heartpolik/hardware-pocket-mixer/digital-mixer/README.md

# digital-mixer

Портативний цифровий стереомікшер з USB-аудіоінтерфейсом. Від teenage engineering TX-6 беремо
формфактор і функції (EQ, компресор, ефекти, cue, сцени, MIDI, рекордер), але не схемотехніку.

> [!NOTE]
> Стан: плата розведена ([docs/04-pcb.md](docs/04-pcb.md)), прошивка 0.2 з емулятором ([docs/06-firmware.md](docs/06-firmware.md)), схема — [docs/03-schematic.md](docs/03-schematic.md); ТЗ — [docs/01-spec.md](docs/01-spec.md), дослідження — [docs/00-research.md](docs/00-research.md). Наступний крок — макет на готових
> платах: Teensy 4.1 + PCM1865 + PCM5102A, перевірка USB-аудіо 8 каналів у Windows, macOS та iOS.

```mermaid
flowchart LR
    IN(["4 стерео входи"]) --> ADC["2 × PCM1865<br/>TDM"] --> T["Teensy 4.1<br/>мікс, EQ, компресор,<br/>2 FX-шини, метри"]
    T --> DAC["3 × PCM5102A"] --> OUT(["MAIN, AUX,<br/>навушники"])
    T <-->|"USB HS: 8 вх / 2 вих,<br/>MIDI"| PC(["DAW"])
    T --> SD[("microSD<br/>рекордер")]
    UI["Фейдери, 12 енкодерів,<br/>кнопки, дисплей 1,47″"] <--> T
```

| Документ | Зміст |
|---|---|
| [docs/00-research.md](docs/00-research.md) | TX-6, варіанти архітектури, канали й USB, живлення, функції, ризики |
| [docs/01-spec.md](docs/01-spec.md) | **ТЗ Rev 1:** функціонал, керування, роз'єми, ТТХ |
| [docs/02-components.md](docs/02-components.md) | Фейдери, енкодери, живлення 1S, монтаж Teensy, AliExpress чи JLCPCB |
| [docs/03-schematic.md](docs/03-schematic.md) | **Принципова схема** (KiCad, [PDF](hw/main/main.pdf)), виводи Teensy, макет розташування |
| [docs/04-pcb.md](docs/04-pcb.md) | **Плата:** чотиришарова 104,5 × 136,5 мм (компоновка C), Teensy на гребінках з PSRAM (DM35), розведена, DRC 0 порушень, 0 розривів |
| [docs/05-fab.md](docs/05-fab.md) | **Виготовлення:** Gerber, BOM, файли PCBA для NextPCB, [інтерактивний BOM](docs/ibom/ibom.html), порядок ручного монтажу |
| [docs/07-review.md](docs/07-review.md) | **Перевірка перед замовленням:** що знайдено й виправлено, що перевірено, що звірити; покращення до наступної версії |
| [docs/06-firmware.md](docs/06-firmware.md) | **Прошивка й емулятор:** ядро C++ ([firmware/](firmware/README.md)), емулятор на SDL2, керування, ефекти, MIDI CC, що перевірити на макеті |
| [docs/calc/](docs/calc/power.py) | Розрахунок живлення |
| [docs/decisions.md](docs/decisions.md) | Журнал рішень цифрового підпроєкту (DM1…) |
| [docs/datasheets/](docs/datasheets/README.md) | Datasheets цього підпроєкту |

З аналогового [Rev A](../analog-mixer/README.md) переносимо деталі там, де вони підходять:
USB-C GCT USB4085, захист USBLC6-2SC6, MBR0530 і AO3401A (load sharing).

## Ліцензія

SPDX-License-Identifier: GPL-3.0-or-later — повний текст у [LICENSE](LICENSE). Стосується всього в
`digital-mixer/`: схеми, плати, бібліотек, документації й прошивки (DM36).

Цифрова версія не є похідною від mixerli: файлів звідти в ній немає (джеки — PJ-327A, footprint і модель
згенеровано тут за кресленням продавця, DM38). Чужі файли зберігають свої ліцензії:
символ Teensy 4.1 від XenGi — MIT ([hw/lib/third_party](hw/lib/third_party/LICENSE-teensy_library.txt));
стандартні бібліотеки KiCad — за їхньою ліцензією з винятком для проєктів; datasheets — власність
виробників.
