heartpolik/hardware-pocket-mixer/docs/datasheets/README.md

# Datasheets

Усі datasheets і креслення, на які посилається документація. Нові файли кладемо сюди й
додаємо рядок у таблицю. Позначка «mixerli» означає, що файл узято з
[mixerli/documentation/datasheets](https://github.com/stahlnow/mixerli/tree/master/documentation/datasheets).

| Файл | Компонент | Де використано | Джерело |
|---|---|---|---|
| [adg1436.pdf](adg1436.pdf) | ADI ADG1436, dual SPDT ±15 V, rev. B | ключі Mute, моно/стерео (D21, D31) | analog.com, поклав користувач |
| [dg411-dg413-vishay.pdf](dg411-dg413-vishay.pdf) | Vishay DG411/412/413, rev. E 2007 | кандидат ключів: DG413 (06, п. 3.0) | CERN mirror |
| [dg403.pdf](dg403.pdf) | Intersil/Renesas DG401/DG403, FN3284.11 | запасний ключ | CERN mirror |
| [MCP23017.pdf](MCP23017.pdf) | Microchip MCP23017, DS20001952D | розширювач: ключі | microchip.com |
| [MCP23008.pdf](MCP23008.pdf) | Microchip MCP23008, DS20001919F | розширювач: кнопки Mute | microchip.com |
| [ads7828.pdf](ads7828.pdf) | TI ADS7828, 12 біт, 8 каналів, I²C | АЦП метрів | ti.com |
| [esp32-c3_datasheet_en.pdf](esp32-c3_datasheet_en.pdf) | Espressif ESP32-C3, v2.4 | MCU (D27) | espressif.com |
| [tps62933o.pdf](tps62933o.pdf) | TI TPS6293x, SOT-583 | buck 5 V (D22) | ti.com |
| [1930f.pdf](1930f.pdf) | ADI/LT LT1930/LT1930A, boost | +12 V (D18) | mixerli |
| [1931fa.pdf](1931fa.pdf) | ADI/LT LT1931/LT1931A, інвертор | −12 V (D18) | mixerli |
| [sumida_CR43_Series-464629.pdf](sumida_CR43_Series-464629.pdf) | Sumida CR43, дросель | +12 V | mixerli |
| [sumida_CLS62-334945.pdf](sumida_CLS62-334945.pdf) | Sumida CLS62, спарений дросель | −12 V | mixerli |
| [74404054680-321151.pdf](74404054680-321151.pdf) | Würth 74404054680, дросель | mixerli v2 | mixerli |
| [opa1678.pdf](opa1678.pdf) | TI OPA167x, аудіо op-amp | кандидат для тракту (07) | ti.com |
| [tl062.pdf](tl062.pdf) | TI TL06x (TL061/062/064), low-power JFET op-amp | детектори метрів: TL064AC (D34, 08) | ti.com |
| [NJM4580_E-218114.pdf](NJM4580_E-218114.pdf) | Nisshinbo NJM4580, dual op-amp | аудіотракт | mixerli |
| [RS__1-1370683.pdf](RS__1-1370683.pdf) | Alps RS Super Slide, каталог | фейдери (D1, D23) | mixerli |
| [RK14K12-1370745.pdf](RK14K12-1370745.pdf) | Alps RK14K, каталог | send, pan, навушники (D10, D26) | mixerli |
| [pta.pdf](pta.pdf) | Bourns PTA, фейдери | альтернатива | mixerli |
| [PTVPTT-56034.pdf](PTVPTT-56034.pdf) | Bourns PTV/PTT, ротатори | альтернатива | mixerli |
| [SSSS9-1370708.pdf](SSSS9-1370708.pdf) | Alps SSSS9, слайд-перемикач | вимикач живлення | mixerli |
| [alps-rsxx1-series.pdf](alps-rsxx1-series.pdf) | Alps RS□□1 Super Slide, каталог 2026 | **`RS451121400A`, кресл. 20** (D1, D23) | користувач |
| [sj-4351x-smt-series.pdf](sj-4351x-smt-series.pdf) | CUI SJ-4351X-SMT, джек 3,5 мм TRRS | усі джеки (D8) | користувач |
| [dg417l.pdf](dg417l.pdf) | **Maxim** DG417L/418L/419L, ±4,5…±20 V | запасний ключ | користувач |
| [ip2326.pdf](ip2326.pdf) | Injoinic/ChipSourceTek IP2326, 2S/3S boost-зарядка (китайською) | модуль заряджання (D16) | користувач |
| [CH340DS1.pdf](CH340DS1.pdf) | WCH CH340 (усі варіанти), версія 3B | міст USB-UART CH340N (D40) | SparkFun CDN |
| [esp32-c3-supermini.pdf](esp32-c3-supermini.pdf) | ESP32-C3 SuperMini: розпиновка, **принципова схема**, розміри | MCU (D27, D40) | користувач |
| [img/esp32-c3-supermini.jpg](img/esp32-c3-supermini.jpg) | розпиновка ESP32-C3 SuperMini | MCU (D27) | mini-tech.com.ua |
| [nichicon-uep.pdf](nichicon-uep.pdf) | Nichicon UEP, неполярні електроліти (bi-polarized), радіальні | вхідні 10 µF (D38, D44), вихідні 47 µF | chipdip mirror |
| [bourns-srn4018.pdf](bourns-srn4018.pdf) | Bourns SRN4018, дроселі 4 × 4 мм | 4,7 µH для TPS62933O (D46) | bourns.com |
| [sn74ahct1g125.pdf](sn74ahct1g125.pdf) | TI SN74AHCT1G125 | перетворювач рівня даних LED | ti.com |
| [cts-204.pdf](cts-204.pdf) | CTS Series 204 DIP, rev. D 2021 | моно/стерео: 204-125ST (D47) | користувач |
| [oled-0.96-128x64-4pin.pdf](oled-0.96-128x64-4pin.pdf) | OLED 0,96" 128×64 SSD1306, 4 виводи (Rajguru) | дисплей | користувач |
| [alps-ec12d.pdf](alps-ec12d.pdf) | Alps EC12E/EC12D, енкодери 12 мм | енкодер: референс EC12D з кнопкою | користувач |
| [SK6812MINI-E.pdf](SK6812MINI-E.pdf) | OPSCO SK6812MINI-E, адресний RGB LED, Rev. 04 | індикація (D36) | akizukidenshi.com |
| [MX2A_RED-Datasheet-EN_US.pdf](MX2A_RED-Datasheet-EN_US.pdf) | Cherry MX2A Red | кнопки Mute (D30) | SparkFun CDN |
| [ujc-hp-3-smt-tr.pdf](ujc-hp-3-smt-tr.pdf) | CUI UJC-HP-3-SMT-TR, USB-C power-only | mixerli; у нас замінюється (D25) | mixerli |
| [MCP73831-Family-Data-Sheet-DS20001984H.pdf](MCP73831-Family-Data-Sheet-DS20001984H.pdf) | Microchip MCP73831 | mixerli; у нас скасовано (D16) | mixerli |
| [shouhan-msk12c02.pdf](shouhan-msk12c02.pdf) | SHOU HAN MSK12C02, SPDT слайд, SMD, повзунок убік; креслення й посадкове місце (с. 1) | **вимикач живлення (D51)** | LCSC C431540 |
| [ao3401a.pdf](ao3401a.pdf) | AOS AO3401A, P-MOSFET −30 V, SOT-23, rev 3.1 | ключ живлення (D51) | aosmd.com |
| [sungmun-ssi-10.pdf](sungmun-ssi-10.pdf) | Sungmun SSI-10 (колишня BSI-10), слайд THT, 12 V 0,5 A | розглянуто для вимикача (D51) | LCSC |
| [sungmun-ssi-nsi-10-catalog.pdf](sungmun-ssi-nsi-10-catalog.pdf) | Sungmun SSI / NSI-10 / NSI-20, каталог: варіанти H, S, HS | розглянуто (D51): NSI-10HS має повзунок угору | elitaliaweb.it |
| [pcm1865.pdf](pcm1865.pdf) | TI PCM186x, SLAS831D, АЦП 4 канали, TSSOP-30 | дослідження цифрового варіанту ([16](../16-digital.md)) | ti.com |
| [pcm5102a.pdf](pcm5102a.pdf) | TI PCM510xA, ЦАП стерео 2,1 Vrms, TSSOP-20 | дослідження цифрового варіанту ([16](../16-digital.md)) | ti.com |

## Ще не знайдено

| Компонент | Що потрібно | Чому немає |
|---|---|---|
| C&K JS (слайд SPDT) | креслення | ckswitches.com не віддає PDF скрипту |
