heartpolik/hardware-pocket-mixer/digital-mixer/docs/datasheets/README.md

# Datasheets — цифровий мікшер

Datasheets, на які посилається документація цифрового підпроєкту. Спільні з аналоговим —
у [analog-mixer/docs/datasheets](../../../analog-mixer/docs/datasheets/README.md).

| Файл | Компонент | Де використано | Джерело |
|---|---|---|---|
| [pcm1865.pdf](pcm1865.pdf) | TI PCM186x, SLAS831D, АЦП 4 канали, TSSOP-30 | АЦП входів ([00](../00-research.md), п. 5) | ti.com |
| [pcm5102a.pdf](pcm5102a.pdf) | TI PCM510xA, ЦАП стерео 2,1 Vrms, TSSOP-20 | ЦАП виходів ([00](../00-research.md), п. 5) | ti.com |
| [tps63802.pdf](tps63802.pdf) | TI TPS63802, buck-boost 2 A, VSON-10 | живлення 1S ([02](../02-components.md), п. 4) | ti.com |
| [lp5907.pdf](lp5907.pdf) | TI LP5907, LDO 250 mA, малошумний | 3,3 V аналог кодеків ([02](../02-components.md), п. 4) | ti.com |
| [tp4056.pdf](tp4056.pdf) | NanJing Top Power TP4056, лінійний заряд 1S 1 A | заряд ([02](../02-components.md), п. 4) | sparkfun.com |
| [bourns-pec09.pdf](bourns-pec09.pdf) | Bourns PEC09, енкодер 9 мм, rev. 09/19 | порівняння енкодерів ([02](../02-components.md), п. 3) | bourns.com |
| [tpa6132a2.pdf](tpa6132a2.pdf) | TI TPA6132A2, підсилювач навушників DirectPath, WQFN-16 | навушники ([03](../03-schematic.md)) | ti.com |
| [kailh-choc-pg1350.pdf](kailh-choc-pg1350.pdf) | Kailh PG1350 (CPG135001D01), креслення й характеристики | розглянуто (DM13, скасовано DM16) | adafruit.com (копія Kailh) |
| [midi-electrical-spec-update.pdf](midi-electrical-spec-update.pdf) | MMA CA-033, MIDI 1.0 Electrical Specification Update (2014) | MIDI OUT 3,3 V ([03](../03-schematic.md)) | midi.org |
| [gmt147-01m-drawing.webp](gmt147-01m-drawing.webp) | GMT147-01M (GMT147SPI) 1.47in TFT, креслення продавця: розміри, гребінка 8 × 2,54, отвори | footprint `LCD_GMT147SPI` | від користувача (продавець) |
| [tsf-1266-drawing.png](tsf-1266-drawing.png) | TSF-1266 6 × 6 × 5 SMT tact, креслення й посадкове місце | footprint `SW_TSF-1266_6x6mm_SMD` | від користувача (продавець) |
| [push-latching-dpdt-5.8-7mm-drawing.png](push-latching-dpdt-5.8-7mm-drawing.png), [push-latching-dpdt-7mm-pins.png](push-latching-dpdt-7mm-pins.png) | кнопка з фіксацією DPDT 5,8 / 7 мм (вивідна), креслення й схема контактів | розглянуто (DM17, замінено DM27) | від користувача (продавець) |
| [push-latching-dpdt-5.8mm-smd-drawing.png](push-latching-dpdt-5.8mm-smd-drawing.png) | кнопка з фіксацією DPDT 5,8 × 5,8 SMD: розміри, ніжки, схема FREE / PUSH, DC 30 V 0,1 A | footprint `SW_Push_Latching_DPDT_5.8mm_SMD` (DM27) | від користувача (продавець) |
| [ec12sy-smd-encoder-drawing.png](ec12sy-smd-encoder-drawing.png) | енкодер EC12SY-H6-…-SMD з кнопкою: корпус, вал, посадкове місце | footprint `RotaryEncoder_EC12SY_SMD` (DM26) | від користувача (продавець) |
| `gct-usb4110.pdf` (у git не кладемо: креслення GCT позначене як конфіденційне) | GCT USB4110, USB-C 2.0 SMT, креслення rev. B4 | USB-C (DM30), стоковий footprint KiCad, 3D-модель | [gct.co/files/drawings/usb4110.pdf](https://gct.co/files/drawings/usb4110.pdf) — завантажити браузером у цю теку |
| [bourns-pta.pdf](bourns-pta.pdf) | Bourns PTA, повзункові потенціометри, rev. 08/25 | фейдер PTA2043 (DM8; замінено DM39) | bourns.com |
| [teensy41-dimensions.png](teensy41-dimensions.png), [teensy41-card-back.png](teensy41-card-back.png) | PJRC Teensy 4.1: розміри, картка виводів (зворот) | footprint `Teensy41_SMD` | pjrc.com |
| [coilcraft-xfl4015.pdf](coilcraft-xfl4015.pdf) | Coilcraft XFL4015, Doc 769, rev. 03/10/26 | дросель TPS63802 | coilcraft.com |
| [mcp23017.pdf](mcp23017.pdf) | Microchip MCP23017/MCP23S17, DS20001952D, розширювач 16 GPIO I²C | регістри розширювачів у прошивці ([06](../06-firmware.md), п. 6) | microchip.com |
| `st7789v.pdf` (у git не кладемо: позначений «Sitronix Confidential») | Sitronix ST7789V v1.3 (2014/03), контролер TFT 240 × 320 | драйвер дисплея GMT147SPI ([06](../06-firmware.md), п. 6) | [newhavendisplay.com](https://www.newhavendisplay.com/appnotes/datasheets/LCDs/ST7789V.pdf) — завантажити в цю теку |
| [pj-327a-hooya.pdf](pj-327a-hooya.pdf) | HOOYA (Haoyu) PJ-327A, джек 3,5 мм SMT 5 виводів, rev. A1 2020: розміри, **посадкове місце** (5 × 1,6 × 2,9), схема контактів | звірка footprint PJ-327A (DM38) | lcsc.com, C19712376 |
| [pj-327a-xkb.pdf](pj-327a-xkb.pdf) | XKB PJ-327AX-SMT, rev. A1 2024: розміри, посадкове місце, схеми варіантів A0–A5 | звірка footprint PJ-327A (DM38) | lcsc.com, C381135 |
| [pj-327a-sofng.pdf](pj-327a-sofng.pdf) | SOFNG PJ-327A: розміри, характеристики 0,25 A 12 V | звірка footprint PJ-327A (DM38) | lcsc.com, C22355751 |
| [pj-327a-seller-drawing.jpg](pj-327a-seller-drawing.jpg) | PJ-327A 5 виводів, креслення продавця AliExpress: розміри, посадкове місце (5 × 2 × 3, ±0,1), схема контактів | footprint `Jack_3.5mm_PJ-327A_SMT_Horizontal` (DM38) | від користувача (продавець, [AliExpress](https://www.aliexpress.com/item/1005006127348664.html)) |
| [alps-rs-super-slide.pdf](alps-rs-super-slide.pdf) | Alps Alpine RS□□1 Super Slide (Standard Type), каталог с. 386–397: лінійка, **креслення № 1 — RS201111J011** (35 × 8, хід 20, отвори 3 × Ø1,5: 25 і 3,75 мм, 2 × M2 зверху), характеристики | footprint `Potentiometer_Alps_RS20111_Single_Slide`, 3D-модель (DM39) | static.chipdip.ru (копія каталогу Alps) |
| [fader-rs20111-seller-photo.png](fader-rs20111-seller-photo.png), [fader-rs20111-seller-drawing.png](fader-rs20111-seller-drawing.png), [fader-rs20111-seller-pins.png](fader-rs20111-seller-pins.png), [fader-rs20111-seller-holes.png](fader-rs20111-seller-holes.png) | фейдер Alps 147C-10KB (AliExpress): фото з важелем 15 мм, креслення, схема виводів, отвори — збігаються з кресленням № 1 Alps | фейдер (DM39) | від користувача (продавець) |
