heartpolik/hardware-pocket-mixer/analog-mixer/docs/spec-rev-a.md

# Portable 4-Channel Stereo Mixer — Rev A

Повне ТЗ і контекст проєкту (handoff).

- **Актуально на:** 24 жовтня 2026
- **Мова:** українська
- **Статус:** вимоги й попередня архітектура визначені. Повна перевірена схема,
  KiCad PCB, BOM і Gerber-файли ще **НЕ** створені. Цей документ — handoff,
  а не твердження про готовий дизайн.

## 1. Мета

Розробити компактний портативний аналоговий 4-канальний стереомікшер для
синтезаторів, драм-машин, семплерів та інших line-level пристроїв. ESP32-C3
потрібен для UI, дисплея, метерів і логіки кнопок; цифрової обробки звуку в
Rev A немає.

Пріоритети: компактність, реальні компоненти з доступністю/доставкою в Україну,
можливість ручного монтажу, ремонтопридатність. Перевага TSSOP над QFN там, де є
технічно адекватний вибір; пасивні компоненти переважно 0805. Усі компоненти та
footprint мають бути підтверджені до замовлення PCB.

## 2. Функціональне ТЗ

### Аудіо

> **Рішення D4 (24.10.2026):** додано FX-петлю за зразком mixerli: 4 post-fader
> стерео send-ротатори → SEND OUT, вхід 5 = стерео return із фейдером, без send.
> Див. [decisions.md](decisions.md).

- 4 незалежні стереовходи, роз’єми 3,5 мм TRS.
- Стереовихід Line Out L/R.
- Окремий вихід навушників із відповідним підсилювачем.
- Аналоговий звуковий тракт, без DSP у Rev A.
- Не з’єднувати L/R між собою для метерів; стереоканали мають залишатися
  незалежними.

### Фейдери

> **Рішення 24.10.2026:** канали — Alps `RS451121400A` (dual 10k B, хід 45 мм,
> довжина 60 мм). Це відміняє вимогу ходу 20–30 мм нижче. Деталі й кандидат на
> Master — [01-faders.md](01-faders.md).

- 4 стереофейдери каналів: по одному dual-gang slider на канал, який одночасно
  регулює L і R.
- 2 незалежні монофейдери Master: один для L, один для R.
- Бажано паяти фейдери безпосередньо на верхню плату.
- Бажаний хід компактних фейдерів: приблизно 20–30 мм; 45 мм загальної довжини
  корпуса — запасний варіант, якщо механічно підходить.
- 10 kΩ — попередній кандидат, але остаточний номінал залежить від топології,
  джерельних і навантажувальних імпедансів.
- B10K зазвичай означає лінійну характеристику; A/log — аудіо/логарифмічну, але
  маркування треба перевіряти для конкретного виробника.
- Для каналів потрібні саме dual-gang фейдери з двома електрично окремими
  секціями. Для Master — два окремі mono бажаніші за використання лише однієї
  секції dual-gang.

### Кнопки та UI

- По одній кнопці на канал.
- Коротке натискання канальної кнопки: Mute toggle.
- Утримувати кнопку енкодера (Shift) і натиснути канальну кнопку: Solo toggle.
- Енкодер: обертання — навігація/регулювання; коротке натискання —
  підтвердження в меню.
- Solo non-destructive: не змінює збережений стан Mute.
- Якщо активний хоча б один Solo, звучать лише канали із Solo, які не в Mute.
- Mute має пріоритет над Solo.
- У прошивці передбачити debounce та визначити поведінку одночасних/довгих
  натискань.

### Дисплей і LED

- OLED 128×64.
- Показувати 4 канальні метри, Master L/R, CLIP і стан батареї.
- 6 адресних RGB LED: 4 каналам (статус/clip), 2 Master L/R (clip).
- Один data GPIO для WS2812/SK6812-сумісних LED.
- Обмежити яскравість програмно. Якщо LED живляться від 5 V, перевірити потребу
  level shifter; передбачити серійний резистор data та локальний bulk capacitor.
- Не дозволяти LED-струмам і ESP32/boost шуміти в аналоговому тракті.

### Живлення

> **Рішення D5 (24.10.2026):** аналог живиться від ±12 V, цифра — від окремого 5 V.
> Рейл 5 V + VREF для аудіо з розділу 5 скасовано. Див. [decisions.md](decisions.md).

- Однокомірковий LiPo pouch, початковий орієнтир 1500 mAh.
- USB-C для заряджання.
- Кандидат зарядного контролера з power-path: BQ24074.
- Кандидат boost до 5 V: TPS61023.
- Акумулятор має бути захищеним або захист треба реалізувати на платі.
- Перевірити USB-C CC-резистори, захист входу, струм заряджання під конкретну
  батарею, тепловиділення, вимірювання напруги, роботу під час заряджання,
  пікове споживання та EMI boost-конвертера.
- BQ24074/TPS61023 — кандидати, не затверджена схема живлення.

## 3. Дві плати

> **Рішення D19 (24.10.2026):** фейдери й ротатори стоять на нижній аналоговій платі.
> Цифрова плата (ESP32, OLED, кнопки, LED) — зверху, лише над зоною задніх джеків.
> Опис нижче частково застарів. Див. [decisions.md](decisions.md).

### Верхня плата — controls/UI/faders

- 4 dual-gang канальні фейдери.
- 2 mono Master-фейдери.
- 4 кнопки каналів, енкодер із кнопкою.
- OLED, ESP32-C3 SuperMini або інший перевірений ESP32-C3-модуль.
- 6 адресних RGB LED.
- Допоміжні компоненти й роз’єми.

Це не суто цифрова плата: фейдери несуть аналоговий аудіосигнал. Трасувати ці
сигнали окремо від шумних цифрових/силових ліній із контрольованими шляхами
повернення струму.

### Нижня плата — analog/audio/power

- 4 TRS входи 3,5 мм.
- Line Out L/R і вихід навушників.
- Буфери та суматор.
- Аналогова реалізація Mute/Solo.
- Детектори піків/огинаючої для метерів.
- Headphone amp.
- Живлення/заряджання/батарейний інтерфейс, якщо розміщення не погіршує
  шум/механіку.
- ADC, якщо він потрібен після остаточного вибору архітектури метерів.

### Міжплатне з’єднання

- Попередня ідея: PLS/PBS pin/socket headers.
- Перед PCB створити перевірену таблицю pinout: аудіо L/R, керування, живлення,
  землі/повернення, метер-сигнали.
- Виділити достатньо ground pins і не вести чутливе аудіо без потреби поруч із
  LED/тактовими/boost сигналами.
- Не розділяти AGND/DGND на ізольовані острови автоматично: важливі реальні
  шляхи струму повернення та компонування.

## 4. Попередні електронні кандидати (не фінальні)

| Вузол | Кандидат | Що перевірити |
|---|---|---|
| MCU | ESP32-C3 SuperMini | точна плата, габарити, GPIO, USB, струм |
| Quad op-amp | TLV9064 | корпус, шум, headroom, навантаження, стабільність |
| Headphone amp | TPA6130A2 | QFN 4×4 складний для ручного монтажу; оцінити альтернативи |
| ADC | MCP3208 | чи потрібен окремий ADC взагалі |
| Charger/power path | BQ24074 | схема USB-C, power-path, струм/тепло |
| Boost | TPS61023 | струм, ефективність, EMI, доступність |
| TRS jacks | SJ-43514-SMT-TR або SJ-43504-SMT  | footprint, механіка, availability |
| RGB LED | WS2812/SK6812-сумісні | конкретний корпус, живлення, data level |
| Faders | 10k dual/single gang | див. розділ 7 |

## 5. Аналоговий тракт і попередні розрахунки

У попередньому концепті обговорювалися:

- 5 V analog rail і VREF близько 2,5 V;
- TLV9064;
- інвертувальний суматор: Rf 3,3 kΩ, Rin 22 kΩ, коефіцієнт внеску каналу
  близько −0,15;
- вхідні coupling caps близько 2,2 µF;
- вихідні coupling caps 10 або 47 µF залежно від вузла;
- серійний вихідний резистор близько 100 Ω;
- VREF з дільника 10 kΩ і фільтрацією близько 47 µF.

Це лише стартові припущення. Не переносити їх у фінальну схему без перерахунку й
перевірки. Потрібні аналіз headroom на 5 V, джерельних імпедансів, завантаження
фейдерів, worst-case сумування 4 сигналів, вихідного навантаження, шуму,
DC-offset, кліпінгу та headphone drive.

Раніше як приклад рахували чотири синфазні входи по 2 Vrms при коефіцієнті 0,15
на кожен: приблизно 1,2 Vrms на сумі (1,70 V peak) навколо VREF. Цей результат
не є гарантією запасу до кліпінгу — перевірити для повної топології.

### Mute/Solo

Потрібно вибрати конкретну аналогову реалізацію: analog switch, FET/транзистор
або іншу схему. Перевірити on-resistance, leakage, distortion, рівні керування,
клацання/pop і доступність. Не підключати GPIO безпосередньо до аудіосхеми без
перевірки електричних параметрів.

### Метри

- Не з’єднувати L/R.
- Один канальний метр може показувати max(envelope(L), envelope(R)) після
  окремих детекторів або коректної ізольованої логіки.
- Master L/R бажано міряти окремо.
- Визначити attack/release, масштабування для ADC та семантику CLIP: реальний
  кліпінг, near-clip threshold чи оцінка рівня.

## 6. Механіка та тестові точки

> **Рішення 24.10.2026:** фіксованого габариту немає. KPI — мінімальний корпус,
> який дозволяє обрана елементна база (фейдери, роз’єми, батарея, OLED).
> Габарит виводиться з компонування в кроці B, а не задається наперед.

~~Попередній габарит корпусу: 100–115 × 60–75 × 20–28 мм~~ — скасовано.

Перед outline/footprints:

1. Зібрати datasheet/механічні креслення фейдерів, роз’ємів, OLED, енкодера,
   кнопок, батареї.
2. Намалювати top-view у масштабі.
3. Перевірити хід фейдерів, відступи ручок, USB-C, глибину батареї, висоту
   роз’ємів і міжплатний роз’єм.
4. Переконатися, що корпус не тисне на LiPo.

Не створювати footprint фейдера за фото без підтвердження розмірів, виводів,
монтажних лапок, pin numbering і відповідності двох секцій.

Попередні test points (остаточна кількість залежить від схеми):

- +5V, VREF, GND у кількох місцях;
- входи після фейдерів L/R × 4;
- SUM L/R;
- MASTER L/R;
- LINE OUT L/R;
- ENV1–ENV4;
- ENV_MASTER_L/R;
- BAT.

Цільовий діаметр тестових pad близько 1,5–2 мм, підписані на silk, із доступною
землею поблизу.

## 7. Пошук фейдерів — стан на 24.10.2026

### Параметри

Канали: 4 × stereo dual-gang; Master: 2 × mono. Бажаний хід 20–30 мм.

10 kΩ — лише попередній номінал. Потрібно знайти компоненти, які реально можна
замовити на AliExpress із доставкою в Україну. Не замовляти партію до перевірки
pinout і механіки.

### Раніше знайдені варіанти в Україні

1. **ZTDE 10kBx2 stereo**, заявлені загальна довжина 45 мм і хід 30 мм,
   приблизно 92 грн:
   <https://prom.ua/ua/p2833891052-fejder-dlya-klavish.html>
   Перевірити розміри, pinout, актуальну наявність. B10K лінійний — можливо для
   прототипу, але відчуття гучності відрізняється від log.
2. **APAI Electronics 10kAx2 stereo**, заявлені довжина 75 мм і хід 60 мм,
   приблизно 104 грн:
   <https://prom.ua/ua/p2829398551-fejder-dlya-mikshernyh.html>
   Ймовірно завеликий.
3. **ALPHA 73 mm B10K**, близько 363 грн, раніше в оголошенні було 3 шт.:
   <https://djservice.com.ua/ua/p2166542978-fejder-alpha-73mm.html>
   Перевірити, mono чи dual-gang; не пріоритетний через розмір/ціну.
4. **Generic 75 mm stereo B10K**:
   <https://rozetka.com.ua/ua/483070344/p483070344/>
   Завеликий для бажаного компактного формату.

### Попередні AliExpress посилання — НЕ вважати підтвердженими

- Кандидат на mono B10K близько 45 мм:
  <https://www.aliexpress.com/item/1005009291972560.html>
- Кандидат на dual-gang stereo 10k, у назві/описі фігурував хід близько 60 мм:
  <https://www.aliexpress.com/item/1005010483791687.html>
- Пошукова добірка:
  <https://www.pricearchive.org/search/aliexpress.com/alps-%D1%81%D0%BB%D0%B0%D0%B9%D0%B4-%D0%BF%D0%BE%D1%82%D0%B5%D0%BD%D1%86%D0%B8%D0%BE%D0%BC%D0%B5%D1%82%D1%80%D1%8B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>

Ці AliExpress посилання раніше не були достатньо перевірені за механічним
кресленням, pinout і реальним варіантом товару. Два згадані mono-кандидати
виявилися одним і тим самим оголошенням — попередню відповідь потрібно виправити
під час наступного пошуку.

### Наступний пошук

Пошукові фрази:

- `dual gang slide potentiometer 10k B10K 30mm travel`
- `stereo slider potentiometer 10k 20mm travel`
- `mini stereo slide potentiometer 6 pin 10k`
- `dual linear slider potentiometer 10k PCB`

Шукати пару моделей однієї серії: dual-gang для каналів і mono для Master.
Перевіряти доставку до України, ціну/кількість, taper, габарити, хід, контакти й
кріплення. Запросити у продавця креслення або фото з лінійкою та pinout. Не
фіксувати footprint без підтвердження.

## 8. KiCad і фінальний пакет

Порядок:

1. Вибір компонентів і механіка.
2. Повна принципова схема.
3. Таблиця pinout між платами.
4. Розрахунки audio headroom, power budget, Mute/Solo, метерів і шуму.
5. KiCad-проєкт із двома платами.
6. ERC: виправити або обґрунтувати кожну помилку/попередження.
7. Footprints лише за підтвердженими datasheet/розмірами.
8. PCB placement/routing з урахуванням аналогових, цифрових і силових струмів.
9. DRC і виправлення критичних помилок.
10. BOM із MPN, корпусом, кількістю, джерелом і статусом підтвердження.
11. Gerber/drill, PDF-схеми, монтажні креслення, за потреби pick-and-place.
12. Перевірити, що всі файли реально існують, відкриваються й узгоджені.

Фінальний пакет має включати KiCad project, PDF схем, PCB двох плат, BOM, pinout,
Gerber + drill, механічний план і інструкцію першого запуску.

## 9. Перевірка прототипу

- **Живлення:** USB-C, заряджання, захист батареї, idle/peak current, нагрівання,
  просідання boost, час роботи, шум конвертера.
- **Аудіо:** DC-offset, шум без сигналу, вплив ESP32/LED/boost, gain/headroom,
  кліпінг на 1 і 4 каналах, Mute/Solo clicks/bleed, headphone drive, L/R
  balance, стереотрекінг фейдерів, частотна характеристика й спотворення.
- **UI:** OLED, кнопки, encoder, debounce, Mute/Solo logic, метерне
  калібрування, attack/release, clip indication, обмеження LED-яскравості.
- **Механіка:** доступ до USB-C/роз’ємів, відсутність конфлікту ручок, міцність
  кріплення плат, відсутність тиску на LiPo.

## 10. Відкриті питання / ризики

1. Не обрані підтверджені компактні dual-gang і mono фейдери з AliExpress.
2. ~~Не підтверджений габарит корпуса.~~ Габарит не фіксується — мінімальний
   під елементну базу (див. розділ 6).
3. Не затверджена аналогова схема сумування й номінали.
4. Потрібно вибрати реалізацію Mute/Solo з низьким шумом і клацаннями.
5. TPA6130A2 може бути незручним для ручного монтажу через QFN; оцінити
   альтернативи.
6. Не визначено, чи потрібен MCP3208 або вистачить іншого способу зчитування
   метерів.
7. Не завершені power-path, USB-C, battery protection, peak-current та EMI
   перевірки.
8. Немає готових перевірених KiCad-файлів, PCB, BOM чи Gerber.
9. Наявність, ціни й доставка маркетплейсів змінюються — перевіряти перед
   закупівлею.

## 11. Конкретний план продовження

- **A. Фейдери:** знайти й підтвердити dual-gang 10k stereo 20–30 мм ходу та
  сумісний mono 10k для Master. Перевірити механіку, pinout, taper і доставку.
- **B. Механіка:** зробити масштабний top-view; після цього зафіксувати board
  outline.
- **C. Схема:** визначити повний signal flow: TRS inputs → coupling/protection →
  channel faders → Mute/Solo → summing/buffer → Master L/R → Line Out; окремо
  визначити headphone feed/control і метери.
- **D. Роз’єм між платами:** скласти pinout із групуванням аудіо, control, power
  і ground.
- **E. KiCad:** створити реальну схему, дві плати, BOM, ERC/DRC; потім
  виробничі файли.
