heartpolik/hardware-pocket-mixer/digital-mixer/docs/07-review.md

# 07. Перевірка перед замовленням плати

> [!NOTE]
> **28.10.2026**, плата після DM35 (Teensy на гребінках). Перевірка зі списку з'єднань схеми
> (`kicad-cli sch export netlist`), datasheet із [datasheets/](datasheets/README.md), розведеної плати
> (`hw/main/main_routed.kicad_pcb`) і прошивки. Що знайдено й виправлено — п. 1; що перевірено й гаразд —
> п. 2; що лишається звірити до або під час замовлення — п. 3. Після виправлень: **ERC 0, DRC 0 порушень, 0 розривів,
> 0 розбіжностей зі схемою**, ізольованих груп GND немає.

## 1. Знайдено й виправлено

| # | Що | Чим загрожувало | Виправлення |
|---|---|---|---|
| 1 | **Ємність на виході LP5907 (+3V3A) ≈ 61 µF** (10 µF біля LDO + 5 × 10 µF біля кодеків + 8 × 100 nF) | datasheet LP5907 (SNVS798Q, 5.6 «Capacitance for stability»): COUT 0,7…10 µF; поза межею стабільність не гарантована — можливе збудження й шум в аналоговому живленні АЦП / ЦАП | 2,2 µF біля LDO (CL31B225KBHNNNE) + 1 µF біля кожного кодека (CL31B105KBHNNNE) + 100 nF = ≈ 8 µF; корпус 1206 той самий — розводка не змінилась |
| 2 | **D− / D+ Teensy під його micro-USB** — у DM35 я написав «2-штирьова гребінка в отвори Teensy» | за кресленням PJRC площадки USB device — 1,78 мм від торця USB, тобто під корпусом роз'єму з іншого боку модуля: штир крізь модуль не пройде | на платі нічого не змінилось (наскрізні отвори 66 / 67 лишаються); монтаж — тонкі дроти від площадок модуля крізь наші отвори, пропаяні зверху ([05](05-fab.md), п. 5) |
| 3 | **Переходи в площадках SMD** після ручних латок (C49, R43, R44, TPA6132A2, C72) | при машинній пайці припій стікає в отвір — непропай; найгірше на QFN TPA6132A2 | п. 1.1 |
| 4 | Прошивка: при живленні від USB VSYS ≈ 4,7 В — показувало 100 % батареї | хибний заряд | понад 4,35 В — «USB» замість заряду |

### 1.1 Переходи в площадках

Переходи, свердло яких заходить у площадку SMD-деталі (свердло — 0,3 мм), до і після:

| Де | До | Після |
|---|---|---|
| U11 TPA6132A2, виводи 2–3 (GND, QFN 0,5 мм) | перехід GND на межі виводів | **прибрано**; земля підсилювача — доріжкою від виводу 10 до сусіднього переходу GND |
| R43.1 (AUX_OL), R44.1 (AUX_OR), C49.1 (+3V3A) | перехід на краю площадки | **відсунуто**, кожен зсув перевірено DRC |
| U3 TP4056, теплова площадка | перехід GND | лишено: перехід у тепловій площадці потрібен для відводу тепла |
| C72 (2,2 µF 0805, HPVDD підсилювача), обидві площадки | перехід GND і HP_HPVDD на краю площадки | **лишено**: у найщільнішому вузлі (ЦАП CUE / TPA6132A2) жодне положення не пройшло DRC, а перехід GND — єдиний зв'язок землі групи ЦАП з площиною. Ризик — недостатня пайка C72: після монтажу перевірити його під лупою; площадки великі, отвір заходить лише краєм |

## 2. Перевірено — гаразд

| Що | Як перевірено | Результат |
|---|---|---|
| Нумерація виводів символів | список з'єднань проти таблиць виводів datasheet: PCM1865 (SLAS831D, с. 10–11), TPS63802 (табл. 7-1), TPA6132A2 (Pin Functions), LP5907 SOT-23 (табл. 4-2), TP4056 (опис виводів), PCM5102A, MCP23017, USBLC6-2SC6, AO3401A, USB4110 | усі збігаються |
| Номінали | TPS63802: 0,5 В × (1 + 665k / 91k) = **4,15 В**; TP4056: RPROG 2,4 кОм → 500 мА, TEMP на GND (контроль температури вимкнено — захист у самому акумуляторі); TPA6132A2: G0 = G1 = 0 → −6 dB, вхід 26,4 кОм, 1 µF → зріз ≈ 6 Hz, HPVDD 2,2 µF, HPVSS і накачка 1 µF | відповідають datasheet |
| Розподіл живлення USB / батарея | Q1 AO3401A: затвор на VBUS, стягнутий 100 кОм (R19); внутрішній діод BAT+ → VSYS; MBR0530 VBUS → VSYS | правильно: без USB батарея живить через транзистор, з USB — назад у батарею не йде |
| Межі напруг | VBUS ≤ 10 µF (один C4) — вимога USB; EN TPS63802 від VSYS ≤ 6 В; VSYS / 2 на A14 ≤ 2,35 В; MCLK2 24,576 MHz при IOVDD 3,3 В (межа 50 MHz) | у межах |
| Логічні рівні | 3,3 В Teensy → XSMT PCM5102A, EN TPA6132A2 (≥ 1,3 В), MCP23017, SCKI PCM1865 (вхід XI 1,8 В не використано — на GND) | сумісні |
| Шини I²C | Wire: PCM1865 0x4A / 0x4B (MS/AD); Wire2: MCP23017 0x20 / 0x21 / 0x22 (A0 / A1); підтяжки 4,7 кОм на обох | без конфліктів адрес |
| Плата ↔ прошивка | 30 сигналів Teensy (символ XenGi → виводи Teensy) проти `firmware/src/teensy/pins.h`; біти трьох MCP23017 проти `controls.cpp`; адреси PCM1865, слоти TDM | збігаються |
| Footprint Teensy на гребінках | ряди за кресленням PJRC (вид зверху, USB ліворуч → ряд GND, 0…12, 3V3, 24…32 знизу); модуль на нижньому боці лицем назовні — KiCad дзеркалить footprint, тож знизу видно саме вид зверху модуля | правильно |
| Штирі вивідних деталей | хвости штирів фейдерів, дисплея (знизу) і Teensy (зверху) проти контурів деталей іншого боку, запас 0,5 мм | жодного перетину |
| DRC / відповідність схемі | `kicad-cli pcb drc --schematic-parity` | 0 порушень, 0 розривів, розбіжностей немає; попередження — шовкографія, напрямні отвори джеків |

## 3. Звірити до або під час замовлення

1. **Дисплей GMT147SPI:** порядок 8 виводів footprint (1 GND, 2 VCC, 3 SCL, 4 SDA, 5 RES, 6 DC, 7 CS, 8 BLK) — за
   кресленням продавця; звірити з підписами на вашому модулі (він уже на макетці).
2. **Акумулятор:** у роз'ємі JST PH вивід 1 = BAT+, 2 = GND. Полярність JST PH у акумуляторів не стандартизована —
   перевірити мультиметром на обраному акумуляторі; навпаки — перекласти контакти в його роз'ємі.
3. **NextPCB:** ширина / зазор пари USB під 90 Ω на їхньому стеку (зараз 0,2 / 0,2 мм); 665k (RC0805FR-07665KL) і
   деталі «не для нових розробок» — погодити під час перевірки BOM; повороти деталей у файлі координат — звірити
   на погодженні (ключ першого виводу мікросхем, полярність діодів, світлодіодів і електролітів).
4. **Носики джеків PJ-327A виступають за край плати на 2 мм** (DM38; так задумано — в отвори корпусу). Джеки
   ставимо самі, але NextPCB для монтажу, скоріше за все, додасть технологічні поля; це в їхньому розрахунку.
5. **Зразки деталей ручного монтажу:** напрямні отвори EC12SY, ніжки кнопки живлення 5,8 мм (посадкові місця —
   за кресленнями продавців, `ОРІЄНТИР`), площадка VUSB на Teensy (фото PJRC, `ОРІЄНТИР`).
6. **Джек PJ-327A (DM38):** footprint — за кресленням продавця; на зразку звірити положення лапок штангенциркулем
   і контакти мультиметром (4 — кінчик, 3 — кільце, 1 і 2 — гільза). Після заміни джеків: ERC 0, DRC 0 порушень,
   0 розривів, 0 розбіжностей зі схемою (28.10.2026).
7. **Фейдер Alps RS201111J011 (DM39):** footprint — за кресленням № 1 каталогу Alps (і продавця); на зразку звірити
   отвори (25 і 3,75 мм) і що вивід 2 — повзунок. **Лапок кріплення немає:** фейдер тримається на трьох виводах
   0,4 × 1 мм, а Alps кріпить його двома гвинтами M2 у верхній грані до панелі — у корпусі передбачити панель з
   отворами M2 (31 мм між ними) або хоча б упор, інакше виводи ламатимуться від натискань. Після заміни: ERC 0,
   DRC 0 порушень, 0 розривів, 0 розбіжностей зі схемою (29.10.2026).

## 4. Покращення до наступної версії

Не в цю плату — розведену не чіпаємо.

1. **Hi-Z вхід для пасивної гітари.** Зараз вхідний опір — лінійний, як у TX-6: 100 kΩ на GND ∥
   (10 kΩ послідовно + 10 kΩ входу PCM1865, [datasheet](datasheets/pcm1865.pdf), с. 13) ≈ **17 kΩ**
   ([03](03-schematic.md)). Звукознімачу пасивної гітари потрібно 0,5–1 MΩ: при 17 kΩ і індуктивності ~2–3 H
   (`ОРІЄНТИР`, залежить від моделі) верхи завалюються вже від ~1 kHz, звук глухий і тихіший. Активна гітара,
   педаль, процесор, DI-бокс працюють і зараз (запас PGA до +32 dB мінус 6 dB дільника), пасивна — через педаль
   або DI-бокс. Що зробити: на IN1 (або IN1–2) буфер на ОП з входом ~1 MΩ, вмикати перемикачем або окремим
   гніздом; деталі SOIC / 0805, ОП підібрати з урахуванням споживання (KPI автономності). Моно-штекер TS
   замикає кільце на GND — сигнал лише в лівому каналі входу, канал ставити в «моно» (є в прошивці, D42).
