heartpolik/hardware-pocket-mixer/digital-mixer/docs/decisions.md

# Журнал рішень — цифровий мікшер

Номери **DM1…**, щоб не плутати з рішеннями D1–D59 аналогового Rev A
([analog-mixer/docs/decisions.md](../../analog-mixer/docs/decisions.md)). Загальні правила
(ручний монтаж D12, модулі D13, KPI D34) діють і тут — див. [CLAUDE.md](../../CLAUDE.md).

| № | Дата | Рішення | Статус | Обґрунтування |
|---|---|---|---|---|
| DM1 | 2026-10-26 | Цифровий мікшер — **окремий підпроєкт** `digital-mixer/`, Rev A лишається аналоговим | прийнято | щоб не плутати документацію й файли двох архітектур |
| DM2 | 2026-10-26 | Від TX-6 беремо **лише формфактор і функції** | прийнято | чипи TX-6 — у корпусах без виводів збоку (D12); [00](00-research.md), п. 1 |
| DM3 | 2026-10-26 | **4 стерео входи**; ефекти — усередині процесора, окремого FX-каналу й джеків send/return немає | прийнято | 8 каналів АЦП (2 × PCM1865 на одній лінії TDM) і 8 каналів USB — у межах готової бібліотеки; [00](00-research.md), п. 8 |
| DM4 | 2026-10-26 | Процесор — модуль **Teensy 4.1** | прийнято | USB High Speed, 2 порти I²S/TDM, Cortex-M7 600 MHz, microSD; оцінка навантаження 11–17 %; [00](00-research.md), п. 4–5, 8 |
| DM5 | 2026-10-26 | АЦП **PCM1865** × 2, ЦАП **PCM5102A** × 3 (MAIN, AUX, навушники) | попередньо | TSSOP, паяються паяльником; статус PCM1865DBTR у LCSC — «not recommended for new designs», перевірити PCM1865QDBTRQ1; [00](00-research.md), п. 5, 10 |
| DM6 | 2026-10-26 | Ручки каналів — **енкодери** (шари параметрів як у TX-6), фейдери — потенціометри | попередньо | потенціометр після зміни шару дає стрибок значення; [00](00-research.md), п. 9 |
| DM7 | 2026-10-26 | Вибір деталей: **спершу доступність** (Україна, AliExpress), потім компактність; для кожної — порівняння «AliExpress + паяльник» і «передзбирання JLCPCB / LCSC» | прийнято | замовлення може бути повністю з AliExpress або з PCBA JLCPCB; [02](02-components.md), п. 1 |
| DM8 | 2026-10-26 | Фейдери — одноканальні лінійні B10K **35 мм, хід 20 мм** (клас Bourns PTA2043; модель — Alps RS201111J011, DM39); запасний — 45 мм / 30 мм | попередньо | є на AliExpress і в дистриб'юторів, найкомпактніші з доступних; [02](02-components.md), п. 2 |
| DM9 | 2026-10-26 | Енкодери — звичайні **EC11** без LED-кілець | без кілець — прийнято; модель EC11 **замінено DM26** | LED-кільця важко дістати; тоншого вала серед доступних немає; [02](02-components.md), п. 3 |
| DM10 | 2026-10-26 | У DAW — **4 стерео входи** (8 каналів) | прийнято | відповідь на п. 7.3 ТЗ |
| DM11 | 2026-10-26 | **Живлення 1S** 3000 mAh: TP4056 (0,5 A) + load sharing + buck-boost TPS63802 → 4,2 V + LP5907 3,3 V для аналогу кодеків | попередньо | 1,62 W з акумулятора → 6,2 год; [02](02-components.md), п. 4, [calc/power.py](calc/power.py) |
| DM12 | 2026-10-26 | Teensy 4.1 — на краю основної плати, **поверхневий або врізний** монтаж, слот microSD — у проріз корпусу | прийнято (принцип) | [02](02-components.md), п. 5; варіант монтажу — після креслення PJRC |
| DM13 | 2026-10-26 | ~~Кнопки — Kailh Choc PG1350; LED SK6812MINI-E під Mute~~ | **скасовано DM16, DM18** | ваше рішення; є в LCSC / JLCPCB (C400229); [креслення](datasheets/kailh-choc-pg1350.pdf) |
| DM14 | 2026-10-26 | Навушники — **TPA6132A2** (DirectPath, без вихідних конденсаторів, 25 mW), −6 dB | попередньо | WQFN — лише при передзбиранні JLCPCB (DM7); [03](03-schematic.md), п. 3 |
| DM15 | 2026-10-26 | Одна плата: **згори керування, знизу джеки, Teensy, електроніка, акумулятор**; ≈ 116 × 107 мм | попередньо | [03](03-schematic.md), п. 4 |
| DM16 | 2026-10-26 | Усі кнопки (Mute ×4, FX I, FX II, AUX, ~~CUE~~, SHIFT) — **тактові TSF-1266** 6 × 6 × 5 мм SMT | прийнято; CUE прибрано DM28 | компактніше за Choc; FX I, FX II, AUX, CUE — на вільних виводах MCP23017, SPI звільнив виводи Teensy; [03](03-schematic.md) |
| DM17 | 2026-10-26 | Живлення — **кнопка з фіксацією DPDT**; одна група перемикає EN TPS63802 | прийнято; корпус і місце — DM27, DM25 | струм лише входу EN — рейтингу 50–100 mA досить; креслення — за обраним продавцем |
| DM18 | 2026-10-26 | Дисплей **GMT147SPI** 1,47″ IPS 172 × 320 (ST7789, SPI) замість OLED; **адресних LED немає** — стан Mute і метри на дисплеї | прийнято | у 2,4 раза більша площа, колір; споживання: з акумулятора 1,48 W → 6,8 год на 3000 mAh ([calc/power.py](calc/power.py)) |
| DM19 | 2026-10-26 | Mute — **під фейдерами** біля переднього краю; ~~PHONES — на передньому торці~~; між рядами органів керування **4 мм** для пальців | прийнято; PHONES — на правому торці (DM25) | плата ≈ 108 × 106 мм; [03](03-schematic.md), п. 4 |
| DM20 | 2026-10-26 | **MIDI OUT, TRS Type A** на задньому краї; MIDI IN не ставимо (вхід — через USB MIDI) | прийнято | синхронізація драм-машин без комп'ютера; 2 резистори, Serial8 Teensy; [03](03-schematic.md), п. 3 |
| DM21 | 2026-10-26 | **Окремого фейдера MAIN немає**: гучність MAIN, AUX і навушників — головним енкодером, значення на дисплеї (як у TX-6) | прийнято | ваш вибір варіанта B; габарит ≈ 108 × 106 мм |
| DM22 | 2026-10-26 | ~~Плата **двошарова**~~ | **замінено DM31** | дешевше і простіше налагоджувати; суцільна земля — заливки на обох шарах |
| DM23 | 2026-10-26 | Дисплей — **на штирях** (гребінка модуля в отвори плати), не шлейфом; **монтажні отвори M2** як у Rev A | прийнято | footprint `LCD_GMT147SPI` — заглушка до виміру зразка |
| DM24 | 2026-10-26 | ~~**Компоновка A**~~ (**замінено DM25**): 7 джеків — у смузі вздовж заднього краю (над нею згори порожньо), Teensy — уздовж переднього краю під кнопками Mute (microSD у лівий торець), електроніка — під правою колонкою, акумулятор — під каналами на прокладці; поля 6 мм для отворів M2 у кутах; плата ≈ 114 × 128 мм | прийнято | виводи енкодерів і фейдерів проходять крізь плату — під ними не можна ставити джеки й Teensy; [03](03-schematic.md), п. 4 |
| DM25 | 2026-10-27 | (Teensy і крок бокових джеків уточнено DM35) **Компоновка C** ([мех. макет](mech/layout.svg)): колонка каналу — джек IN, 3 енкодери, фейдер, Mute на одній осі; верхній ряд на одній осі — ON (лівий задній кут), дисплей альбомно по центру вхідних колонок, MASTER (правий задній кут); права колонка — AUX, FX I, FX II на рядах енкодерів, SHIFT на ряду Mute. Знизу: USB-C під MASTER у задній торець, MAIN / AUX / MIDI / PHONES на правому торці (крок 14 мм), Teensy у передньому правому куті (microSD у передній торець, 6,5 мм від правого краю), акумулятор під енкодерами, кодеки під фейдерами поруч із Teensy, MCP23017 під Mute; M2 у чотирьох кутах; **104,5 × 136,5 мм** | прийнято | ваш вибір після прев'ю; кодеки поруч із Teensy — короткі тактові лінії |
| DM26 | 2026-10-27 | Енкодери — **EC12SY-H6-17.5F5.0-24C24P-SMD** з кнопкою (усі 13), SMD: крізь плату лише два отвори напрямних | прийнято; отвори напрямних — `ПЕРЕВІРИТИ` на зразку | знайдено вами; знизу під енкодерами вільно (акумулятор, USB-C під MASTER); площадки 18 × 20 мм — крок каналів 19 мм, рядів 20,5 мм; [креслення](datasheets/ec12sy-smd-encoder-drawing.png) |
| DM27 | 2026-10-27 | Кнопка живлення — **з фіксацією 5,8 × 5,8 мм, DPDT, SMD** (6 ніжок, крок 2,0); натиснута (2–3) — EN = VSYS, відпущена (1–2) — EN = GND | прийнято; посадкове місце — `ОРІЄНТИР` (продавець не дає) | ваш вибір; DC 30 V 0,1 A досить для EN; [креслення](datasheets/push-latching-dpdt-5.8mm-smd-drawing.png) |
| DM28 | 2026-10-27 | **Кнопки:** AUX, FX I, FX II, SHIFT; **CUE прибрано** — Cue = SHIFT + Mute (фіксується), у навушниках CUE, якщо хоч один канал у Cue, інакше MAIN; SHIFT + MASTER — гучність навушників; моно / стерео й темп — у меню; фільтр і компресор ділять енкодер (натискання), тож кнопки 12 енкодерів каналів — на **третьому MCP23017** (0x22, INT → Teensy 22); він найближчий до правої колонки, на ньому ж AUX, FX I, FX II | прийнято | ваш вибір; [01](01-spec.md), п. 4 |
| DM29 | 2026-10-27 | **Послідовні резистори 33 Ω** на BCK / LRCK обох портів і MCLK — біля виводів Teensy | прийнято | узгодження джерела на лініях тактів, менше дзвону й завад |
| DM30 | 2026-10-27 | USB-C — **GCT USB4110-GF-A**, повністю SMD (16 контактів + 4 лапки, 2 отвори напрямних, корпус 8,94 × 7,35 × 3,26) замість вивідного USB4085 | прийнято; наявність у LCSC — `ПЕРЕВІРИТИ` | виводи USB4085 виходили б нагору під корпус MASTER; [креслення GCT](https://gct.co/files/drawings/usb4110.pdf) |
| DM31 | 2026-10-27 | Плата **чотиришарова**, як Rev A: F.Cu сигнали / In1 суцільна GND / In2 сигнали й живлення / B.Cu сигнали; доріжки 0,2 мм (живлення 0,5); USB D+ / D− — пара 0,2 / 0,2 мм над In1 | прийнято | у компоновці C на двох шарах зона ЦАП / TPA6132A2 біля Teensy не розводилась разом із парою USB (2–5 розривів після кожного прогону); суцільна земля під аудіо й USB High Speed; імпеданс пари ≈ 90 Ω — `ОЦІНКА`, звірити з калькулятором стеку JLC |
| DM32 | 2026-10-28 | **Прошивка — переносне ядро C++17** (`firmware/src/core`: мікс, ефекти, інтерфейс, дисплей, сцени, MIDI, рекордер, тюнер) + тонкий шар Teensy 4.1 (`src/teensy`) + **емулятор на SDL2** (`sim/`) з тим самим кодом; перевірки ядра — `make test` | прийнято | прошивку пишемо й налагоджуємо до плати, без заліза; [06](06-firmware.md), п. 1–2 |
| DM33 | 2026-10-28 | Типова збірка — **стандартне ядро Teensy: 44,1 kHz, USB-аудіо стерео** (у DAW — MAIN або один вхід) + MIDI + Serial. 8 каналів і 48 kHz за ТЗ (п. 3.4) — окрема збірка `uac2` з ядром UAC2 [grrrr/teensy-4-usbAudio](https://github.com/grrrr/teensy-4-usbAudio) (MIT, форк alex6679) | попередньо; `uac2` перевірено на голому Teensy 4.1 з macOS: UAC2 8 × 8, 48 kHz, 8 каналів у DAW без розривів (28.10.2026); Windows, iOS — `ПЕРЕВІРИТИ` | стандартна збірка працює без змін у тулчейні; ядро UAC2 замінює файли ядра Teensy — перевірити в Windows, macOS, iOS; [06](06-firmware.md), п. 7 |
| DM34 | 2026-10-28 | **Карта MIDI CC:** канали мікшера 1–4 = MIDI-канали база…база+3, майстер = база+4; CC 7 / 8 / 9 / 74 / 85–87 / 93 — як у TX-6, решта (ширина, посили, Mute, Cue, майстер, FX) — наші; PC 0–7 = сцени; режим CONTROLLER шле CC замість зміни міксу | прийнято | [06](06-firmware.md), п. 5; номери TX-6 — [00](00-research.md), п. 9 |
| DM35 | 2026-10-28 | **Teensy 4.1 — на гребінках 2,54 у наскрізні отвори** основної плати (footprint `Teensy41_THT`), зазор 2,5 мм (планка гребінки) — під **PSRAM** на звороті модуля (1 або 2 чипи по 8 МБ, PJRC). USB device **D− / D+ — наскрізні отвори нашої плати** під площадками модуля (креслення PJRC: 1,78 мм від торця USB, ±1,27 від осі); площадки модуля — під його micro-USB, тож з'єднання — тонкі дроти, пропаяні зверху нашої плати (перевірка 28.10.2026), VUSB — дротик до площадки 49. Щоб отвори D− / D+ не потрапили під кнопку FX II, **Teensy відсунуто на 6 мм від переднього краю** (microSD — за прорізом у стінці); **бокові джеки — з кроком 12,5 мм** замість 14; лапки EC12SY укорочено до 6,0…7,95 мм від осі (язичок — до 7,75). Органи керування згори не рухались — затверджена компоновка | прийнято; положення VUSB і доступ до microSD — `ПЕРЕВІРИТИ` на модулі | ваш вибір: PSRAM для рекордера на 8 доріжок і довгих затримок ([06](06-firmware.md), п. 4, 7); лежачий модуль не лишав місця під чип; розширення плати праворуч дало б те саме лише при +15 мм ширини |
| DM36 | 2026-10-28 | **Ліцензія `digital-mixer/` — GPL-3.0-or-later** (схема, плата, бібліотеки, документація, прошивка); Rev A і `common/` лишаються на CERN-OHL-S-2.0+ | прийнято | ваш вибір; цифрова версія не містить файлів mixerli (джек SJ-43514 перейшов з Rev A, але Rev A згенерував його сам за кресленням CUI; фейдерів Alps з координатами mixerli тут немає) — тож вона не похідна; файли mixerli сюди не копіюємо (CLAUDE.md) |
| DM37 | 2026-10-28 | **Шина +3V3A: 2,2 µF біля LP5907 + 1 µF біля кожного кодека** (замість 6 × 10 µF) | прийнято | datasheet LP5907 (SNVS798Q, 5.6): вихідна ємність 0,7…10 µF; було ≈ 61 µF; [07](07-review.md), п. 1 |
| DM38 | 2026-10-28 | **Джеки 3,5 мм — PJ-327A SMT** (5 виводів, стерео з перемикачем кінчика) замість CUI SJ-43514-SMT, усі 8. Footprint `Jack_3.5mm_PJ-327A_SMT_Horizontal` — **за кресленням продавця** ([креслення](datasheets/pj-327a-seller-drawing.jpg)): площадки 2 × 3, ряди 6,8 між центрами; від переднього торця 1 — 1,7, 3 — 5,4, 5 — 11,4 з одного боку, 2 — 2,7, 4 — 9,7 з другого; контакти за його схемою: 4 кінчик, 3 кільце, 1 і 2 гільза → GND, 5 (перемикач кінчика) вільний. STEP продавця має лапки на тих самих центрах; у HOOYA / XKB / SOFNG — до 0,4 мм інакше, тож деталі інших виробників **не підходять без звірки**. Передній торець корпусу — по краю плати, носик 2 мм назовні. Замінено на розведеній платі латками, без повного перетрасування | прийнято; діаметр отворів під напрямні на кресленні продавця нерозбірливий — 1,3 мм за HOOYA (штирі 0,75); **контакти — `ПЕРЕВІРИТИ` мультиметром на зразку** | ваш вибір: ≈ 8 грн за штуку з безкоштовною доставкою проти ≈ 28 грн + доставка (≈ 62 грн з доставкою на 1 плату) за SJ-43514 (кошик [05](05-fab.md), п. 1.1); на платі всі джеки працюють як TRS ([03](03-schematic.md)) — 5-контактний стерео це закриває |
| DM39 | 2026-10-29 | **Фейдери — Alps RS201111J011** (Super Slide, 35 × 8 мм, хід 20 мм, 10 kΩ лінійний, 3 виводи 0,4 × 1 мм) замість Bourns PTA2043. Footprint `Potentiometer_Alps_RS20111_Single_Slide` — **за кресленням № 1 каталогу Alps** ([alps-rs-super-slide.pdf](datasheets/alps-rs-super-slide.pdf), с. 387; те саме креслення в продавця): отвори 3 × Ø1,5, 1 і 3 за 25 мм, 2 — за 3,75 мм від 1 (площадки 2,2); корпус по осьових лініях креслення. Центр ходу — там само, де в PTA2043, розстановку органів керування не зсунуто. Лапок кріплення немає — лише 2 × M2 у верхній грані під панель. Замінено на розведеній платі латками | прийнято; важіль 15 мм — за фото продавця (`ОРІЄНТИР`) | ваш вибір: лот з кресленням (AliExpress), у дешевих 35-мм фейдерів розкладка виводів невідома; три виводи замість семи звільнили місце під фейдерами |
