heartpolik/hardware-pocket-mixer/digital-mixer/docs/datasheets/ec12sy-smd-encoder-drawing.png

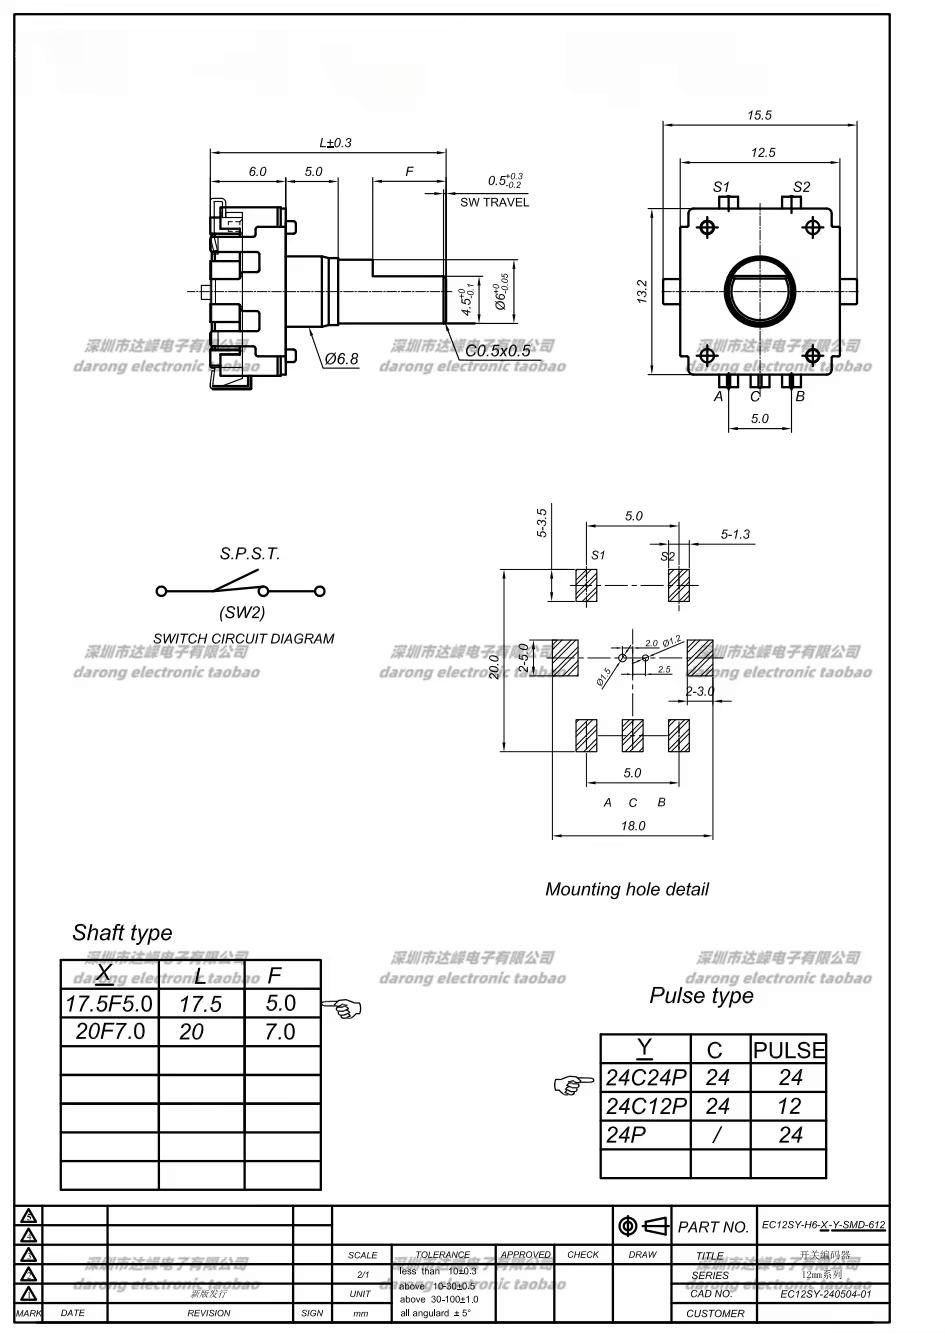
digital-mixer/docs/datasheets/ec12sy-smd-encoder-drawing.png
