heartpolik/hardware-pocket-mixer/digital-mixer/docs/datasheets/fader-rs20111-seller-holes.png

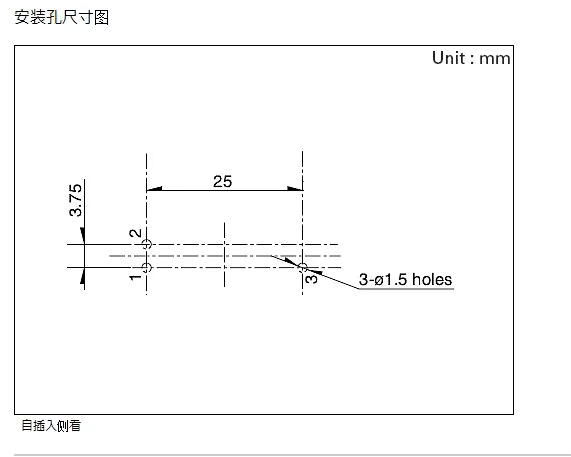
digital-mixer/docs/datasheets/fader-rs20111-seller-holes.png
