heartpolik/hardware-pocket-mixer/digital-mixer/docs/datasheets/fader-rs20111-seller-pins.png

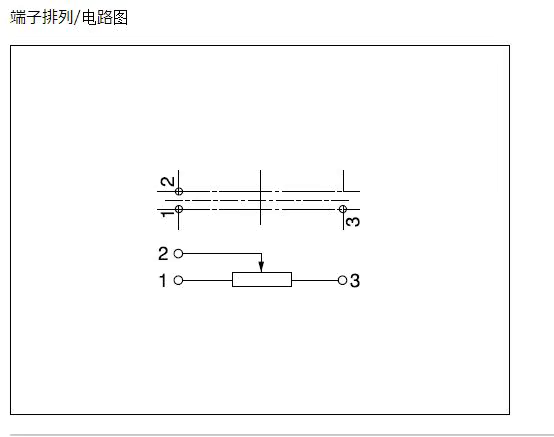
digital-mixer/docs/datasheets/fader-rs20111-seller-pins.png
