heartpolik/hardware-pocket-mixer/digital-mixer/docs/datasheets/gmt147-01m-drawing.webp

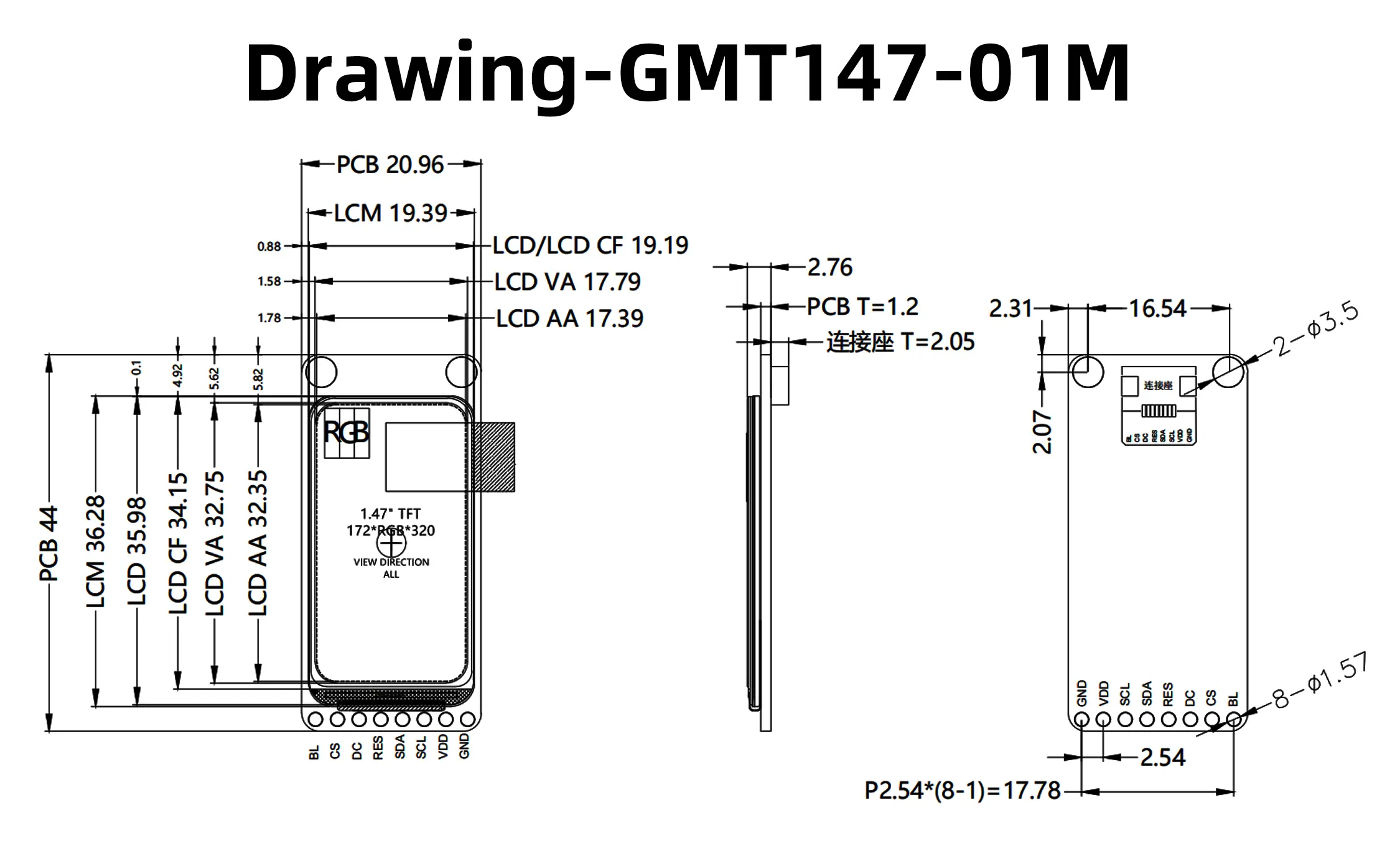
digital-mixer/docs/datasheets/gmt147-01m-drawing.webp
