heartpolik/hardware-pocket-mixer/digital-mixer/docs/datasheets/pj-327a-seller-drawing.jpg

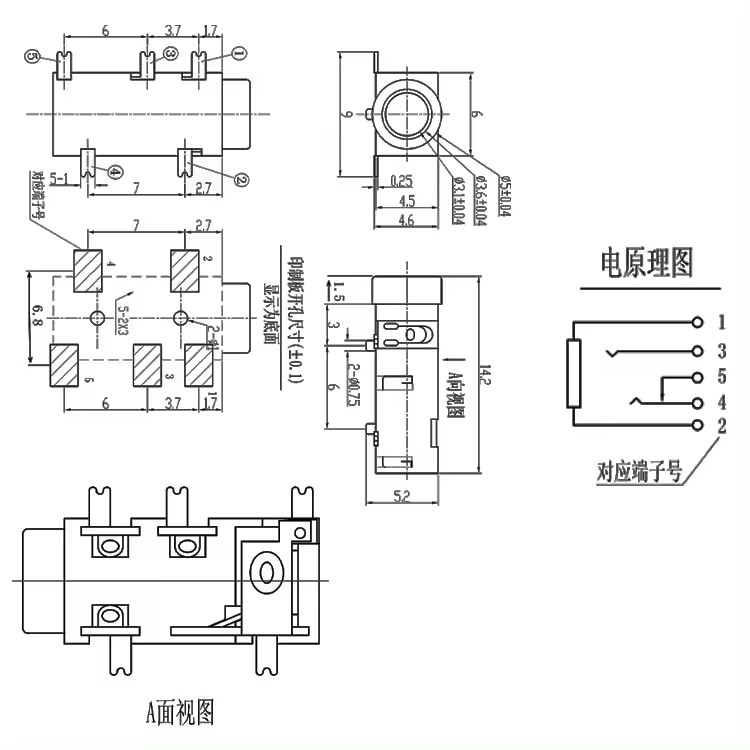
digital-mixer/docs/datasheets/pj-327a-seller-drawing.jpg
