heartpolik/hardware-pocket-mixer/digital-mixer/docs/datasheets/push-latching-dpdt-5.8-7mm-drawing.png

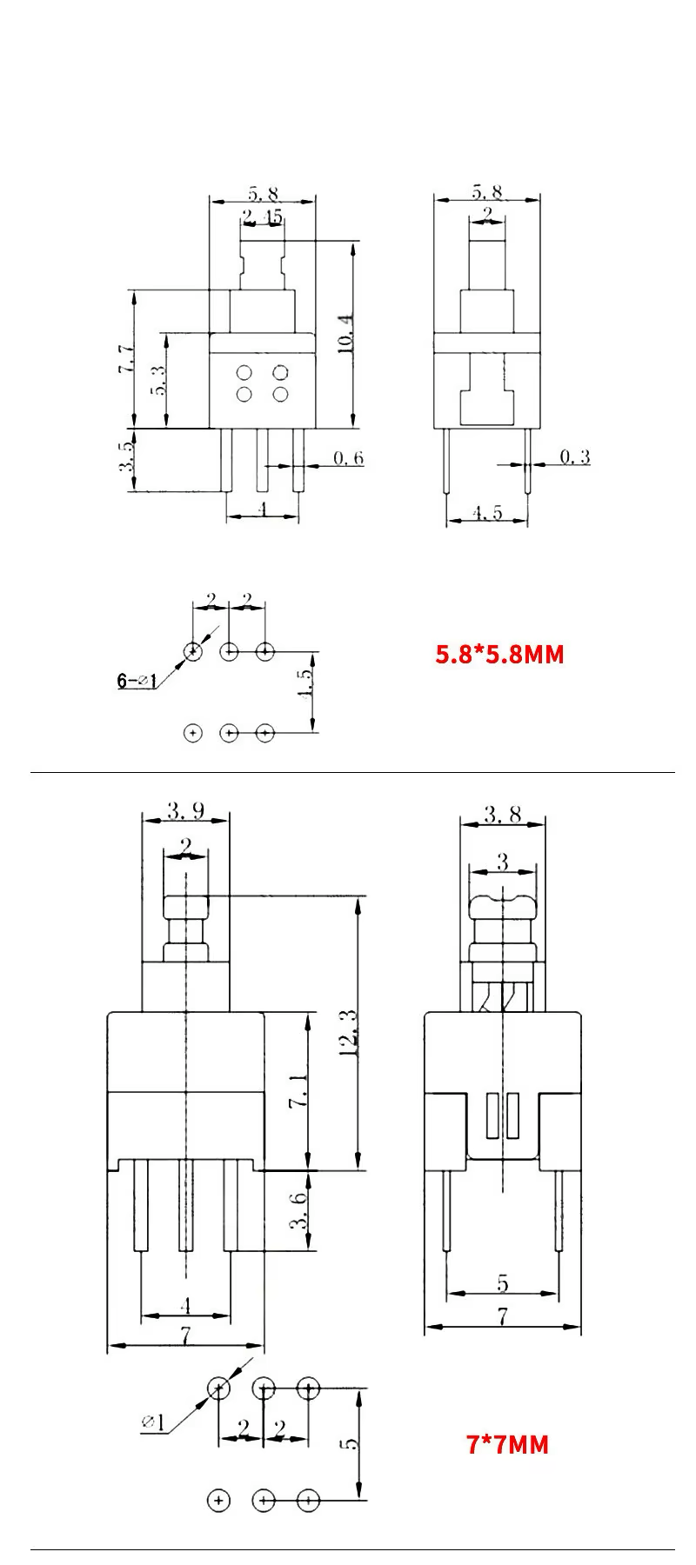
digital-mixer/docs/datasheets/push-latching-dpdt-5.8-7mm-drawing.png
