heartpolik/hardware-pocket-mixer/digital-mixer/docs/datasheets/push-latching-dpdt-5.8mm-smd-drawing.png

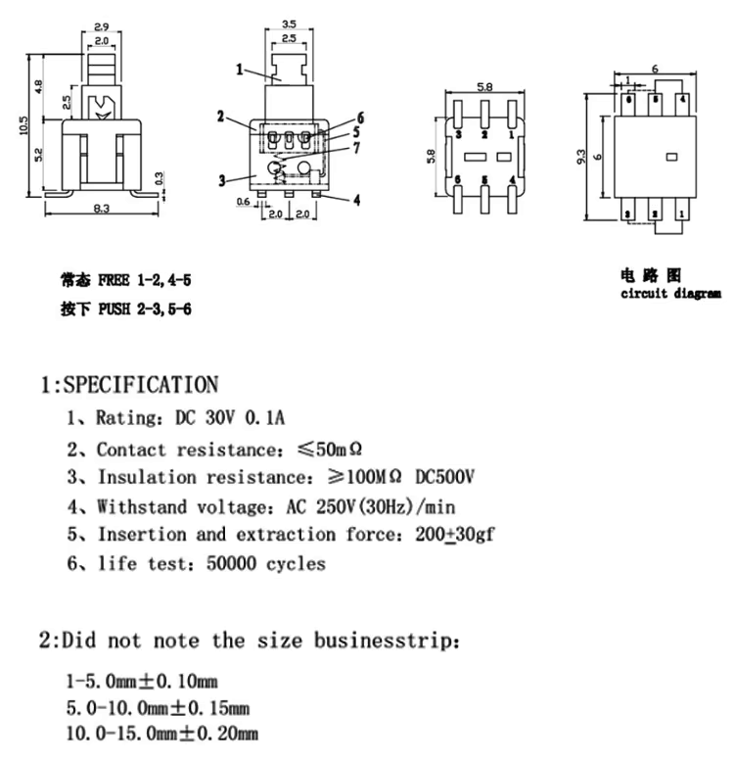
digital-mixer/docs/datasheets/push-latching-dpdt-5.8mm-smd-drawing.png
