heartpolik/hardware-pocket-mixer/digital-mixer/docs/datasheets/push-latching-dpdt-7mm-pins.png

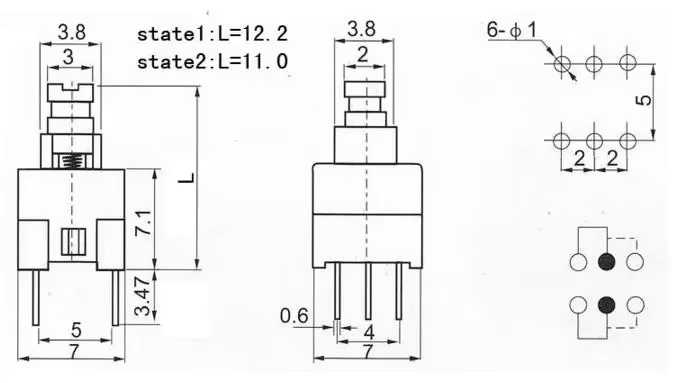
digital-mixer/docs/datasheets/push-latching-dpdt-7mm-pins.png
