heartpolik/hardware-pocket-mixer/digital-mixer/docs/datasheets/tsf-1266-drawing.png

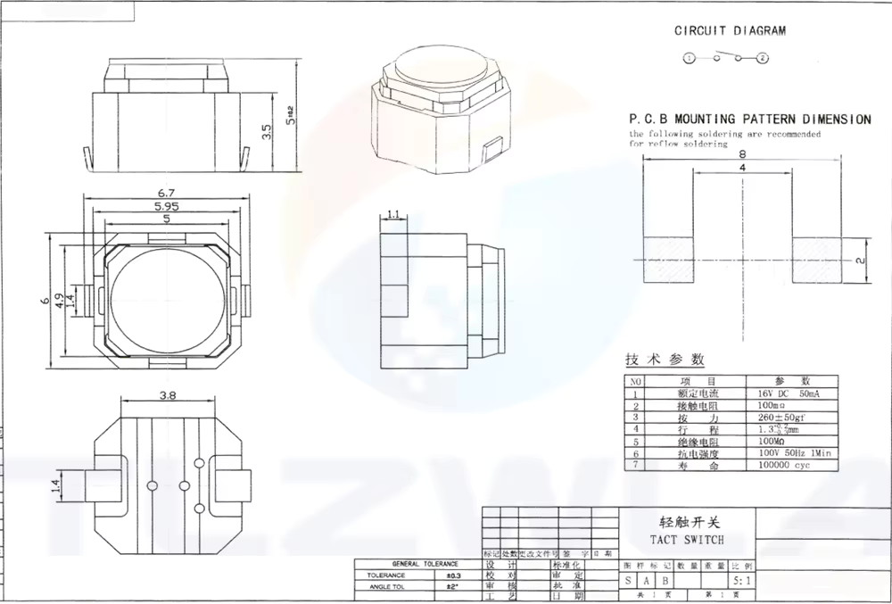
digital-mixer/docs/datasheets/tsf-1266-drawing.png
