heartpolik/hardware-pocket-mixer/analog-mixer/docs/12-parts.md

# C. Вибір решти компонентів

> [!NOTE]
> **Статус:** 24.10.2026. Позначки: ✅ — звірено з datasheet у [datasheets/](datasheets/README.md);
> `НЕ ПЕРЕВІРЕНО` — лише за даними дистриб'юторів або каталогу; `ВІДКРИТО` — модель не обрана.

## 1. Зведення

| Вузол | Компонент | Ключові дані | Статус |
|---|---|---|---|
| Дросель 5 V (TPS62933O) | **Bourns SRN4018-4R7M** | 4,7 µH ±20 %, DCR 84 mΩ макс., Isat 2,0 A, Irms 1,9 A, 4 × 4 × 1,8 мм, напівекранований | ✅ [datasheet](datasheets/bourns-srn4018.pdf) |
| Фільтр шин ±12 V | **RC: 2,2 Ω 0805 + 22 µF X7R 25 V 1206** (замість фериту) | див. п. 2 | ✅ розрахунок |
| Перетворювач рівня LED | **TI SN74AHCT1G125** (SOT-23-5, DBV) | VCC 4,5–5,5 V, **VIH 2,0 V** — 3,3 V від ESP приймає | ✅ [datasheet](datasheets/sn74ahct1g125.pdf) |
| Моно/стерео (D42, D43, **D55**) | **CTS 204-121ST** × 5 — SPDT DIP, **1 позиція на канал**, SMD (було 204-125ST на 5) | довжина 7,26 мм (204-125ST: 27,58), ширина корпусу 9,78 мм; висота над платою **9,12 ± 0,35 мм**; крок виводів 2,54, на перемикач 5,08 мм; pad 1,13 × 2,44 мм, ряди 8,60 / 11,04 мм | ✅ [datasheet CTS rev. D](datasheets/cts-204.pdf), рис. 2 і 4 |
| Енкодер | **Alps EC12D15x440x** як референс (EC12D з кнопкою, кресл. 5): 30 фіксацій, 15 імпульсів, вал 17,5 мм над платою, без втулки; ваш лот EC11 thin — ймовірно аналог | 5 отворів Ø1,05 + 2 лапки; хід кнопки 0,5 мм; кнопка 3 або 6 N | ✅ [datasheet Alps](datasheets/alps-ec12d.pdf) — звірити з отриманим лотом |
| OLED | **0,96" 128 × 64 SSD1306, I²C, 4 виводи, синій** | плата 27,3 × 27,3 мм, активна зона 21,74 × 10,86; виводи **1 VCC, 2 GND, 3 SCL, 4 SDA** (крок 2,54); 4 отвори Ø2,5 через 20,7 × 23,2 мм; VCC 2,8–5,2 V, **12 / 20 mA** при 3,3 V | ✅ [datasheet Rajguru](datasheets/oled-0.96-128x64-4pin.pdf) — звірити з куплeним модулем |
| Діоди ±12 V | **MBR0530** (SOD-123) | 30 V — потрібно для LT1931 ([11](11-power.md)) | за datasheet LT1931 |
| Діод живлення SuperMini (D59) | **MBR0530** (SOD-123), той самий | +5V → вивід 5V модуля: USB модуля не живить нашу +5V | ~0,3 V падіння при ~100 mA — LDO модуля в нормі (`ОЦІНКА`) |

## 2. Чому не дроселі на платі й не ферит

**Дросель доріжками друкованої плати.** Оцінка для квадратної спіралі
(модифікована формула Wheeler, мідь 35 µm, доріжка й зазор 0,2 мм):

| Спіраль | L | Опір |
|---|---|---|
| 15 × 15 мм, 10 витків | ≈ 1,6 µH | ≈ 1,1 Ω |
| 20 × 20 мм, 15 витків | ≈ 4,3 µH | ≈ 2,1 Ω |

Потрібно: 4,7 µH для TPS62933O, 10 µH для LT1930 і **спарені** 2 × 10 µH для LT1931.
Спіраль на 4,7 µH займає 4 см² плати, має опір у 25 разів більший за SRN4018 (втрати й нагрів)
і, не маючи осердя, випромінює поле просто біля аудіотракту. **Висновок: для перетворювачів не
годиться.** Дроселі лишаються дискретними.

**Ферит → RC-фільтр.** Феритові намистини розраховані на сотні мегагерц, а на 1,2 MHz їхній
опір малий. RC-фільтр на шині ±12 V при вході в аудіозону:

| R / C | Зріз | Придушення на 1,2 MHz | Падіння при 96 mA |
|---|---|---|---|
| **2,2 Ω / 22 µF** | 3,3 kHz | ≈ −51 dB | 0,21 V |
| 4,7 Ω / 22 µF | 1,5 kHz | ≈ −58 dB | 0,45 V |

Беремо 2,2 Ω. Кераміка X7R 22 µF під 12 V втрачає частину ємності, тож реальне придушення буде
меншим (`ОЦІНКА`: ~−40 dB). Цього досить: далі ще 100 nF біля кожного корпусу.

## 3. DIP-перемикач і дно корпусу

За кресленням CTS висота 204-12xST над платою **9,12 ± 0,35 мм** (з важільцем 0,89 мм над корпусом),
а під аналоговою платою до внутрішньої поверхні дна вільно ≈ 9 мм ([05](05-mechanics.md)).
Отже, важільці стоять врівень із внутрішньою поверхнею дна, у вікні, і на ~2 мм нижче зовнішньої
(дно 2 мм). Перемикати — нігтем або олівцем, випадково не зачепити. Хід важільця 2,03 мм.

Розпиновка SPDT (який із чотирьох pad перемикача — спільний) у тексті datasheet не підписана —
звірити зі схемою на рис. 2 при створенні footprint у KiCad.
Вікно — у зоні без батареї, біля задніх джеків (D43).

## 4. OLED на цифровій платі

Модуль ставиться на свою 4-контактну гребінку (виводи 6 мм, пластик ~2,5 мм) над цифровою платою:
пластик 2,5 + плата модуля ~1 + скло ~1,4 мм ≈ **4,9 мм** над цифровою платою. Це збігається з
закладеними в ескіз 5 мм (OLED_STACK). Отвори Ø2,5 — для стійок або гвинтів до панелі.

Споживання 12–20 mA при 3,3 V йде з LDO SuperMini — врахувати разом з ESP32 (~30 mA) і CH340N.

## 5. Енкодер — Alps EC12D як референс

За [каталогом Alps EC12E/EC12D](datasheets/alps-ec12d.pdf), с. 288–289, кресл. 5 («With push-on switch type»):

| Параметр | Значення |
|---|---|
| Моделі | EC12D1524403 / 1564402 (кнопка 3 N), EC12D1524406 / 1564404 (кнопка 6 N); відрізняються моментом фіксації (5 ± 3 або 10 ± 5 mN·m) |
| Фіксації / імпульси | **30 / 15** на оберт, «Vertical» — одна фіксація = пів періоду A/B, прошивка рахує обидва фронти |
| Вал | Ø5,975 з лиской 4,475, **LM1 = 17,5 мм** від монтажної площини; **втулки й гайки немає** |
| Корпус | 14,1 × 12,5 мм (з лапками) |
| Кнопка | хід 0,5 мм |
| Виводи | 5 отворів Ø1,05: A і B (виходи енкодера), C (спільний), D і E (кнопка) — розташування за кресленням; 2 лапки кріплення (крок 13,3 мм, пази 2,05) |
| Сигнали | EC12D: деренчання ≤ 3 ms, відскок ≤ 2 ms (перевірено на 5k) |

**На цифровій платі** (верх на 12,6 мм над аналоговою) кінець вала на ≈ 30,1 мм, тобто ~10,5 мм над
верхньою панеллю (19,6) — під друковану ручку достатньо.

**Наслідки відсутності втулки:** вал проходить крізь отвір у панелі без гайки, тож усе натискання на
кнопку (3–6 N) і поворот тримає цифрова плата. Біля енкодера потрібна стійка між платами або упор у
панель — врахувати в кроці E.

**Ваш лот («EC11 thin, 30 positions, 15 pulse, 15 mm half-axis, 5 feet»)** за параметрами схожий на
EC12D, але вал 15 мм проти 17,5 мм, і виробник невідомий. Footprint робимо за кресленням Alps, а
отриманий енкодер **порівнюємо з ним** (відстані між виводами, лапки, висота вала) до замовлення плат.

## 6. Вимикач живлення — MSK12C02 + AO3401A (D51)

| | MSK12C02 (обрано) | BSI-10H → SSI-10H | NSI-10HS | Alps SSSS916400 (mixerli) |
|---|---|---|---|---|
| Монтаж | **SMD**, повзунок убік | THT, повзунок убік (виводи 3,7 мм під кутом) | SMD, **повзунок угору** | THT, вертикальний |
| Номінал | 12 V, 50 mA | 12 V, 0,5 A | 12 V, 0,5 A | 12 V, 0,1 A |
| Габарит | 8 × 2,8 × 1,4 мм, повзунок 1,45 мм, хід 1,6 | 10 × 6,4 × 2,5 мм | 10 × 8,3 × 2,5 мм | — |
| Джерело | [креслення](datasheets/shouhan-msk12c02.pdf) | [datasheet](datasheets/sungmun-ssi-10.pdf) | [каталог](datasheets/sungmun-ssi-nsi-10-catalog.pdf) | [Alps](datasheets/SSSS9-1370708.pdf) |

Серію BSI Sungmun перейменував на SSI. Жоден з перемикачів не витримує ~0,56 A з батареї, тому
перемикач керує P-MOSFET ([11](11-power.md), п. 1.1). Тоді годиться найменший SMD.

**Посадка на торці.** Повзунок виступає з корпусу перемикача на 1,45 мм. Корпус стоїть на 0,25 мм
від краю плати (зазор мідь–край 0,2 мм для лапок), тож за край виходить 1,2 мм. Стінка корпусу в
цьому місці має бути тонкою, або в ній потрібне заглиблення під ніготь чи друкована накладка на
повзунок. Це вирішується разом з корпусом.

**Наявність.** LCSC C431540 і варіанти -SZ, -HB, а також аналог HX MSK12C02-BB; на AliExpress
продається як «MSK-12C02». В українських магазинах `НЕ ПЕРЕВІРЕНО`. AO3401A поширений.
