heartpolik/hardware-pocket-mixer/analog-mixer/hw/mech/diy-mixer-assembly.step

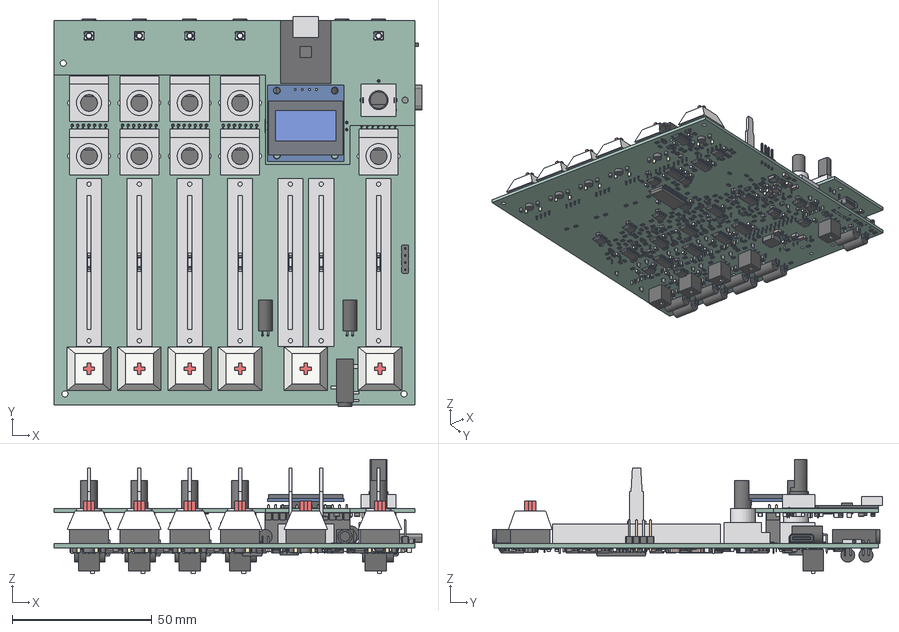
[picture p22: CAD file, 2026-10-26]
analog-mixer/hw/mech/diy-mixer-assembly.step
131.5 x 139.4 x 40.9 mm
p0 x 56
p1 x 56
p2 x 31
p3 x 17
p4 x 17
PinSocket_2x12_P2.54mm_Vertical
PinHeader_1x04_P254mm_Vertical
USB_C_Receptacle_GCT_USB4085
R_0805_2012Metric x 208
C_0805_2012Metric x 92
SOIC-16_3.9x9.9mm_P1.27mm x 6
SOIC-8_3.9x4.9mm_P1.27mm x 13
SOIC-14_3.9x8.7mm_P1.27mm x 6
D_SOD-123 x 27
C_1206_3216Metric x 12
SOT-23-5 x 3
L_Bourns-SRN4018 x 2
SOT-23
SOT-23-6
SOIC-28W_7.5x17.9mm_P1.27mm
SOT-583-8
analog_routed_PCB
TSSOP-16_4.4x5mm_P0.65mm
Pin1 x 5
Pin2 x 5
Pin3 x 5
Pin4 x 5
PinHeader_2x12_P254mm_Vertical
digital_routed_PCB
