heartpolik/hardware-pocket-mixer/digital-mixer/hw/fab/nextpcb-full/assembly-bottom.pdf

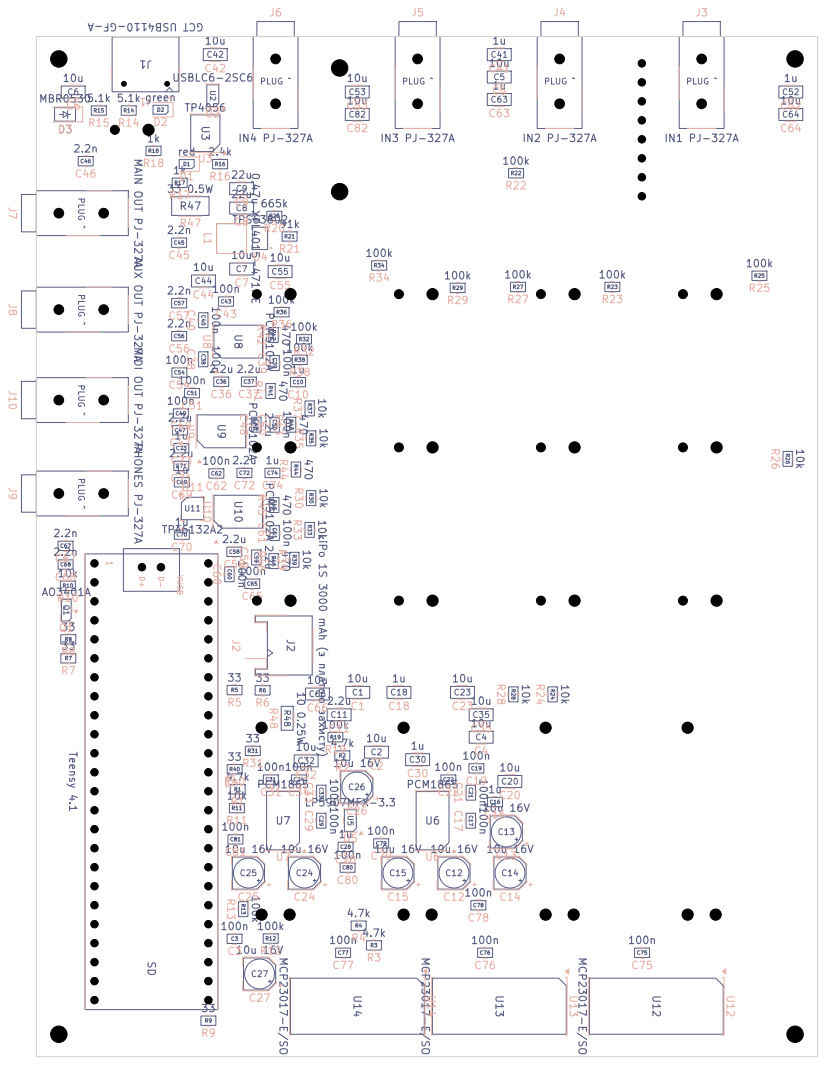
[picture p23: page 1]

C81 MIDI OUT PJ-327A PLUG ^

Size: A4 | Rev:
KiCad E.D.A. 10.0.7 | Id: 1/1
