heartpolik/hardware-pocket-mixer/digital-mixer/hw/fab/nextpcb-full/assembly-top.pdf

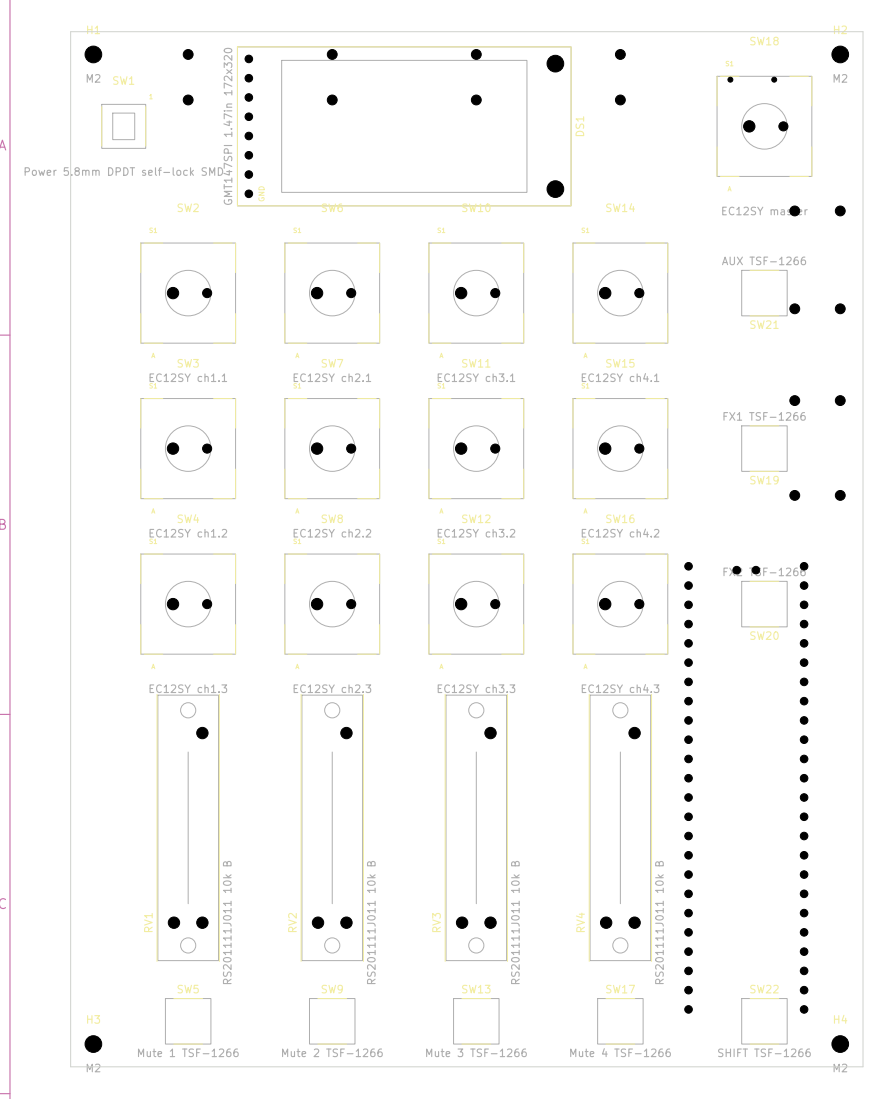
[picture p24: page 1]

Power 5.8mm DPDT self-lock SMD Mute 1 TSF-1266

EC12SY master FX2 TSF-1266 Mute 2 TSF-1266

Size: A4 | Rev:
KiCad E.D.A. 10.0.7 | Id: 1/1
