heartpolik/hardware-pocket-mixer/digital-mixer/hw/fab/nextpcb-eco/assembly-bottom.pdf

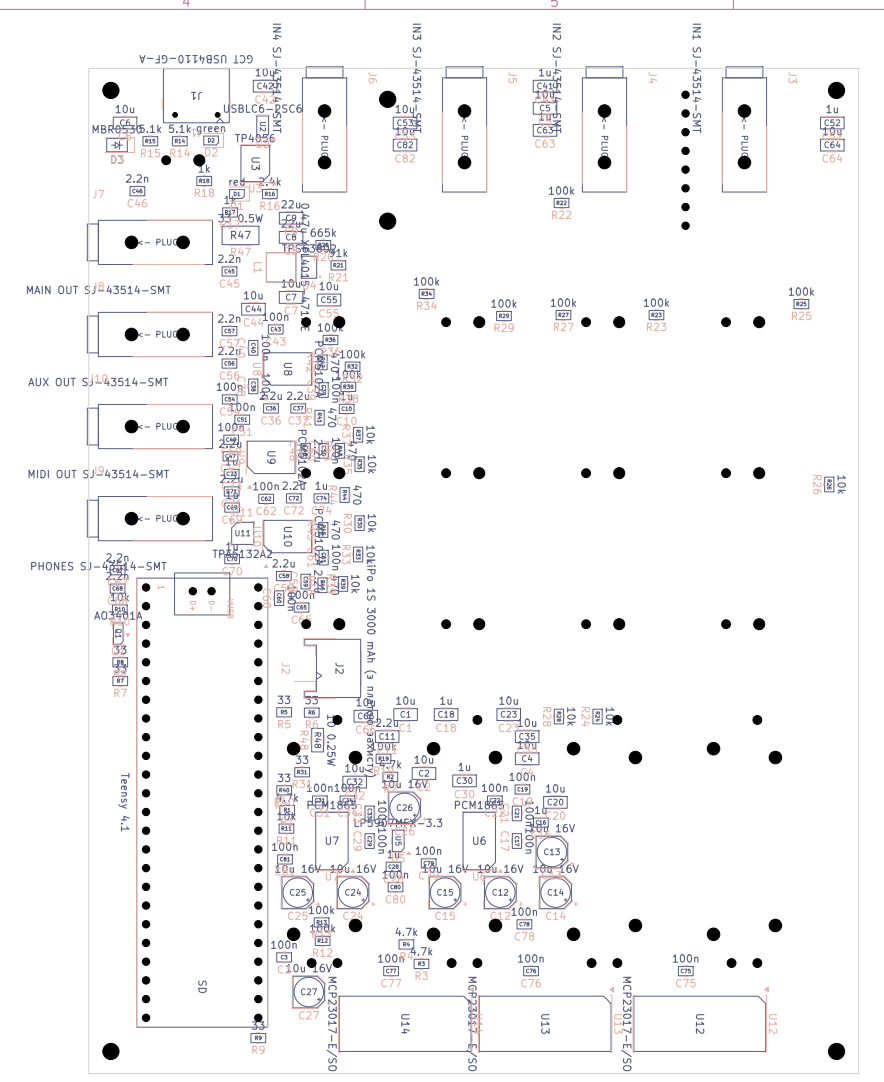
[picture p26: page 1]

Size: A4 | Rev:
KiCad E.D.A. 10.0.7 | Id: 1/1
