heartpolik/hardware-pocket-mixer/digital-mixer/hw/main/main.kicad_pcb

## KiCad design digital-mixer/hw/main/main.kicad_pcb (2026-10-29)

Schematic: main.kicad_sch, hardware-pocket-mixer digital — main board

Parts:
C1, C2, C4, C5, C6, C7, C20, C23, C32, C35, C42, C44, C53, C55, C64, C66, C82: 10u; C_1206_3216Metric
C3, C17, C19, C21, C22, C29, C31, C33, C34, C38, C39, C40, C43, C49, C50, C51, C54, C60, C61, C62, C65, C75, C76, C77, C78, C79, C80, C81: 100n; C_0805_2012Metric
C8, C9: 22u; C_1206_3216Metric
C10, C16, C28, C69, C70, C73, C74: 1u; C_0805_2012Metric
C11: 2.2u; C_1206_3216Metric
C12, C13, C14, C15, C24, C25, C26, C27: 10u 16V; CP_Elec_4x5.4
C18, C30, C41, C52, C63: 1u; C_1206_3216Metric
C36, C37, C47, C48, C58, C59, C71, C72: 2.2u; C_0805_2012Metric
C45, C46, C56, C57, C67, C68: 2.2n; C_0805_2012Metric
D1: red; LED_0805_2012Metric
D2: green; LED_0805_2012Metric
D3: MBR0530; D_SOD-123
DS1: GMT147SPI 1.47in 172x320; LCD_GMT147SPI
J1: GCT USB4110-GF-A; USB_C_Receptacle_GCT_USB4110
J2: LiPo 1S 3000 mAh (з платою захисту); JST_PH_S2B-PH-SM4-TB_1x02-1MP_P2.00mm_Horizontal
J3: IN1 PJ-327A; Jack_3.5mm_PJ-327A_SMT_Horizontal
J4: IN2 PJ-327A; Jack_3.5mm_PJ-327A_SMT_Horizontal
J5: IN3 PJ-327A; Jack_3.5mm_PJ-327A_SMT_Horizontal
J6: IN4 PJ-327A; Jack_3.5mm_PJ-327A_SMT_Horizontal
J7: MAIN OUT PJ-327A; Jack_3.5mm_PJ-327A_SMT_Horizontal
J8: AUX OUT PJ-327A; Jack_3.5mm_PJ-327A_SMT_Horizontal
J9: PHONES PJ-327A; Jack_3.5mm_PJ-327A_SMT_Horizontal
J10: MIDI OUT PJ-327A; Jack_3.5mm_PJ-327A_SMT_Horizontal
L1: 0.47u XFL4015-471ME; L_Coilcraft_XFL4015
Q1: AO3401A; SOT-23
R1, R2, R3, R4: 4.7k; R_0805_2012Metric
R5, R6, R7, R8, R9, R31, R40: 33; R_0805_2012Metric
R10, R11, R24, R26, R28, R30, R33, R35, R37, R39: 10k; R_0805_2012Metric
R12, R13, R19, R22, R23, R25, R27, R29, R32, R34, R36, R38: 100k; R_0805_2012Metric
R14, R15: 5.1k; R_0805_2012Metric
R16: 2.4k; R_0805_2012Metric
R17, R18: 1k; R_0805_2012Metric
R20: 665k; R_0805_2012Metric
R21: 91k; R_0805_2012Metric
R41, R42, R43, R44, R45, R46: 470; R_0805_2012Metric
R47: 33 0.5W; R_2010_5025Metric
R48: 10 0.25W; R_1206_3216Metric
RV1, RV2, RV3, RV4: RS201111J011 10k B; Potentiometer_Alps_RS20111_Single_Slide
SW1: Power 5.8mm DPDT self-lock SMD; SW_Push_Latching_DPDT_5.8mm_SMD
SW2: EC12SY ch1.1; RotaryEncoder_EC12SY_SMD
SW3: EC12SY ch1.2; RotaryEncoder_EC12SY_SMD
SW4: EC12SY ch1.3; RotaryEncoder_EC12SY_SMD
SW5: Mute 1 TSF-1266; SW_TSF-1266_6x6mm_SMD
SW6: EC12SY ch2.1; RotaryEncoder_EC12SY_SMD
SW7: EC12SY ch2.2; RotaryEncoder_EC12SY_SMD
SW8: EC12SY ch2.3; RotaryEncoder_EC12SY_SMD
SW9: Mute 2 TSF-1266; SW_TSF-1266_6x6mm_SMD
SW10: EC12SY ch3.1; RotaryEncoder_EC12SY_SMD
SW11: EC12SY ch3.2; RotaryEncoder_EC12SY_SMD
SW12: EC12SY ch3.3; RotaryEncoder_EC12SY_SMD
SW13: Mute 3 TSF-1266; SW_TSF-1266_6x6mm_SMD
SW14: EC12SY ch4.1; RotaryEncoder_EC12SY_SMD
SW15: EC12SY ch4.2; RotaryEncoder_EC12SY_SMD
SW16: EC12SY ch4.3; RotaryEncoder_EC12SY_SMD
SW17: Mute 4 TSF-1266; SW_TSF-1266_6x6mm_SMD
SW18: EC12SY master; RotaryEncoder_EC12SY_SMD
SW19: FX1 TSF-1266; SW_TSF-1266_6x6mm_SMD
SW20: FX2 TSF-1266; SW_TSF-1266_6x6mm_SMD
SW21: AUX TSF-1266; SW_TSF-1266_6x6mm_SMD
SW22: SHIFT TSF-1266; SW_TSF-1266_6x6mm_SMD
U1: Teensy 4.1; Teensy41_THT
U2: USBLC6-2SC6; SOT-23-6
U3: TP4056; SOIC-8-1EP_3.9x4.9mm_P1.27mm_EP2.41x3.3mm
U4: TPS63802; Texas_VSON-HR-10_2x3mm_P0.5mm
U5: LP5907MFX-3.3; SOT-23-5
U6, U7: PCM1865; TSSOP-30_4.4x7.8mm_P0.5mm
U8, U9, U10: PCM5102A; TSSOP-20_4.4x6.5mm_P0.65mm
U11: TPA6132A2; WQFN-16-1EP_3x3mm_P0.5mm_EP1.6x1.6mm
U12, U13, U14: MCP23017-E/SO; SOIC-28W_7.5x17.9mm_P1.27mm

Connections:
/+3V3: C2.1, C21.1, C22.1, C23.1, C33.1, C34.1, C35.1, C40.1, C42.1, C51.1, C53.1, C62.1, C64.1, C75.1, C76.1, C77.1, C82.1, DS1.2, R1.1, R2.1, R3.1, R4.1, R47.1, RV1.3, RV2.3, RV3.3, RV4.3, U1.15 (3V3), U1.46 (3V3), U1.51 (3V3), U6.13 (DVDD), U6.14 (IOVDD), U7.13 (DVDD), U7.14 (IOVDD), U7.25 (MS/AD), U8.20 (DVDD), U9.20 (DVDD), U10.20 (DVDD), U12.9 (V_{DD}), U12.18 (~RESET), U13.9 (V_{DD}), U13.15 (A0), U13.18 (~RESET), U14.9 (V_{DD}), U14.16 (A1), U14.18 (~RESET)
/+3V3A: C11.1, C17.1, C18.1, C29.1, C30.1, C38.1, C39.1, C41.1, C49.1, C50.1, C52.1, C60.1, C61.1, C63.1, U5.5 (OUT), U6.8 (AVDD), U7.8 (AVDD), U8.1 (CPVDD), U8.8 (AVDD), U9.1 (CPVDD), U9.8 (AVDD), U10.1 (CPVDD), U10.8 (AVDD)
/+4V2: C1.1, C8.1, C9.1, C10.1, C71.1, R20.1, U1.48 (VIN), U4.6 (VOUT), U5.1 (IN), U5.3 (EN), U11.14 (VDD)
/ADC1_DOUT: R31.1, U6.18 (DOUT)
/ADC1_IN1_L: C12.1, U6.3 (VINL1/VIN1P)
/ADC1_IN1_R: C13.1, U6.4 (VINR1/VIN2P)
/ADC1_IN2_L: C14.1, U6.1 (VINL2/VIN1M)
/ADC1_IN2_R: C15.1, U6.2 (VINR2/VIN2M)
/ADC1_LDO: C19.1, C20.1, U6.11 (LDO)
/ADC1_VREF: C16.1, U6.6 (VREF)
/ADC2_DOUT: R40.1, U7.18 (DOUT)
/ADC2_IN3_L: C24.1, U7.3 (VINL1/VIN1P)
/ADC2_IN3_R: C25.1, U7.4 (VINR1/VIN2P)
/ADC2_IN4_L: C26.1, U7.1 (VINL2/VIN1M)
/ADC2_IN4_R: C27.1, U7.2 (VINR2/VIN2M)
/ADC2_LDO: C31.1, C32.1, U7.11 (LDO)
/ADC2_VREF: C28.1, U7.6 (VREF)
/ADC_BCK: R7.2, U6.17 (BCK), U7.17 (BCK)
/ADC_BCK_T: R7.1, U1.6 (4_BCLK2)
/ADC_DOUT: R31.2, R40.2, U1.7 (5_IN2)
/ADC_LRCK: R8.2, U6.16 (LRCK), U7.16 (LRCK)
/ADC_LRCK_T: R8.1, U1.5 (3_LRCLK2)
/ADC_MCLK: R9.2, U6.15 (SCKI), U7.15 (SCKI)
/ADC_MCLK_T: R9.1, U1.25 (33_MCLK2)
/AUX_CAPM: C47.2, U9.4 (CAPM)
/AUX_CAPP: C47.1, U9.2 (CAPP)
/AUX_L: C56.1, J8.4 (T), R43.2
/AUX_LDOO: C54.1, C55.1, U9.18 (LDOO)
/AUX_OL: R43.1, U9.6 (OUTL)
/AUX_OR: R44.1, U9.7 (OUTR)
/AUX_R: C57.1, J8.3 (R), R44.2
/AUX_VNEG: C48.1, U9.5 (VNEG)
/BAT+: C5.1, J2.1, Q1.3 (D), U3.5 (BAT)
/BB_FB: R20.2, R21.1, U4.4 (FB)
/BB_L1: L1.1, U4.9 (L1)
/BB_L2: L1.2, U4.7 (L2)
/BTN_AUX: SW21.1, U14.27 (GPA6)
/BTN_FX1: SW19.1, U14.28 (GPA7)
/BTN_FX2: SW20.1, U14.7 (GPB6)
/BTN_SHIFT: SW22.1, U1.21 (29_TX7)
/CC1: J1.A5 (CC1), R14.1
/CC2: J1.B5 (CC2), R15.1
/CHG_LED_G: D2.1 (K), U3.6 (~STDBY)
/CHG_LED_GA: D2.2 (A), R18.2
/CHG_LED_R: D1.1 (K), U3.7 (~CHRG)
/CHG_LED_RA: D1.2 (A), R17.2
/CHG_PROG: R16.1, U3.2 (PROG)
/CUE_CAPM: C58.2, U10.4 (CAPM)
/CUE_CAPP: C58.1, U10.2 (CAPP)
/CUE_L: C67.1, C69.1, R45.2
/CUE_LDOO: C65.1, C66.1, U10.18 (LDOO)
/CUE_OL: R45.1, U10.6 (OUTL)
/CUE_OR: R46.1, U10.7 (OUTR)
/CUE_R: C68.1, C70.1, R46.2
/CUE_VNEG: C59.1, U10.5 (VNEG)
/DAC_AUX: U1.24 (32_OUT1B), U9.14 (DIN)
/DAC_BCK: R5.2, U8.13 (BCK), U9.13 (BCK), U10.13 (BCK)
/DAC_BCK_T: R5.1, U1.43 (21_A7_RX5_BCLK1)
/DAC_CUE: U1.11 (9_OUT1C), U10.14 (DIN)
/DAC_LRCK: R6.2, U8.15 (LRCK), U9.15 (LRCK), U10.15 (LRCK)
/DAC_LRCK_T: R6.1, U1.42 (20_A6_TX5_LRCLK1)
/DAC_MAIN: U1.9 (7_RX2_OUT1A), U8.14 (DIN)
/DAC_XSMT: R10.1, U1.28 (36_CS), U8.17 (XSMT), U9.17 (XSMT), U10.17 (XSMT)
/ENC1_1_A: SW2.A, U12.21 (GPA0)
/ENC1_1_B: SW2.B, U12.22 (GPA1)
/ENC1_1_SW: SW2.S1, U14.21 (GPA0)
/ENC1_2_A: SW3.A, U12.23 (GPA2)
/ENC1_2_B: SW3.B, U12.24 (GPA3)
/ENC1_2_SW: SW3.S1, U14.22 (GPA1)
/ENC1_3_A: SW4.A, U12.25 (GPA4)
/ENC1_3_B: SW4.B, U12.26 (GPA5)
/ENC1_3_SW: SW4.S1, U14.23 (GPA2)
/ENC2_1_A: SW6.A, U12.1 (GPB0)
/ENC2_1_B: SW6.B, U12.2 (GPB1)
/ENC2_1_SW: SW6.S1, U14.24 (GPA3)
/ENC2_2_A: SW7.A, U12.3 (GPB2)
/ENC2_2_B: SW7.B, U12.4 (GPB3)
/ENC2_2_SW: SW7.S1, U14.25 (GPA4)
/ENC2_3_A: SW8.A, U12.5 (GPB4)
/ENC2_3_B: SW8.B, U12.6 (GPB5)
/ENC2_3_SW: SW8.S1, U14.26 (GPA5)
/ENC3_1_A: SW10.A, U13.21 (GPA0)
/ENC3_1_B: SW10.B, U13.22 (GPA1)
/ENC3_1_SW: SW10.S1, U14.1 (GPB0)
/ENC3_2_A: SW11.A, U13.23 (GPA2)
/ENC3_2_B: SW11.B, U13.24 (GPA3)
/ENC3_2_SW: SW11.S1, U14.2 (GPB1)
/ENC3_3_A: SW12.A, U13.25 (GPA4)
/ENC3_3_B: SW12.B, U13.26 (GPA5)
/ENC3_3_SW: SW12.S1, U14.3 (GPB2)
/ENC4_1_A: SW14.A, U13.1 (GPB0)
/ENC4_1_B: SW14.B, U13.2 (GPB1)
/ENC4_1_SW: SW14.S1, U14.4 (GPB3)
/ENC4_2_A: SW15.A, U13.3 (GPB2)
/ENC4_2_B: SW15.B, U13.4 (GPB3)
/ENC4_2_SW: SW15.S1, U14.5 (GPB4)
/ENC4_3_A: SW16.A, U13.5 (GPB4)
/ENC4_3_B: SW16.B, U13.6 (GPB5)
/ENC4_3_SW: SW16.S1, U14.6 (GPB5)
/ENC_M_A: SW18.A, U1.2 (0_RX1_CRX2_CS1)
/ENC_M_B: SW18.B, U1.3 (1_TX1_CTX2_MISO1)
/ENC_M_SW: SW18.S1, U1.4 (2_OUT2)
/FADER1: C78.1, RV1.2, U1.36 (14_A0_TX3_SPDIF_OUT)
/FADER2: C79.1, RV2.2, U1.37 (15_A1_RX3_SPDIF_IN)
/FADER3: C80.1, RV3.2, U1.38 (16_A2_RX4_SCL1)
/FADER4: C81.1, RV4.2, U1.39 (17_A3_TX4_SDA1)
/GND: C1.2, C2.2, C3.2, C4.2, C5.2, C6.2, C7.2, C8.2, C9.2, C10.2, C11.2, C16.2, C17.2, C18.2, C19.2, C20.2, C21.2, C22.2, C23.2, C28.2, C29.2, C30.2, C31.2, C32.2, C33.2, C34.2, C35.2, C37.2, C38.2, C39.2, C40.2, C41.2, C42.2, C43.2, C44.2, C45.2, C46.2, C48.2, C49.2, C50.2, C51.2, C52.2, C53.2, C54.2, C55.2, C56.2, C57.2, C59.2, C60.2, C61.2, C62.2, C63.2, C64.2, C65.2, C66.2, C67.2, C68.2, C71.2, C72.2, C73.2, C75.2, C76.2, C77.2, C78.2, C79.2, C80.2, C81.2, C82.2, DS1.1, J1.A1 (GND), J1.A12 (GND), J1.B1 (GND), J1.B12 (GND), J1.SH (SHIELD), J2.2, J2.MP (MountPin), J3.1 (S), J3.2 (S2), J4.1 (S), J4.2 (S2), J5.1 (S), J5.2 (S2), J6.1 (S), J6.2 (S2), J7.1 (S), J7.2 (S2), J8.1 (S), J8.2 (S2), J9.1 (S), J9.2 (S2), J10.1 (S), J10.2 (S2), R10.2, R11.2, R13.2, R14.2, R15.2, R16.2, R19.2, R21.2, R22.2, R23.2, R25.2, R27.2, R29.2, R32.2, R34.2, R36.2, R38.2, RV1.1, RV2.1, RV3.1, RV4.1, SW1.1 (A), SW2.C, SW2.MP, SW2.S2, SW3.C, SW3.MP, SW3.S2, SW4.C, SW4.MP, SW4.S2, SW5.2, SW6.C, SW6.MP, SW6.S2, SW7.C, SW7.MP, SW7.S2, SW8.C, SW8.MP, SW8.S2, SW9.2, SW10.C, SW10.MP, SW10.S2, SW11.C, SW11.MP, SW11.S2, SW12.C, SW12.MP, SW12.S2, SW13.2, SW14.C, SW14.MP, SW14.S2, SW15.C, SW15.MP, SW15.S2, SW16.C, SW16.MP, SW16.S2, SW17.2, SW18.C, SW18.MP, SW18.S2, SW19.2, SW20.2, SW21.2, SW22.2, U1.1 (GND), U1.34 (GND), U1.47 (GND), U1.52 (GND), U2.2 (GND), U3.1 (TEMP), U3.3 (GND), U3.9 (EPAD), U4.2 (MODE), U4.3 (AGND), U4.8 (GND), U5.2 (GND), U6.7 (AGND), U6.10 (XI), U6.12 (DGND), U6.25 (MS/AD), U6.26 (MD0), U7.7 (AGND), U7.10 (XI), U7.12 (DGND), U7.26 (MD0), U8.3 (CPGND), U8.9 (AGND), U8.10 (DEMP), U8.11 (FLT), U8.12 (SCK), U8.16 (FMT), U8.19 (DGND), U9.3 (CPGND), U9.9 (AGND), U9.10 (DEMP), U9.11 (FLT), U9.12 (SCK), U9.16 (FMT), U9.19 (DGND), U10.3 (CPGND), U10.9 (AGND), U10.10 (DEMP), U10.11 (FLT), U10.12 (SCK), U10.16 (FMT), U10.19 (DGND), U11.2 (INL+), U11.3 (INR+), U11.6 (G0), U11.7 (G1), U11.10 (PGND), U11.15 (SGND), U11.17 (EP), U12.10 (V_{SS}), U12.15 (A0), U12.16 (A1), U12.17 (A2), U13.10 (V_{SS}), U13.16 (A1), U13.17 (A2), U14.10 (V_{SS}), U14.15 (A0), U14.17 (A2); also elsewhere on the board
/HP_CPN: C74.2, U11.9 (CPN)
/HP_CPP: C74.1, U11.11 (CPP)
/HP_EN: R11.1, U1.29 (37_CS), U11.13 (EN)
/HP_HPVDD: C72.1, U11.12 (HPVDD)
/HP_HPVSS: C73.1, U11.8 (HPVSS)
/HP_INL: C69.2, U11.1 (INL-)
/HP_INR: C70.2, U11.4 (INR-)
/I2C2_SCL: R4.2, U1.16 (24_A10_TX6_SCL2), U12.12 (SCK), U13.12 (SCK), U14.12 (SCK)
/I2C2_SDA: R3.2, U1.17 (25_A11_RX6_SDA2), U12.13 (SDA), U13.13 (SDA), U14.13 (SDA)
/I2C_SCL: R2.2, U1.41 (19_A5_SCL), U6.24 (MC/SCL), U7.24 (MC/SCL)
/I2C_SDA: R1.2, U1.40 (18_A4_SDA), U6.23 (MOSI/SDA), U7.23 (MOSI/SDA)
/IN1_LS: C12.2, R24.2
/IN1_R: J3.3 (R), R25.1, R26.1
/IN1_RS: C13.2, R26.2
/IN1_T: J3.4 (T), R23.1, R24.1
/IN2_LS: C14.2, R28.2
/IN2_R: J4.3 (R), R29.1, R30.1
/IN2_RS: C15.2, R30.2
/IN2_T: J4.4 (T), R27.1, R28.1
/IN3_LS: C24.2, R33.2
/IN3_R: J5.3 (R), R34.1, R35.1
/IN3_RS: C25.2, R35.2
/IN3_T: J5.4 (T), R32.1, R33.1
/IN4_LS: C26.2, R37.2
/IN4_R: J6.3 (R), R38.1, R39.1
/IN4_RS: C27.2, R39.2
/IN4_T: J6.4 (T), R36.1, R37.1
/LCD_BLK: DS1.8, U1.20 (28_RX7)
/LCD_CS: DS1.7, U1.12 (10_CS_MQSR)
/LCD_DC: DS1.6, U1.32 (40_A16)
/LCD_MOSI: DS1.4, U1.13 (11_MOSI_CTX1)
/LCD_RES: DS1.5, U1.33 (41_A17)
/LCD_SCK: DS1.3, U1.35 (13_SCK_LED)
/MAIN_CAPM: C36.2, U8.4 (CAPM)
/MAIN_CAPP: C36.1, U8.2 (CAPP)
/MAIN_L: C45.1, J7.4 (T), R41.2
/MAIN_LDOO: C43.1, C44.1, U8.18 (LDOO)
/MAIN_OL: R41.1, U8.6 (OUTL)
/MAIN_OR: R42.1, U8.7 (OUTR)
/MAIN_R: C46.1, J7.3 (R), R42.2
/MAIN_VNEG: C37.1, U8.5 (VNEG)
/MCP1_INT: U1.22 (30_CRX3), U12.20 (INTA)
/MCP2_INT: U1.23 (31_CTX3), U13.20 (INTA)
/MCP3_INT: U1.44 (22_A8_CTX1), U14.20 (INTA)
/MIDI_SINK: J10.4 (T), R48.2
/MIDI_SRC: J10.3 (R), R47.2
/MIDI_TX: R48.1, U1.27 (35_TX8)
/MUTE1: SW5.1, U12.27 (GPA6)
/MUTE2: SW9.1, U12.7 (GPB6)
/MUTE3: SW13.1, U13.27 (GPA6)
/MUTE4: SW17.1, U13.7 (GPB6)
/PH_L: J9.4 (T), U11.16 (OUTL)
/PH_R: J9.3 (R), U11.5 (OUTR)
/PWR_EN: R22.1, SW1.2 (B), U4.1 (EN)
/USB_C_DN: J1.A7 (D-), J1.B7 (D-), U2.3 (I/O2)
/USB_C_DP: J1.A6 (D+), J1.B6 (D+), U2.1 (I/O1)
/USB_DN: U1.66 (D-), U2.4 (I/O2)
/USB_DP: U1.67 (D+), U2.6 (I/O1)
/VBAT_SENSE: C3.1, R12.2, R13.1, U1.30 (38_CS1_IN1)
/VBUS: C4.1, D3.2 (A), J1.A4 (VBUS), J1.A9 (VBUS), J1.B4 (VBUS), J1.B9 (VBUS), Q1.1 (G), R17.1, R18.1, R19.1, U1.49 (VUSB), U2.5 (VBUS), U3.4 (V_{CC}), U3.8 (CE)
/VSYS: C6.1, C7.1, D3.1 (K), Q1.2 (S), R12.1, SW1.3 (C), U4.10 (VIN)

Notes on the sheet:
Teensy 4.1 (DM4, DM12, DM35): на гребінках 2 × 24 крізь плату, зазор 2,5 мм під PSRAM; VIN = +4V2; перемичку VIN–VUSB на модулі РОЗРІЗАТИ, VUSB = VBUS з USB-C; USB device D−/D+ — отвори знизу модуля (креслення PJRC) → площадки 66/67 під ними, VUSB — дротик (49)
USB-C (GCT USB4110-GF-A, повністю SMD — під MASTER, DM25): аудіо, MIDI, заряд. CC 5,1k — пристрій-споживач; ESD USBLC6
Заряд 1S (DM11): TP4056, R_PROG 2,4k → 0,5 A; TEMP на GND — без NTC. CHRG / STDBY — світлодіоди
Load sharing (02, п. 4): від USB — через діод, акумулятор відключає P-MOSFET (затвор = VBUS)
Buck-boost TPS63802 → +4V2 (DM11). R1/R2 = 665k/91k → 4,15 V (VFB 0,5 V, табл. 10-5); L 0,47 µH XFL4015; C 10 µF вх., 2×22 µF вих. (>3,6 V). Вимикач — кнопка з фіксацією 5,8 мм на EN (DM27)
LP5907 3,3 V — аналог кодеків (+3V3A): < 6,5 µVrms, 250 mA; навантаження 128 mA (calc/power.py). Ємність на всій шині +3V3A — 0,7…10 µF (datasheet, COUT): 2,2 µF тут + 1 µF біля кожного кодека + 100 nF ≈ 8 µF
АЦП1 PCM1865 (I²C 0x94): входи IN1, IN2. Ведений TDM, слоти 1–4. Вхід: 10k послідовно (−6 dB з 10 kΩ входу) + 10 µF
АЦП2 PCM1865 (I²C 0x96): входи IN3, IN4. Ведений TDM, слоти 5–8. Вхід: 10k послідовно (−6 dB з 10 kΩ входу) + 10 µF
ЦАП MAIN PCM5102A: I²S, BCK PLL (SCK = GND), FMT/FLT/DEMP = GND; вихід 470 Ω + 2,2 nF (рис. 33). XSMT — спільний з Teensy
ЦАП AUX PCM5102A: I²S, BCK PLL (SCK = GND), FMT/FLT/DEMP = GND; вихід 470 Ω + 2,2 nF (рис. 33). XSMT — спільний з Teensy
ЦАП CUE PCM5102A: I²S, BCK PLL (SCK = GND), FMT/FLT/DEMP = GND; вихід 470 Ω + 2,2 nF (рис. 33). XSMT — спільний з Teensy
Навушники TPA6132A2 (рис. 27, несиметричний вхід): G0 = G1 = GND → −6 dB (2,1 Vrms ЦАП → ≈1 Vrms); EN від Teensy. QFN — лише при передзбиранні JLCPCB (DM7)
MIDI OUT, TRS Type A (DM20): кінчик = DIN 5 (через RC 10 Ω від UART), кільце = DIN 4 (RA 33 Ω від +3,3 V), гільза = DIN 2 / GND. Значення для 3,3 V — MIDI 1.0 Electrical Spec Update, рис. 1
MCP23017 #1 (I²C2, 0x20): енкодери каналів 1, 2 (A/B), Mute; GPx7 вільні; внутрішні підтяжки 100k, INTA/INTB дзеркальні → один INT
MCP23017 #2 (I²C2, 0x21): енкодери каналів 3, 4 (A/B), Mute; GPx7 вільні; внутрішні підтяжки 100k, INTA/INTB дзеркальні → один INT
MCP23017 #3 (I²C2, 0x22): кнопки 12 енкодерів каналів (DM28: натискання — фільтр / компресор, скидання значення) і кнопки AUX, FX I, FX II (GPA6, GPA7, GPB6) — найближчий до правої колонки; GPB7 вільний
Канал 1: 3 енкодери EC12SY SMD з кнопкою (шари EQ / посили / канал, DM6, DM26), фейдер 35 мм Alps RS201111J011 (DM8, DM39), Mute — тактова кнопка TSF-1266 (DM16)
Канал 2: 3 енкодери EC12SY SMD з кнопкою (шари EQ / посили / канал, DM6, DM26), фейдер 35 мм Alps RS201111J011 (DM8, DM39), Mute — тактова кнопка TSF-1266 (DM16)
Канал 3: 3 енкодери EC12SY SMD з кнопкою (шари EQ / посили / канал, DM6, DM26), фейдер 35 мм Alps RS201111J011 (DM8, DM39), Mute — тактова кнопка TSF-1266 (DM16)
Канал 4: 3 енкодери EC12SY SMD з кнопкою (шари EQ / посили / канал, DM6, DM26), фейдер 35 мм Alps RS201111J011 (DM8, DM39), Mute — тактова кнопка TSF-1266 (DM16)
Майстер: енкодер EC12SY з кнопкою, кнопки AUX, FX I, FX II, SHIFT (TSF-1266; CUE = SHIFT + Mute, DM28); дисплей GMT147SPI 1,47" 172×320 ST7789P3, SPI, на гребінці (DM18, DM23); виводи — за кресленням продавця
Прапорці живлення: шини, які в символах не мають «виходу живлення» (GND, вихід 3,3 V Teensy, VBUS, внутрішні LDO PCM1865, накачка TPA6132A2, VSYS після діода / ключа)

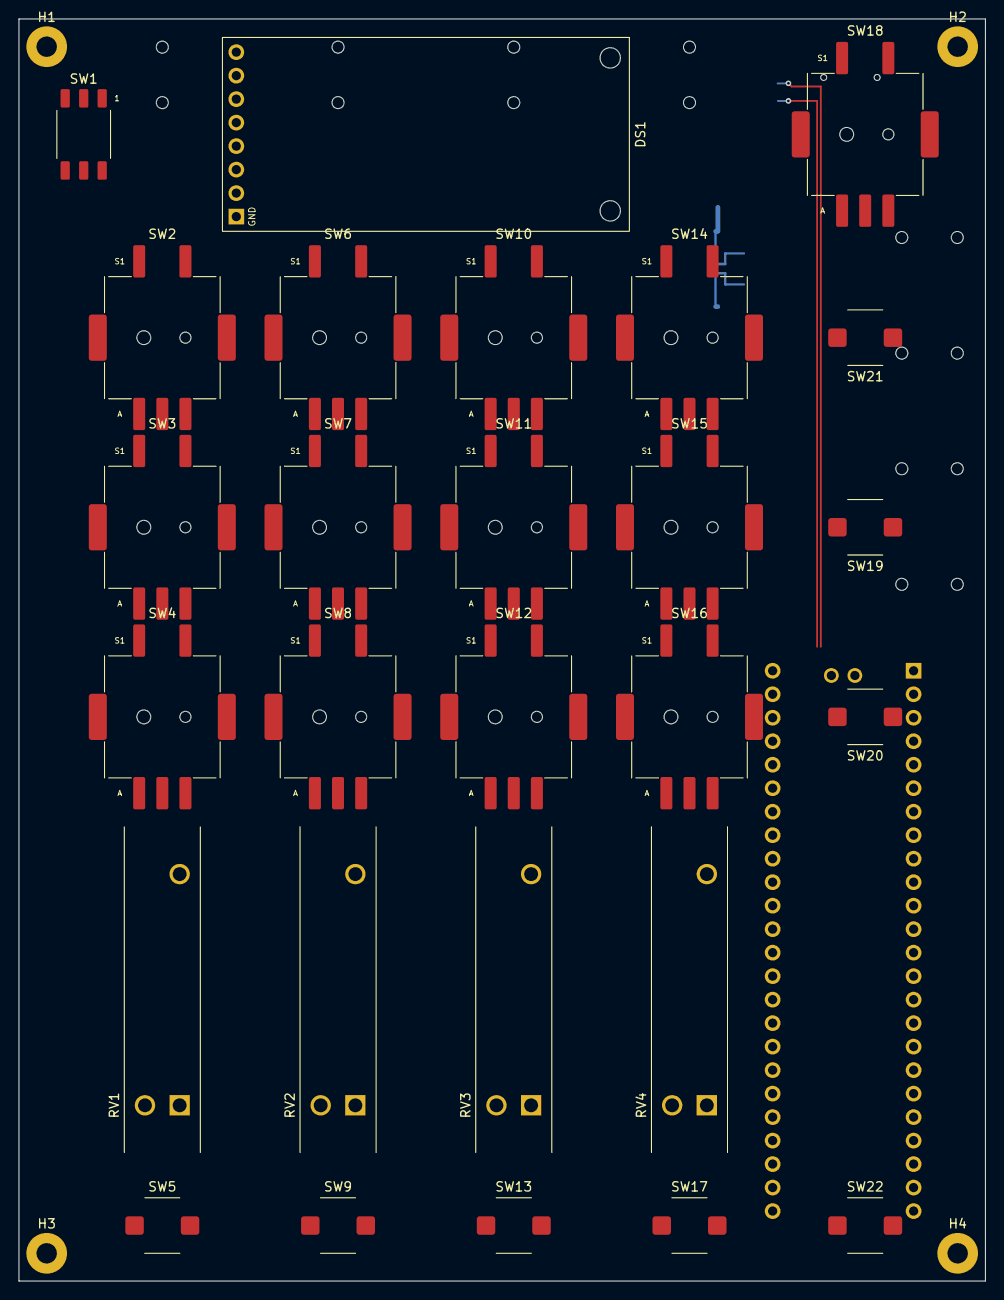
[picture p27: board main.kicad_pcb from above]

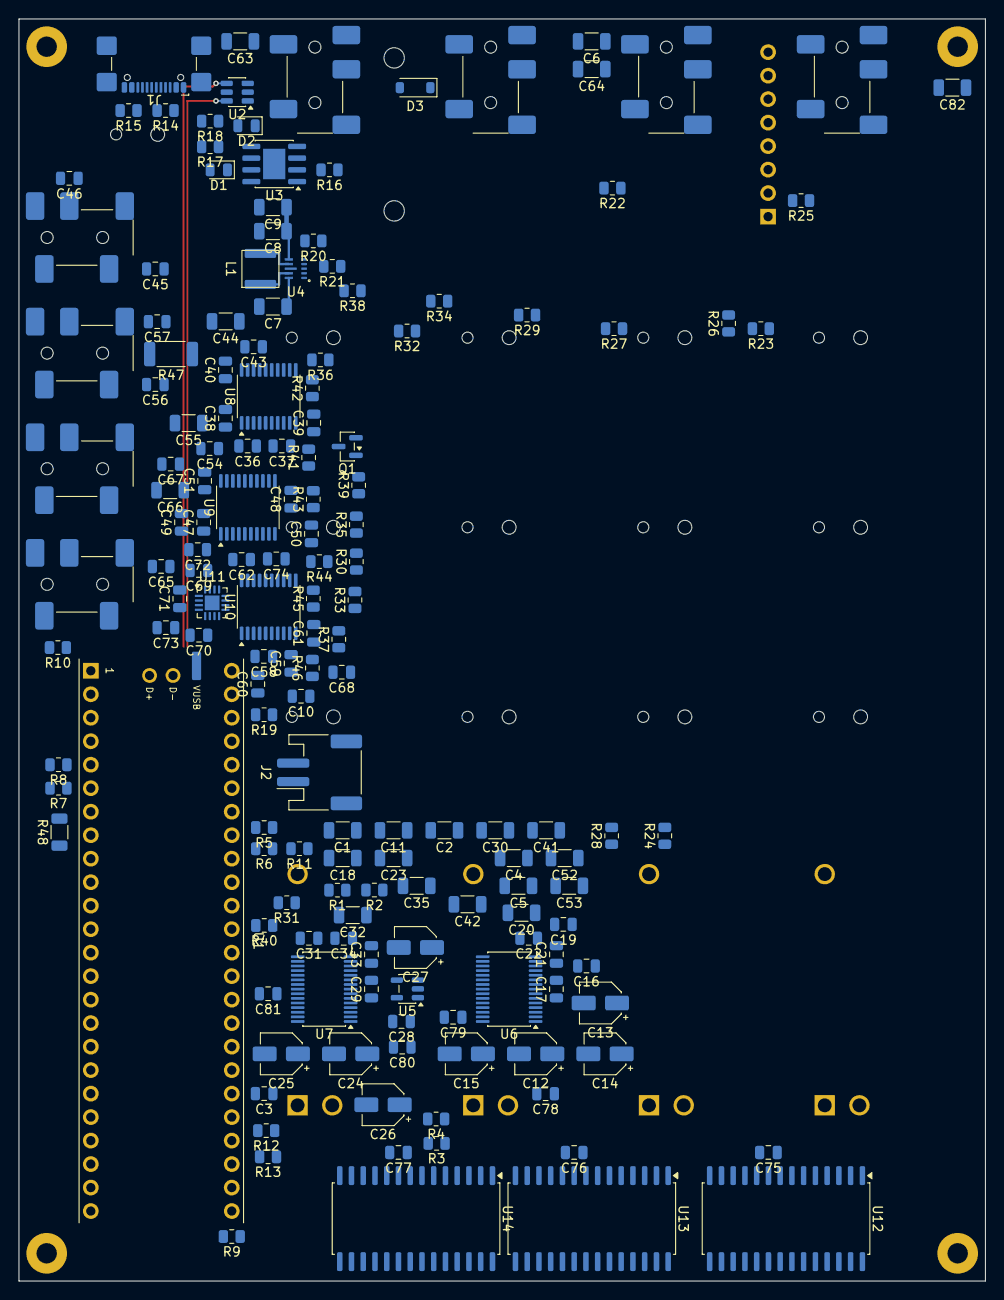
[picture p28: board main.kicad_pcb from below]

Board: 2 copper layers, 104.5 x 136.5 mm, 190 parts (159 on the bottom side), 168 nets.

Other parts of the board:
H1, H2, H3, H4: M2; MountingHole_2.2mm_M2_Pad_Standoff_2Side

Their connections:
/GND: H1.1, H2.1, H3.1, H4.1; also elsewhere on the board
