heartpolik/hardware-pocket-mixer/hw/digital/digital.kicad_pcb

## KiCad design hw/digital/digital.kicad_pcb (2026-10-26)

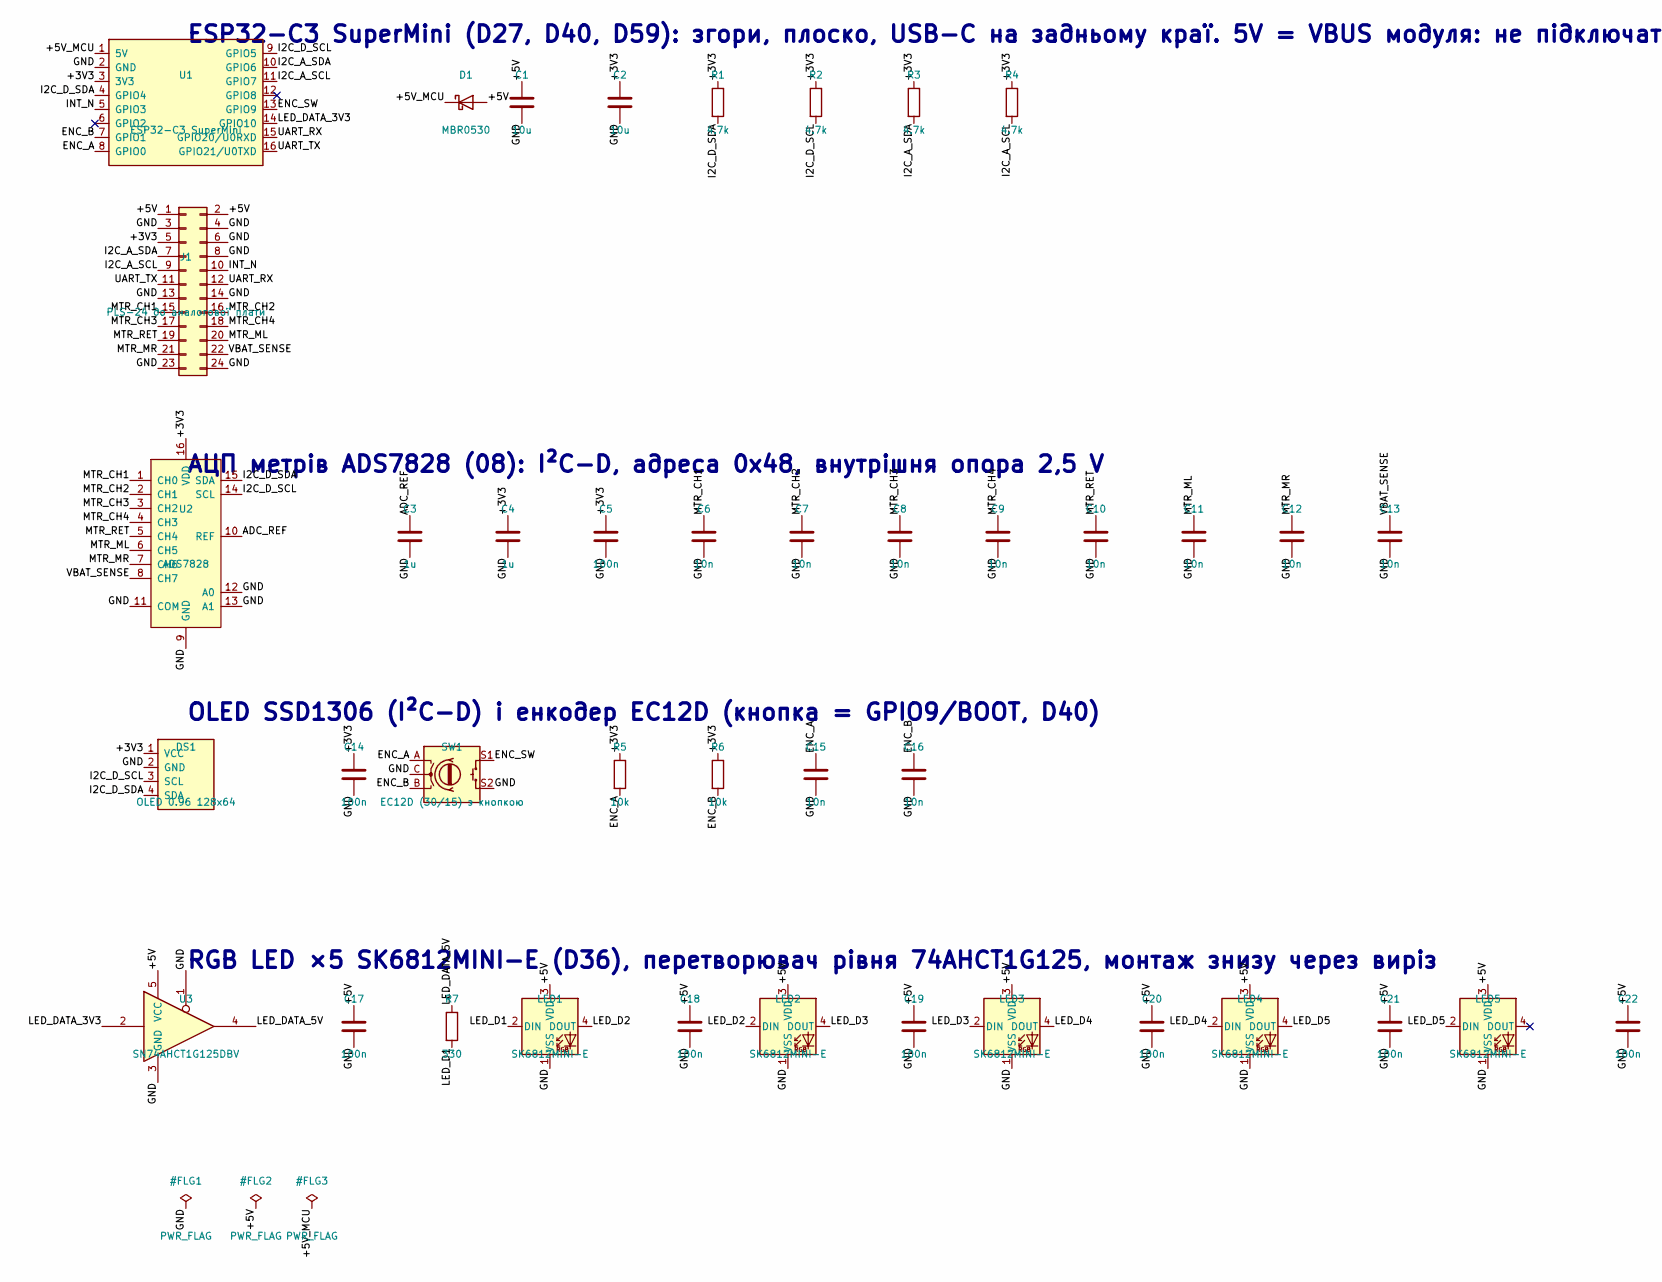
[picture p29: schematic digital.kicad_sch, diy-mixer Rev A — digital board, part in row 1, column 1]

Parts:
C1, C2: 10u; C_1206_3216Metric
C3, C4: 1u; C_0805_2012Metric
C5, C14, C17, C18, C19, C20, C21, C22: 100n; C_0805_2012Metric
C6, C7, C8, C9, C10, C11, C12, C13, C15, C16: 10n; C_0805_2012Metric
C23: 47u; C_1206_3216Metric
D1: MBR0530; D_SOD-123
DS1: OLED 0.96 128x64; OLED_0.96in_128x64_I2C_4pin
J1: PLS-24 до аналогової плати; PinHeader_2x12_P2.54mm_Vertical
LED1, LED2, LED3, LED4, LED5: SK6812MINI-E; LED_SK6812MINI-E_3.2x2.8mm_P1.5mm_ReverseMount
R1, R2, R3, R4: 4.7k; R_0805_2012Metric
R5, R6: 10k; R_0805_2012Metric
R7: 330; R_0805_2012Metric
SW1: EC12D (30/15) з кнопкою; Alps_EC12D_Switch
U1: ESP32-C3 SuperMini; ESP32-C3_SuperMini_SMD
U2: ADS7828; TSSOP-16_4.4x5mm_P0.65mm
U3: SN74AHCT1G125DBV; SOT-23-5

Connections:
/+3V3: C2.1, C4.1, C5.1, C14.1, DS1.1 (VCC), J1.5, R1.1, R2.1, R3.1, R4.1, R5.1, R6.1, U1.3 (3V3), U2.16 (VDD)
/+5V: C1.1, C17.1, C18.1, C19.1, C20.1, C21.1, C22.1, C23.1, D1.2 (A), J1.1, J1.2, LED1.3 (VDD), LED2.3 (VDD), LED3.3 (VDD), LED4.3 (VDD), LED5.3 (VDD), U3.5 (VCC)
/+5V_MCU: D1.1 (K), U1.1 (5V)
/ADC_REF: C3.1, U2.10 (REF)
/ENC_A: C15.1, R5.2, SW1.A, U1.8 (GPIO0)
/ENC_B: C16.1, R6.2, SW1.B, U1.7 (GPIO1)
/ENC_SW: SW1.S1, U1.13 (GPIO9)
/GND: C1.2, C2.2, C3.2, C4.2, C5.2, C6.2, C7.2, C8.2, C9.2, C10.2, C11.2, C12.2, C13.2, C14.2, C15.2, C16.2, C17.2, C18.2, C19.2, C20.2, C21.2, C22.2, C23.2, DS1.2 (GND), J1.3, J1.4, J1.6, J1.8, J1.13, J1.14, J1.23, J1.24, LED1.1 (VSS), LED2.1 (VSS), LED3.1 (VSS), LED4.1 (VSS), LED5.1 (VSS), SW1.C, SW1.S2, U1.2 (GND), U2.9 (GND), U2.11 (COM), U2.12 (A0), U2.13 (A1), U3.1, U3.3 (GND); also elsewhere on the board
/I2C_A_SCL: J1.9, R4.2, U1.11 (GPIO7)
/I2C_A_SDA: J1.7, R3.2, U1.10 (GPIO6)
/I2C_D_SCL: DS1.3 (SCL), R2.2, U1.9 (GPIO5), U2.14 (SCL)
/I2C_D_SDA: DS1.4 (SDA), R1.2, U1.4 (GPIO4), U2.15 (SDA)
/INT_N: J1.10, U1.5 (GPIO3)
/LED_D1: LED1.2 (DIN), R7.2
/LED_D2: LED1.4 (DOUT), LED2.2 (DIN)
/LED_D3: LED2.4 (DOUT), LED3.2 (DIN)
/LED_D4: LED3.4 (DOUT), LED4.2 (DIN)
/LED_D5: LED4.4 (DOUT), LED5.2 (DIN)
/LED_DATA_3V3: U1.14 (GPIO10), U3.2
/LED_DATA_5V: R7.1, U3.4
/MTR_CH1: C6.1, J1.15, U2.1 (CH0)
/MTR_CH2: C7.1, J1.16, U2.2 (CH1)
/MTR_CH3: C8.1, J1.17, U2.3 (CH2)
/MTR_CH4: C9.1, J1.18, U2.4 (CH3)
/MTR_ML: C11.1, J1.20, U2.6 (CH5)
/MTR_MR: C12.1, J1.21, U2.7 (CH6)
/MTR_RET: C10.1, J1.19, U2.5 (CH4)
/UART_RX: J1.12, U1.15 (GPIO20/U0RXD)
/UART_TX: J1.11, U1.16 (GPIO21/U0TXD)
/VBAT_SENSE: C13.1, J1.22, U2.8 (CH7)

Notes on the sheet:
ESP32-C3 SuperMini (D27, D40, D59): згори, плоско, USB-C на задньому краї. 5V = VBUS модуля: не підключати USB модуля при увімкненому мікшері
АЦП метрів ADS7828 (08): I²C-D, адреса 0x48, внутрішня опора 2,5 V
OLED SSD1306 (I²C-D) і енкодер EC12D (кнопка = GPIO9/BOOT, D40)
RGB LED ×5 SK6812MINI-E (D36), перетворювач рівня 74AHCT1G125, монтаж знизу через виріз

Board: 2 copper layers, 44 parts (39 on the bottom side), 30 nets, no tracks yet.

Other parts of the board:
H1, H2: M2; MountingHole_2.2mm_M2_Pad_Standoff_2Side

Their connections:
/GND: H1.1, H2.1; also elsewhere on the board
