heartpolik/hardware-pocket-mixer/analog-mixer/hw/analog/analog_routed.kicad_pcb

## KiCad design analog-mixer/hw/analog/analog_routed.kicad_pcb (2026-10-26)

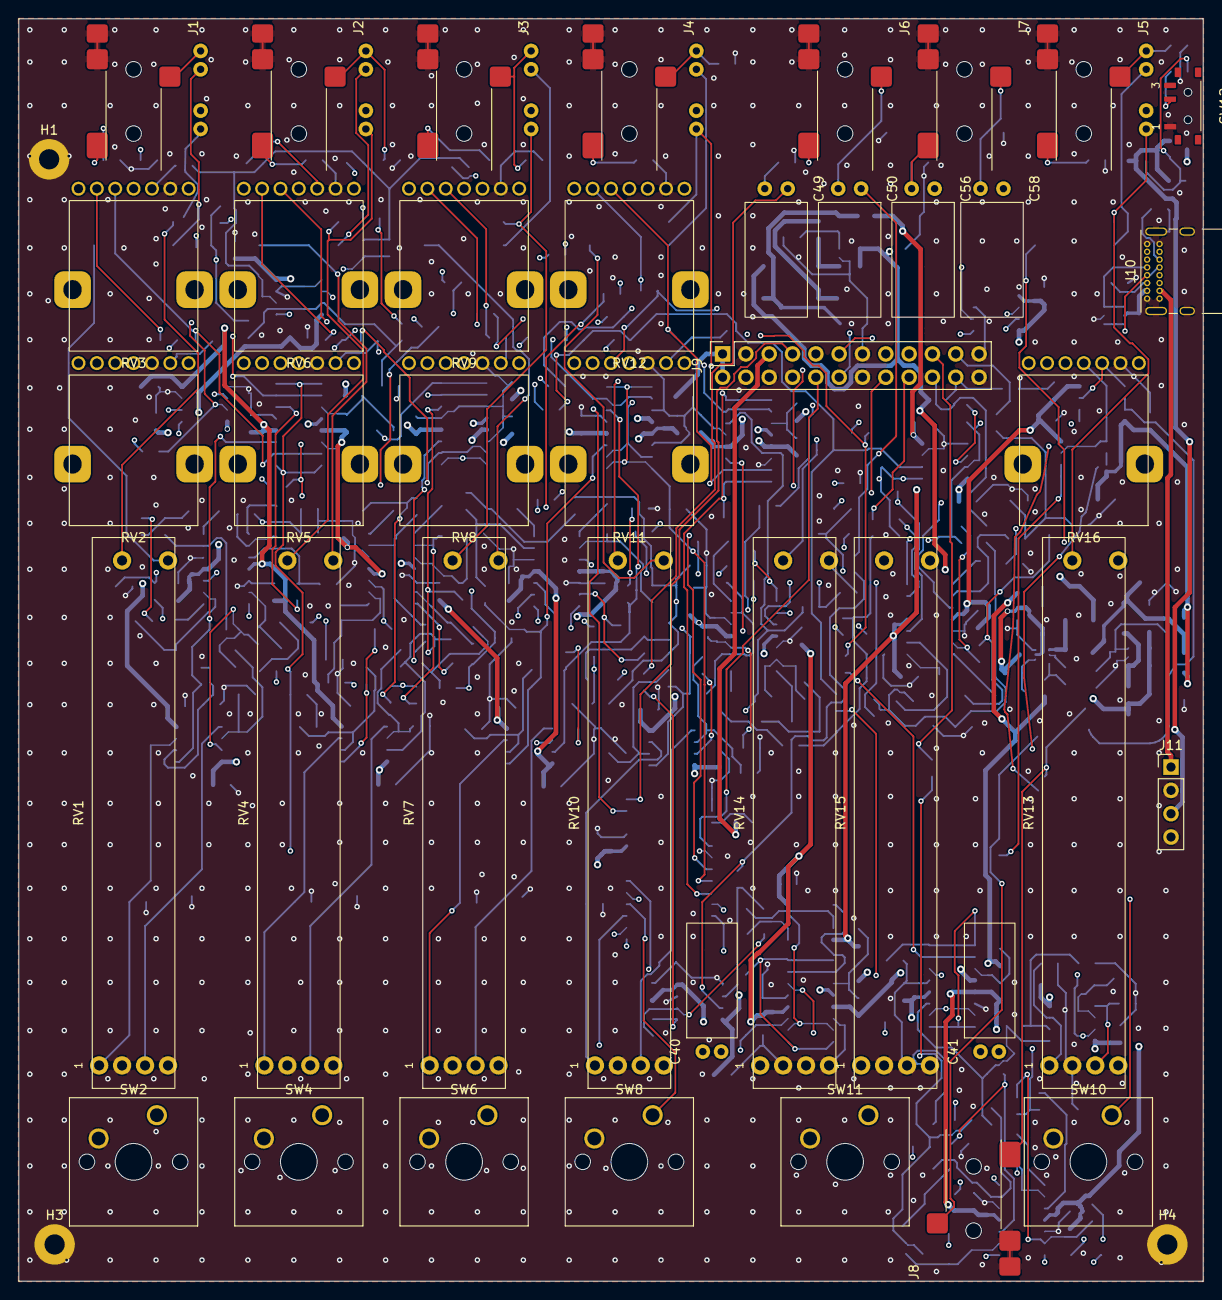
[picture p30: board analog_routed.kicad_pcb from above]

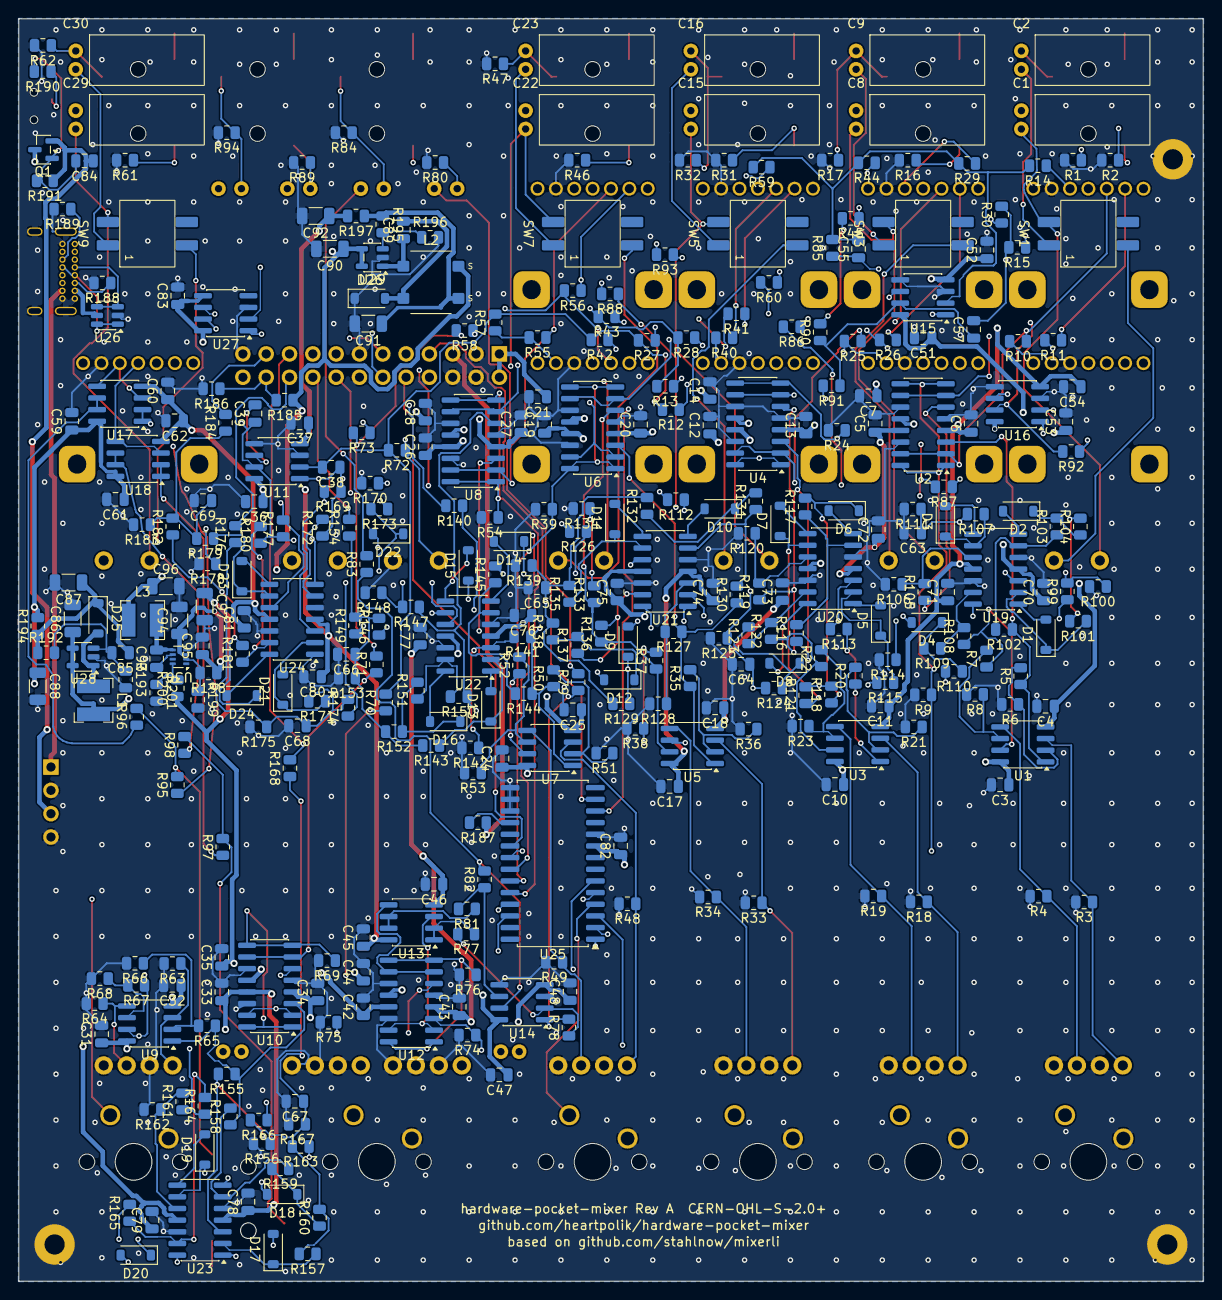
[picture p31: board analog_routed.kicad_pcb from below]

Board: 4 copper layers, 129.0 x 137.5 mm, 400 parts (357 on the bottom side), 251 nets.

Parts:
C1, C2, C8, C9, C15, C16, C22, C23, C29, C30, C40, C41: 10u BP; CP_Nichicon_UEP_D5.0_L11.0_P2.00_Horizontal
C3, C4, C5, C6, C7, C10, C11, C12, C13, C14, C17, C18, C19, C20, C21, C24, C25, C26, C27, C28, C31, C32, C33, C34, C35, C36, C37, C42, C43, C44, C45, C46, C47, C48, C51, C52, C53, C54, C59, C60, C61, C62, C70, C71, C72, C73, C74, C75, C76, C77, C78, C79, C80, C81, C82, C83, C84, C93, C95: 100n; C_0805_2012Metric
C38, C39: 39p C0G; C_0805_2012Metric
C49, C50, C56, C58: 47u BP; CP_Nichicon_UEP_D6.3_L11.0_P2.50_Horizontal
C55, C57: 150p C0G; C_0805_2012Metric
C63, C64, C65, C66, C67, C68, C69: 0.33u; C_0805_2012Metric
C85: 10p C0G; C_0805_2012Metric
C86, C90: 4.7u 25V; C_1206_3216Metric
C87, C91, C94: 10u 25V; C_1206_3216Metric
C88, C92: 22u 25V; C_1206_3216Metric
C89: 1u 25V; C_0805_2012Metric
C96, C97: 22u 10V; C_1206_3216Metric
D1, D2, D3, D4, D5, D6, D7, D8, D9, D10, D11, D12, D13, D14, D15, D16, D17, D18, D19, D20, D21, D22, D23, D24: 1N4148W; D_SOD-123
D25, D26: MBR0530; D_SOD-123
H1, H3, H4: M2; MountingHole_2.2mm_M2_Pad_Standoff_2Side
J1, J2, J3, J4, J5: SJ-43514-SMT; CUI_SJ-43514-SMT_TRRS_Horizontal
J6: SJ-43514-SMT MAIN; CUI_SJ-43514-SMT_TRRS_Horizontal
J7: SJ-43514-SMT SEND; CUI_SJ-43514-SMT_TRRS_Horizontal
J8: SJ-43514-SMT PHONES; CUI_SJ-43514-SMT_TRRS_Horizontal
J9: PBS-24 до цифрової плати; PinSocket_2x12_P2.54mm_Vertical
J10: GCT USB4085; USB_C_Receptacle_GCT_USB4085
J11: Модуль IP2326: VBUS, GND, BAT+, GND; PinHeader_1x04_P2.54mm_Vertical
L1: 10u SRN4018-100M; L_Bourns-SRN4018
L2: 2x10u CLS62-100; L_Sumida_CLS62
L3: 4.7u SRN4018-4R7M; L_Bourns-SRN4018
Q1: AO3401A; SOT-23
R1, R2, R3, R4, R16, R17, R18, R19, R31, R32, R33, R34, R46, R47, R48, R49, R61, R62, R63, R64, R74, R75: 1M; R_0805_2012Metric
R5, R6, R7, R8, R10, R11, R20, R21, R22, R23, R25, R26, R35, R36, R37, R38, R40, R41, R50, R51, R52, R53, R55, R56, R65, R66, R67, R68, R77, R78, R81, R82, R85, R86, R87, R90, R91, R92, R112, R126, R140, R154, R168, R176, R184, R187, R190, R196: 10k; R_0805_2012Metric
R9, R24, R39, R54, R69, R76, R80, R84, R89, R94, R100, R106, R114, R120, R128, R134, R142, R148, R156, R162, R170, R178, R186, R191, R198, R199: 100k; R_0805_2012Metric
R12, R13, R27, R28, R42, R43, R57, R58: 22k; R_0805_2012Metric
R14, R15, R29, R30, R44, R45, R59, R60: 20k; R_0805_2012Metric
R70, R71: 76.8k; R_0805_2012Metric
R72, R73: 38.3k; R_0805_2012Metric
R79, R83, R88, R93: 100; R_0805_2012Metric
R95, R96, R97, R98: 10; R_0805_2012Metric
R99, R105, R113, R119, R127, R133, R141, R147, R155, R161, R169, R177: 374k; R_0805_2012Metric
R101, R104, R107, R110, R115, R118, R121, R124, R129, R132, R135, R138, R143, R146, R149, R152, R157, R160, R163, R166, R171, R174, R179, R182: 330; R_0805_2012Metric
R102, R108, R116, R122, R130, R136, R144, R150, R158, R164, R172, R180: 953k; R_0805_2012Metric
R103, R109, R117, R123, R131, R137, R145, R151, R159, R165, R173, R181: 200k; R_0805_2012Metric
R111, R125, R139, R153, R167: 634k; R_0805_2012Metric
R175, R183: 412k; R_0805_2012Metric
R185: 249k; R_0805_2012Metric
R188, R189: 5.1k; R_0805_2012Metric
R192: 113k; R_0805_2012Metric
R193: 13.3k; R_0805_2012Metric
R194, R197: 2.2; R_0805_2012Metric
R195: 84.5k; R_0805_2012Metric
R200: 53.6k; R_0805_2012Metric
R201: 10.2k; R_0805_2012Metric
RV1, RV4, RV7, RV10, RV13, RV14, RV15: RS451121400A 10k B; Alps_RS451121400A_Fader_Dual_45mm
RV2, RV5, RV8, RV11: RK14K124003H 10k B detent; Alps_RK14K124_Vertical_Tone
RV3, RV6, RV9, RV12: RK14K12D 50k A; Alps_RK14K12D_Vertical_Volume
RV16: RK14K12D 50k A PHONES; Alps_RK14K12D_Vertical_Volume
SW1, SW3, SW5, SW7, SW9: CTS 204-121ST; CTS_204-121ST_DIP_SPDT_1pos_SMD
SW2, SW4, SW6, SW8, SW10, SW11: Cherry MX; SW_Cherry_MX_1.00u_PCB
SW12: MSK12C02 вимикач живлення; SW_Slide_SPDT_SHOUHAN_MSK12C02_RightAngle
U1, U3, U5, U7, U9, U11, U13, U14, U15, U16, U17, U18: OPA1678; SOIC-8_3.9x4.9mm_P1.27mm
U2, U4, U6, U8, U10, U12: DG413; SOIC-16_3.9x9.9mm_P1.27mm
U19, U20, U21, U22, U23, U24: TL064AC; SOIC-14_3.9x8.7mm_P1.27mm
U25: MCP23017-E/SO; SOIC-28W_7.5x17.9mm_P1.27mm
U26: USBLC6-2SC6; SOT-23-6
U27: CH340N; SOIC-8_3.9x4.9mm_P1.27mm
U28: LT1930ES5; SOT-23-5
U29: LT1931ES5; SOT-23-5
U30: TPS62933O; SOT-583-8

Connections:
/+3V3: C82.1, C83.1, J9.5, R187.1, U25.9, U27.5, U27.8
/+5V: C7.1, C14.1, C21.1, C28.1, C35.1, C44.1, C96.1, C97.1, J9.1, J9.2, L3.2, R200.1, U2.12, U4.12, U6.12, U8.12, U10.12, U12.12
/+12VA: C3.1, C5.1, C10.1, C12.1, C17.1, C19.1, C24.1, C26.1, C31.1, C33.1, C36.1, C42.1, C45.1, C47.1, C51.1, C53.1, C59.1, C61.1, C70.1, C72.1, C74.1, C76.1, C78.1, C80.1, C88.1, R194.2, U1.8, U2.13, U3.8, U4.13, U5.8, U6.13, U7.8, U8.13, U9.8, U10.13, U11.8, U12.13, U13.8, U14.8, U15.8, U16.8, U17.8, U18.8, U19.4, U20.4, U21.4, U22.4, U23.4, U24.4
/+12V_P: C85.1, C87.1, D25.1, R192.1, R194.1
/-12VA: C4.1, C6.1, C11.1, C13.1, C18.1, C20.1, C25.1, C27.1, C32.1, C34.1, C37.1, C43.1, C46.1, C48.1, C52.1, C54.1, C60.1, C62.1, C71.1, C73.1, C75.1, C77.1, C79.1, C81.1, C92.1, R197.2, U1.4, U2.4, U3.4, U4.4, U5.4, U6.4, U7.4, U8.4, U9.4, U10.4, U11.4, U12.4, U13.4, U14.4, U15.4, U16.4, U17.4, U18.4, U19.11, U20.11, U21.11, U22.11, U23.11, U24.11
/-12V_P: C91.1, L2.3, R195.1, R197.1
/BAT+: C84.1, J11.3, Q1.2, R191.1
/BST_5: C93.1, U30.6
/BTN_IN1: SW2.1, U25.1
/BTN_IN2: SW4.1, U25.2
/BTN_IN3: SW6.1, U25.3
/BTN_IN4: SW8.1, U25.4
/BTN_M: SW11.1, U25.6
/BTN_RET: SW10.1, U25.5
/CC1: J10.A5, R188.1
/CC2: J10.B5, R189.1
/D_IN1_LN_K: D2.1, R103.2, R104.1
/D_IN1_LN_M: R102.2, R103.1, U19.6
/D_IN1_LN_O: D2.2, U19.7
/D_IN1_LP_IN: R99.2, R100.1, U19.3
/D_IN1_LP_K: D1.1, R101.1, U19.2
/D_IN1_LP_O: D1.2, U19.1
/D_IN1_RN_K: D4.1, R109.2, R110.1
/D_IN1_RN_M: R108.2, R109.1, U19.13
/D_IN1_RN_O: D4.2, U19.14
/D_IN1_RP_IN: R105.2, R106.1, U19.10
/D_IN1_RP_K: D3.1, R107.1, U19.9
/D_IN1_RP_O: D3.2, U19.8
/D_IN2_LN_K: D6.1, R117.2, R118.1
/D_IN2_LN_M: R116.2, R117.1, U20.6
/D_IN2_LN_O: D6.2, U20.7
/D_IN2_LP_IN: R113.2, R114.1, U20.3
/D_IN2_LP_K: D5.1, R115.1, U20.2
/D_IN2_LP_O: D5.2, U20.1
/D_IN2_RN_K: D8.1, R123.2, R124.1
/D_IN2_RN_M: R122.2, R123.1, U20.13
/D_IN2_RN_O: D8.2, U20.14
/D_IN2_RP_IN: R119.2, R120.1, U20.10
/D_IN2_RP_K: D7.1, R121.1, U20.9
/D_IN2_RP_O: D7.2, U20.8
/D_IN3_LN_K: D10.1, R131.2, R132.1
/D_IN3_LN_M: R130.2, R131.1, U21.6
/D_IN3_LN_O: D10.2, U21.7
/D_IN3_LP_IN: R127.2, R128.1, U21.3
/D_IN3_LP_K: D9.1, R129.1, U21.2
/D_IN3_LP_O: D9.2, U21.1
/D_IN3_RN_K: D12.1, R137.2, R138.1
/D_IN3_RN_M: R136.2, R137.1, U21.13
/D_IN3_RN_O: D12.2, U21.14
/D_IN3_RP_IN: R133.2, R134.1, U21.10
/D_IN3_RP_K: D11.1, R135.1, U21.9
/D_IN3_RP_O: D11.2, U21.8
/D_IN4_LN_K: D14.1, R145.2, R146.1
/D_IN4_LN_M: R144.2, R145.1, U22.6
/D_IN4_LN_O: D14.2, U22.7
/D_IN4_LP_IN: R141.2, R142.1, U22.3
/D_IN4_LP_K: D13.1, R143.1, U22.2
/D_IN4_LP_O: D13.2, U22.1
/D_IN4_RN_K: D16.1, R151.2, R152.1
/D_IN4_RN_M: R150.2, R151.1, U22.13
/D_IN4_RN_O: D16.2, U22.14
/D_IN4_RP_IN: R147.2, R148.1, U22.10
/D_IN4_RP_K: D15.1, R149.1, U22.9
/D_IN4_RP_O: D15.2, U22.8
/D_MLN_K: D22.1, R173.2, R174.1
/D_MLN_M: R172.2, R173.1, U24.6
/D_MLN_O: D22.2, U24.7
/D_MLP_IN: R169.2, R170.1, U24.3
/D_MLP_K: D21.1, R171.1, U24.2
/D_MLP_O: D21.2, U24.1
/D_MRN_K: D24.1, R181.2, R182.1
/D_MRN_M: R180.2, R181.1, U24.13
/D_MRN_O: D24.2, U24.14
/D_MRP_IN: R177.2, R178.1, U24.10
/D_MRP_K: D23.1, R179.1, U24.9
/D_MRP_O: D23.2, U24.8
/D_RET_LN_K: D18.1, R159.2, R160.1
/D_RET_LN_M: R158.2, R159.1, U23.6
/D_RET_LN_O: D18.2, U23.7
/D_RET_LP_IN: R155.2, R156.1, U23.3
/D_RET_LP_K: D17.1, R157.1, U23.2
/D_RET_LP_O: D17.2, U23.1
/D_RET_RN_K: D20.1, R165.2, R166.1
/D_RET_RN_M: R164.2, R165.1, U23.13
/D_RET_RN_O: D20.2, U23.14
/D_RET_RP_IN: R161.2, R162.1, U23.10
/D_RET_RP_K: D19.1, R163.1, U23.9
/D_RET_RP_O: D19.2, U23.8
/EN_5: R198.2, R199.1, U30.2
/FB_5: R200.2, R201.1, U30.8
/FB_N: R195.2, R196.1, U29.3
/FB_P: C85.2, R192.2, R193.1, U28.3
/GND: C3.2, C4.2, C5.2, C6.2, C7.2, C10.2, C11.2, C12.2, C13.2, C14.2, C17.2, C18.2, C19.2, C20.2, C21.2, C24.2, C25.2, C26.2, C27.2, C28.2, C31.2, C32.2, C33.2, C34.2, C35.2, C36.2, C37.2, C42.2, C43.2, C44.2, C45.2, C46.2, C47.2, C48.2, C51.2, C52.2, C53.2, C54.2, C59.2, C60.2, C61.2, C62.2, C63.2, C64.2, C65.2, C66.2, C67.2, C68.2, C69.2, C70.2, C71.2, C72.2, C73.2, C74.2, C75.2, C76.2, C77.2, C78.2, C79.2, C80.2, C81.2, C82.2, C83.2, C86.2, C87.2, C88.2, C90.2, C91.2, C92.2, C94.2, C95.2, C96.2, C97.2, D26.1, H1.1, H3.1, H4.1, J1.1, J1.4, J2.1, J2.4, J3.1, J3.4, J4.1, J4.4, J5.1, J5.4, J6.1, J6.4, J7.1, J7.4, J8.1, J8.4, J9.3, J9.4, J9.6, J9.8, J9.13, J9.14, J9.23, J9.24, J10.A1, J10.A12, J10.B1, J10.B12, J10.SH, J11.2, J11.4, R1.2, R2.2, R3.2, R4.2, R6.2, R8.2, R9.2, R16.2, R17.2, R18.2, R19.2, R21.2, R23.2, R24.2, R31.2, R32.2, R33.2, R34.2, R36.2, R38.2, R39.2, R46.2, R47.2, R48.2, R49.2, R51.2, R53.2, R54.2, R61.2, R62.2, R63.2, R64.2, R66.2, R68.2, R69.2, R74.2, R75.2, R76.2, R80.2, R84.2, R89.2, R94.2, R100.2, R106.2, R111.2, R114.2, R120.2, R125.2, R128.2, R134.2, R139.2, R142.2, R148.2, R153.2, R156.2, R162.2, R167.2, R170.2, R175.2, R178.2, R183.2, R186.2, R188.2, R189.2, R193.2, R196.2, R199.2, R201.2, RV1.1, RV1.4, RV2.2, RV3.1, RV4.1, RV4.4, RV5.2, RV6.1, RV7.1, RV7.4, RV8.2, RV9.1, RV10.1, RV10.4, RV11.2, RV12.1, RV13.1, RV13.4, RV14.1, RV14.4, RV14.5, RV14.6, RV15.1, RV15.4, RV15.5, RV15.6, RV16.1, SW2.2, SW4.2, SW6.2, SW8.2, SW10.2, SW11.2, SW12.1, U2.5, U2.11, U2.14, U4.5, U4.11, U4.14, U6.5, U6.11, U6.14, U8.5, U8.11, U8.14, U10.5, U10.11, U10.14, U11.3, U11.5, U12.5, U12.11, U12.14, U14.3, U14.5, U15.3, U15.5, U16.3, U16.5, U19.5, U19.12, U20.5, U20.12, U21.5, U21.12, U22.5, U22.12, U23.5, U23.12, U24.5, U24.12, U25.10, U25.15, U25.16, U25.17, U26.2, U27.3, U28.2, U29.2, U30.4
/I2C_A_SCL: J9.9, U25.12
/I2C_A_SDA: J9.7, U25.13
/IN1_LB: R5.1, R99.1, R102.1, U1.1, U2.3
/IN1_LFB: R5.2, R6.1, U1.2
/IN1_LM: R10.1, RV3.3, U2.2, U2.15
/IN1_LP: R10.2, R12.1, RV2.1
/IN1_LS: R14.1, RV3.2
/IN1_LW: R3.1, RV1.2, U1.3
/IN1_R: C2.1, J1.3, R2.1
/IN1_RB: R7.1, R105.1, R108.1, U1.7, U2.6
/IN1_RC: C2.2, SW1.4
/IN1_RFB: R7.2, R8.1, U1.6
/IN1_RM: R11.1, RV3.6, U2.7, U2.10
/IN1_RP: R11.2, R13.1, RV2.3
/IN1_RS: R15.1, RV3.5
/IN1_RTOP: RV1.6, SW1.1
/IN1_RW: R4.1, RV1.5, U1.5
/IN1_T: C1.1, J1.2, R1.1
/IN1_TC: C1.2, RV1.3, SW1.3
/IN2_LB: R20.1, R113.1, R116.1, U3.1, U4.3
/IN2_LFB: R20.2, R21.1, U3.2
/IN2_LM: R25.1, RV6.3, U4.2, U4.15
/IN2_LP: R25.2, R27.1, RV5.1
/IN2_LS: R29.1, RV6.2
/IN2_LW: R18.1, RV4.2, U3.3
/IN2_R: C9.1, J2.3, R17.1
/IN2_RB: R22.1, R119.1, R122.1, U3.7, U4.6
/IN2_RC: C9.2, SW3.4
/IN2_RFB: R22.2, R23.1, U3.6
/IN2_RM: R26.1, RV6.6, U4.7, U4.10
/IN2_RP: R26.2, R28.1, RV5.3
/IN2_RS: R30.1, RV6.5
/IN2_RTOP: RV4.6, SW3.1
/IN2_RW: R19.1, RV4.5, U3.5
/IN2_T: C8.1, J2.2, R16.1
/IN2_TC: C8.2, RV4.3, SW3.3
/IN3_LB: R35.1, R127.1, R130.1, U5.1, U6.3
/IN3_LFB: R35.2, R36.1, U5.2
/IN3_LM: R40.1, RV9.3, U6.2, U6.15
/IN3_LP: R40.2, R42.1, RV8.1
/IN3_LS: R44.1, RV9.2
/IN3_LW: R33.1, RV7.2, U5.3
/IN3_R: C16.1, J3.3, R32.1
/IN3_RB: R37.1, R133.1, R136.1, U5.7, U6.6
/IN3_RC: C16.2, SW5.4
/IN3_RFB: R37.2, R38.1, U5.6
/IN3_RM: R41.1, RV9.6, U6.7, U6.10
/IN3_RP: R41.2, R43.1, RV8.3
/IN3_RS: R45.1, RV9.5
/IN3_RTOP: RV7.6, SW5.1
/IN3_RW: R34.1, RV7.5, U5.5
/IN3_T: C15.1, J3.2, R31.1
/IN3_TC: C15.2, RV7.3, SW5.3
/IN4_LB: R50.1, R141.1, R144.1, U7.1, U8.3
/IN4_LFB: R50.2, R51.1, U7.2
/IN4_LM: R55.1, RV12.3, U8.2, U8.15
/IN4_LP: R55.2, R57.1, RV11.1
/IN4_LS: R59.1, RV12.2
/IN4_LW: R48.1, RV10.2, U7.3
/IN4_R: C23.1, J4.3, R47.1
/IN4_RB: R52.1, R147.1, R150.1, U7.7, U8.6
/IN4_RC: C23.2, SW7.4
/IN4_RFB: R52.2, R53.1, U7.6
/IN4_RM: R56.1, RV12.6, U8.7, U8.10
/IN4_RP: R56.2, R58.1, RV11.3
/IN4_RS: R60.1, RV12.5
/IN4_RTOP: RV10.6, SW7.1
/IN4_RW: R49.1, RV10.5, U7.5
/IN4_T: C22.1, J4.2, R46.1
/IN4_TC: C22.2, RV10.3, SW7.3
/INT_N: J9.10, U25.20
/MAIN_L: C49.2, J6.2, R80.1
/MAIN_R: C50.2, J6.3, R84.1
/MCP_RST: R187.2, U25.18
/ML_B: R77.1, U13.1, U13.2
/ML_C: C40.2, R74.1, U12.3
/ML_INV: R77.2, R78.1, U14.2
/ML_M: U12.2, U12.15, U13.3
/ML_O: C49.1, R79.2
/ML_OUT: R78.2, R79.1, U14.1
/ML_W: C40.1, RV14.2
/MR_B: R81.1, U13.6, U13.7
/MR_C: C41.2, R75.1, U12.6
/MR_INV: R81.2, R82.1, U14.6
/MR_M: U12.7, U12.10, U13.5
/MR_O: C50.1, R83.2
/MR_OUT: R82.2, R83.1, U14.7
/MR_W: C41.1, RV15.2
/MTR_CH1: J9.15, R112.2
/MTR_CH1_H: C63.1, R101.2, R104.2, R107.2, R110.2, R111.1, R112.1
/MTR_CH2: J9.16, R126.2
/MTR_CH2_H: C64.1, R115.2, R118.2, R121.2, R124.2, R125.1, R126.1
/MTR_CH3: J9.17, R140.2
/MTR_CH3_H: C65.1, R129.2, R132.2, R135.2, R138.2, R139.1, R140.1
/MTR_CH4: J9.18, R154.2
/MTR_CH4_H: C66.1, R143.2, R146.2, R149.2, R152.2, R153.1, R154.1
/MTR_ML: J9.20, R176.2
/MTR_ML_H: C68.1, R171.2, R174.2, R175.1, R176.1
/MTR_MR: J9.21, R184.2
/MTR_MR_H: C69.1, R179.2, R182.2, R183.1, R184.1
/MTR_RET: J9.19, R168.2
/MTR_RET_H: C67.1, R157.2, R160.2, R163.2, R166.2, R167.1, R168.1
/MUTE_IN1: R9.1, U2.1, U2.8, U2.9, U2.16, U25.21
/MUTE_IN2: R24.1, U4.1, U4.8, U4.9, U4.16, U25.22
/MUTE_IN3: R39.1, U6.1, U6.8, U6.9, U6.16, U25.23
/MUTE_IN4: R54.1, U8.1, U8.8, U8.9, U8.16, U25.24
/MUTE_M: R76.1, U12.1, U12.8, U12.9, U12.16, U25.26
/MUTE_RET: R69.1, U10.1, U10.8, U10.9, U10.16, U25.25
/N_N: C89.2, D26.2, L2.4
/PH_L: J8.2, R95.2, R96.2
/PH_LA: R95.1, U17.1, U17.2
/PH_LB: R96.1, U17.6, U17.7
/PH_LW: RV16.2, U17.3, U17.5
/PH_R: J8.3, R97.2, R98.2
/PH_RA: R97.1, U18.1, U18.2
/PH_RB: R98.1, U18.6, U18.7
/PH_RW: RV16.5, U18.3, U18.5
/PWR_G: C84.2, Q1.1, R190.2, R191.2
/PWR_G_SW: R190.1, SW12.2
/RET_LB: R65.1, R155.1, R158.1, U9.1, U10.3
/RET_LFB: R65.2, R66.1, U9.2
/RET_LM: R70.1, U10.2, U10.15
/RET_LW: R63.1, RV13.2, U9.3
/RET_R: C30.1, J5.3, R62.1
/RET_RB: R67.1, R161.1, R164.1, U9.7, U10.6
/RET_RC: C30.2, SW9.4
/RET_RFB: R67.2, R68.1, U9.6
/RET_RM: R71.1, U10.7, U10.10
/RET_RTOP: RV13.6, SW9.1
/RET_RW: R64.1, RV13.5, U9.5
/RET_T: C29.1, J5.2, R61.1
/RET_TC: C29.2, RV13.3, SW9.3
/SEND_L: C56.2, J7.2, R89.1
/SEND_L_IN: C55.2, R14.2, R29.2, R44.2, R59.2, R85.2, U15.2
/SEND_L_INV: R86.2, R87.1, U16.2
/SEND_L_O: C56.1, R88.2
/SEND_L_OUT: R87.2, R88.1, U16.1
/SEND_L_S: C55.1, R85.1, R86.1, U15.1
/SEND_R: C58.2, J7.3, R94.1
/SEND_R_IN: C57.2, R15.2, R30.2, R45.2, R60.2, R90.2, U15.6
/SEND_R_INV: R91.2, R92.1, U16.6
/SEND_R_O: C58.1, R93.2
/SEND_R_OUT: R92.2, R93.1, U16.7
/SEND_R_S: C57.1, R90.1, R91.1, U15.7
/SUM_L: C38.1, R72.1, R169.1, R172.1, RV14.3, RV16.3, U11.1
/SUM_L_IN: C38.2, R12.2, R27.2, R42.2, R57.2, R70.2, R72.2, U11.2
/SUM_R: C39.1, R73.1, R177.1, R180.1, RV15.3, RV16.6, U11.7
/SUM_R_IN: C39.2, R13.2, R28.2, R43.2, R58.2, R71.2, R73.2, U11.6
/SW_5: C93.2, L3.1, U30.5
/SW_N: C89.1, L2.2, U29.1
/SW_P: D25.2, L1.2, U28.1
/UART_RX: J9.12, U27.6
/UART_TX: J9.11, U27.7
/USB_DN: J10.A7, J10.B7, U26.3, U26.4, U27.2
/USB_DP: J10.A6, J10.B6, U26.1, U26.6, U27.1
/VBAT_SENSE: J9.22, R185.2, R186.1
/VBUS: J10.A4, J10.A9, J10.B4, J10.B9, J11.1, U26.5
/VSW: C86.1, C90.1, C94.1, C95.1, L1.1, L2.1, Q1.3, R185.1, R198.1, U28.4, U28.5, U29.4, U29.5, U30.3
