heartpolik/hardware-pocket-mixer/(commit log)

2026-10-26 Rev A: схеми, дві розведені плати, панель, Gerber і BOM
    - ERC обох схем чистий; DRC обох плат: 0 розривів, 0 порушень міді (ітерація 8)
    - панель KiKit з V-cut у шарі контуру; hw/fab/: Gerber + свердління (zip) і BOM
    - документація docs/00–15, рішення D1–D59
2026-10-26 Дослідження цифрового мікшера на Teensy 4.1 (docs/16-digital.md)
2026-10-26 Два підпроєкти: analog-mixer/ (Rev A) і digital-mixer/ (Teensy 4.1)
    - hw/, docs/ і README Rev A перенесено в analog-mixer/ (git mv, скрипти шукають файли відносно себе)
    - digital-mixer/: README, docs/00-research.md (дослідження), decisions.md (DM1–DM6), datasheets
    - кореневі README і CLAUDE.md описують обидва підпроєкти; .gitignore під нову структуру
    - перевірено з нових шляхів: ERC обох схем 0, DRC аналогової 0 розривів, посилання в .md цілі
2026-10-26 Адреса джерел на шовкографії обох плат (D9, CERN-OHL-S розд. 4)
    - build_pcb.ATTRIB / add_attribution(), hw/pcb/add_silk.py для розведених плат
    - panel.py: файл правил DRC — за іменем файлу (шлях analog-mixer/ ламав відбір)
    - панель і hw/fab перезібрано; DRC: 0 розривів, нових зауважень немає
2026-10-26 digital-mixer: чернетка ТЗ Rev 1 — функціонал, керування, роз'єми, ТТХ
2026-10-26 digital-mixer: вибір компонентів і живлення 1S (DM7–DM12)
    - docs/02-components.md: фейдери 35 мм, EC11, живлення 1S (TP4056 + load sharing +
    TPS63802 4,2 V + LP5907), монтаж Teensy з microSD у стінку, AliExpress проти JLCPCB PCBA
    - docs/calc/power.py: 1,62 W з акумулятора, 3000 mAh -> 6,2 год
    - datasheets: TPS63802, LP5907, TP4056, Bourns PEC09
2026-10-26 digital-mixer: принципова схема (ERC 0 помилок) і ескіз розташування
    - hw/sch/main.py -> hw/main/main.kicad_sch (+ PDF): Teensy 4.1, 2 x PCM1865 (TDM),
    3 x PCM5102A, TPA6132A2, живлення 1S (TP4056, load sharing, TPS63802, LP5907),
    2 x MCP23017, 12 + 1 EC11, 4 фейдери, Kailh Choc PG1350, SK6812MINI-E під Mute
    - hw/lib: символи TPS63802, SJ-43514, Teensy 4.1 (XenGi, MIT); footprint з Rev A
    - docs/03-schematic.md, docs/mech/layout.{py,svg}; рішення DM13-DM15
2026-10-26 digital-mixer: дисплей GMT147SPI, кнопки TSF-1266, живлення кнопкою з фіксацією (DM16-DM18)
    - без адресних LED; FX I/FX II/AUX/CUE на вільних виводах MCP23017, SPI дисплея на Teensy
    - кнопка живлення 7x7 DPDT на EN TPS63802; ERC 0 помилок, нетлист без одиночних кіл
    - макет 108 x 97 мм; живлення 1,48 W -> 6,8 год на 3000 mAh
2026-10-26 digital-mixer: Mute під фейдерами, PHONES на фронті, проміжки 4 мм (DM19)
2026-10-26 digital-mixer: footprint (Teensy 4.1, TPS63802, XFL4015, заглушки), розстановка WIP, DM21-DM23
    - hw/lib/gen_footprints.py: Teensy41_SMD (PJRC), VSON-HR-10 (TI DLA0010A), XFL4015 (Coilcraft),
    M2; заглушки TSF-1266, кнопки 7x7, GMT147SPI - до креслень / вимірів
    - GMT147SPI: порядок виводів за кресленням продавця
    - hw/pcb/pcbkit.py (з Rev A), build_pcb.py: перша розстановка, отвори M2 у кутах;
    конфлікт THT-виводів керування з джеками й Teensy знизу - компоновку треба змінити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
2026-10-26 digital-mixer: компоновка A (DM24), footprint за кресленнями GMT147, TSF-1266, кнопки 7x7
    - розстановка: джеки ззаду, Teensy під Mute (microSD ліворуч), електроніка під правою колонкою,
    M2 у кутах; DRC розстановки: без перетинів корпусів і замикань
    - route_pcb.py / fix_pcb.py для 2 шарів (з Rev A)
2026-10-26 digital-mixer: двошарова плата розведена (DRC: 0 розривів, 0 порушень по міді)
    - Teensy праворуч спереду (microSD у правий торець), USB-C і PHONES на фронті: USB D+/D- ~30 мм
    - блок TPS63802 за прикладом TI, доріжки зафіксовані; конденсатори біля виводів
    - footprint TSF-1266 без подвійного courtyard; route_pcb зберігає зафіксовані доріжки
    - docs/04-pcb.md
2026-10-27 common/: спільні скрипти обох підпроєктів
    kisch (схема), pcbkit (розстановка), route_pcb / fix_pcb / patch_route (трасування),
    fpgen (запис footprint), cq3d (CadQuery-хелпери), tools/ для Freerouting.
    Параметри підпроєктів — у hw/sch/project.py, обгортці analog route_pcb.py, класах FP.
    Rev A перевірено: схеми й footprint генеруються ідентично, fix_pcb дає ті самі 1047 переходів.
2026-10-27 digital-mixer: компоновка C (DM25-DM30), SMD-енкодери, USB4110, розводка 0 помилок
    - компоновка C: колонки каналів на одних осях, ON / дисплей / MASTER в один ряд,
    Teensy у передньому правому куті, виходи на правому торці, M2 у чотирьох кутах
    - EC12SY SMD з кнопками (DM26) + третій MCP23017; кнопку CUE прибрано (DM28)
    - кнопка живлення 5,8 мм SMD (DM27), USB-C GCT USB4110 SMD (DM30), JST PH SMD
    - 33 Ω на тактах I2S / TDM (DM29); такти 60-73 мм замість ~110
    - 3D-моделі для вс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
2026-10-27 digital-mixer: 4 шари (DM31), пара USB D+/D- наперед, розводка 0 помилок
    - плата 4 шари як Rev A: F сигнали / In1 GND / In2 сигнали й живлення / B сигнали; доріжки 0,2 мм
    - USB D+/D- прокладено парою 0,2/0,2 мм над In1 (92,5 / 90,9 мм) і зафіксовано до автороутера
    - кнопки правої колонки повернуті площадкою GND до пари; конденсатори накачки й вихідні
    470 Ом ЦАП, конденсатори TPA6132A2 - біля виводів; TPA6132A2 розвернута до PHONES
    - common: patch_route --ig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
2026-10-27 digital-mixer: Gerber, BOM, PCBA JLCPCB, інтерактивний BOM (05-fab)
    - hw/pcb/fab.py: Gerber 4 шари + свердловка (main-gerber.zip), bom.csv з партномерами,
    кодами LCSC і способом монтажу; jlc/bom-jlc.csv і cpl-jlc.csv (150 деталей нижнього боку);
    docs/ibom/ibom.html (InteractiveHtmlBom, як у mixerli)
    - docs/05-fab.md: параметри плати й PCBA для JLCPCB, коди LCSC з посиланнями, ручний монтаж
    - коди LCSC лише перевірені; TPS63802, USB4110, SJ-43514 - ПЕРЕВІРИТИ
2026-10-27 digital-mixer: виготовлення на NextPCB замість JLCPCB
    - fab.py: BOM для NextPCB (виробник, партномер, Procurement Type DNP для ручного монтажу),
    centroid (csv + zip), монтажні креслення обох боків; партномери пасиву (Samsung, Yageo,
    Panasonic, Lite-On) перевірено на сторінках дистриб'юторів; 665k - ПЕРЕВІРИТИ
    - NextPCB ставить і джеки (158 деталей нижнього боку); файли JLC прибрано
    - docs/05-fab.md: параметри плати й PCBA NextPCB, партномери з посиланнями
    Co-Author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
2026-10-27 digital-mixer: 04-pcb - стек NextPCB замість JLC
2026-10-28 digital-mixer: прошивка 0.1 (ядро C++, Teensy 4.1) і емулятор SDL2 (06-firmware, DM32-DM34)
2026-10-28 digital-mixer: Teensy на гребінках з PSRAM (DM35), прошивка 0.2, GPL-3.0 (DM36)
    Плата: Teensy 4.1 на гребінках у наскрізні отвори (зазор 2,5 мм під PSRAM),
    D-/D+ теж наскрізні, Teensy за 6 мм від переднього краю, бокові джеки з кроком
    12,5 мм, лапки EC12SY укорочено; перерозведено - DRC 0 порушень, 0 розривів.
    Gerber, BOM і файли NextPCB оновлено.
    Прошивка: метри каналів після фейдера (CLIP - лише вхід АЦП), калібрування
    фейдерів, SHIFT HOLD/TOGGLE, MASTER = A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
2026-10-28 digital-mixer: прошивка - версія 0.2
2026-10-28 digital-mixer: BOM і координати для повного монтажу (nextpcb-full), лише Teensy DNP
2026-10-28 digital-mixer: nextpcb-full - дисплей теж DNP
2026-10-28 digital-mixer: uac2 перевірено на Teensy 4.1 (macOS: 8x8, 48 kHz, без розривів), тестові тони USB
2026-10-28 digital-mixer: дисплей - поворот 180 (MADCTL 0xA0), статуси від заокруглених кутів, рівні: цифра, метр, фейдер
2026-10-28 digital-mixer: головний екран - підписи рядів один раз ліворуч, вужчі смужки, рівень над метром і фейдером
2026-10-28 digital-mixer: екран - LVL, підписи праворуч, значення по центру з градієнтом синій-білий-червоний, ефекти трьома літерами
2026-10-28 digital-mixer: екран - градієнт на смужках значень, вузька колонка підписів (3 символи), без повзунка фейдера
2026-10-28 digital-mixer: екран - смужки значень суцільним кольором за положенням, виходи майстра у своїх кольорах
2026-10-28 digital-mixer: екран - колір смужок відносно 0 (білий), до мінімуму синіє, до максимуму червоніє
2026-10-28 digital-mixer: екран - без колонки підписів; ряд у шапці й клітинка підсвічуються, поки їх крутять (1,5 с)
2026-10-28 digital-mixer: екран - режим фільтр / компресор у кожній клітинці ряду 3 (SHIFT)
2026-10-28 digital-mixer: перевірка перед замовленням (07-review): +3V3A у межах LP5907 (DM37), переходи з площадок, дроти USB Teensy, USB-живлення в прошивці
2026-10-28 digital-mixer: тест пам'яті під Teensy (pio run -e memtest), PSRAM 8 МБ перевірено
2026-10-28 digital-mixer: налаштування запису і пульт на ПК для справжнього Teensy
    - REC TRACKS (MAIN 2 / IN 1-4 8 / IN+MAIN 10) і REC BITS (16 / 24) у меню; 8 і 10 доріжок лише з PSRAM
    - src/teensy/remote.h: рядки дисплея й статус через USB serial, команди енкодерів / кнопок / фейдерів з ПК;
    пакет пишеться лише цілим, щоб не губились рядки
    - pocket-mixer-sim --remote: дисплей Teensy, керування з ПК, сервісний блок (CPU, аудіопам'ять, SD,
    запис, PSRAM, I2C)
    - заголовок не перекр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
2026-10-28 digital-mixer: економний варіант монтажу NextPCB (hw/fab/nextpcb-eco)
    Завод ставить лише 7 деталей, які паяльником не запаяти: TPS63802 (VSON), TPA6132A2 (WQFN),
    PCM1865 ×2 (TSSOP 0,5 мм), USB4110 (0,5 мм), TP4056 (площадка під корпусом), XFL4015 (виводи знизу).
    Решта SMD — DNP, паяльником. Опис і порядок пайки — docs/05-fab.md, п. 1.1 і 5.
2026-10-28 digital-mixer: замовлення nextpcb-opt замість економного варіанта
    Як nextpcb/, але джеки SJ-43514 ×8 і PCM1865 ×2 — DNP: купуємо на AliExpress і паяємо самі (збір
    NextPCB рахується від BOM). XFL4015 лишається за заводом. Ціни AliExpress і порівняння — docs/05-fab.md, п. 1.1.
2026-10-28 digital-mixer: кошик AliExpress для nextpcb-opt на 1 плату
2026-10-28 digital-mixer: котировки NextPCB трьох варіантів на 1 плату
2026-10-28 digital-mixer: джеки PJ-327A замість SJ-43514 (DM38)
    - footprint, 3D-модель і символ за кресленням продавця AliExpress (площадки 5 × 2 × 3, контакти:
    4 кінчик, 3 кільце, 1 / 2 гільза, 5 перемикач — вільний); креслення HOOYA / XKB / SOFNG — для звірки
    - розведена плата: 8 джеків замінено латками, передній торець по краю, носик 2 мм назовні; J8 зсунуто
    на 0,4 мм (напрямна біля кнопки AUX); заборонні зони під нові отвори; DRC 0, розривів 0, с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
2026-10-29 digital-mixer: Hi-Z вхід для гітари — у покращення наступної версії
2026-10-29 digital-mixer: котировка nextpcb-opt після DM38 — без змін
2026-10-29 digital-mixer: фейдери Alps RS201111J011 замість Bourns PTA2043 (DM39)
    Footprint і 3D-модель за кресленням № 1 каталогу Alps (і продавця): 3 виводи Ø1,5,
    25 і 3,75 мм. Центр ходу на старому місці; на розведеній платі R12/R13/R48 зсунуто,
    38 з'єднань проведено заново. ERC 0, DRC 0 порушень, 0 розривів, 0 розбіжностей.
2026-10-29 digital-mixer: кріпильні отвори M2 на корпусі фейдера (3D-модель, F.Fab)
