heartpolik/hardware-pocket-mixer/(notices)

Notices in the files:
analog-mixer/hw/digital/digital_routed.kicad_pcb:
hardware-pocket-mixer Rev A CERN-OHL-S-2.0+
